ooropuloo/MFKVM/lay-board/r7f/kicad/README.txt

r7b design files, copied from out/ after the final check (board sha256 2acf1c0fcd2acbffd97f6878b55f344319c8f6496172503f295ab0cfc3b03e46).
They are the files fab_r7b/ was made from. Regenerate with gen_mini.py; do not edit these by hand.
