ooropuloo/MFKVM/lay-board/r7f/case/check_report.txt

===== NEW: mini/case/stl, must pass =====
board p4_kvm_mini.kicad_pcb sha256 bd67d82cb2569ef1, solids 508, outline 40.00 x 40.00, thru-plated 12
PASS  Gerber pad positions agree with STEP pad solids  [misses F 0 B 0, of 176 + 319]
PASS  board top is +z in the STEP
PASS  four screw holes found in the board  [[(18.0, 18.0, 2.2), (-18.0, 18.0, 2.2), (18.0, -18.0, 2.2), (-18.0, -18.0, 2.2)]]
real connector centres in the case frame: J2 (8.00, -12.86) nearest wall -y, J3 (-8.75, -14.61) nearest wall -y, J5 (-14.61, 2.50) nearest wall -x, J7 (19.01, 4.20) nearest wall +x, J4 (3.70, 14.90) nearest wall +y, J6 (-11.25, 13.30) nearest wall +y
standing outside the I/O face (-y) +x is on your right: J3 LEFT, J2 RIGHT
PASS  real J3 is left of real J2, seen from outside the I/O face
PASS  connector sides as the z windows below assume  [J3 J5 J6 top, J2 J7 J4 bottom]
PASS  tray STL and STEP are the same part  [volume differs 0.01%]
PASS  lid STL and STEP are the same part  [volume differs 0.03%]
PASS  J2 on the -y wall is the wall nearest its real position  [nearest -y]
PASS  J2 opening in -y wall clears the HDMI shell 15 x 6  [0.00 mm2 of wall in the way at u 8.00]
PASS  J2 opening centred on the connector  [offset +0.00, opening u -0.10..16.10 z 2.10..8.90]
PASS  J2 plug overmould 19.5 x 11.0 fits its pocket  [0.00 mm2 in the way]
PASS  J3 on the -y wall is the wall nearest its real position  [nearest -y]
PASS  J3 opening in -y wall clears the USB-C shell 8.94 x 3.2  [0.00 mm2 of wall in the way at u -8.75]
PASS  J3 opening centred on the connector  [offset +0.00, opening u -13.70..-3.80 z 9.25..13.35]
PASS  J3 plug overmould 12.0 x 8.0 fits its pocket  [0.00 mm2 in the way]
PASS  J5 on the -x wall is the wall nearest its real position  [nearest -x]
PASS  J5 opening in -x wall clears the USB-C shell 8.94 x 3.2  [0.00 mm2 of wall in the way at u 2.50]
PASS  J5 opening centred on the connector  [offset +0.00, opening u -2.45..7.45 z 9.25..13.35]
PASS  J5 plug overmould 12.0 x 8.0 fits its pocket  [0.00 mm2 in the way]
PASS  J7 on the +x wall is the wall nearest its real position  [nearest +x]
PASS  J7 opening in +x wall clears the card 11 wide at the shell  [0.00 mm2 of wall in the way at u 4.20]
PASS  J7 opening centred on the connector  [offset -0.10, opening u -2.20..10.40 z 6.30..8.45]
PASS  J4 on the +y wall is the wall nearest its real position  [nearest +y]
PASS  J4 opening in +y wall clears the SHR-06V plug 8 wide  [0.00 mm2 of wall in the way at u 3.70]
PASS  J4 opening centred on the connector  [offset -0.00, opening u -0.90..8.30 z 3.90..8.45]
PASS  HDMI and host USB plugs fit side by side  [1.00 mm between overmoulds]
PASS  label HDMI is cut in the -y wall beside J2  [text u 4.6..9.4 z 14.1..15.6, connector u 8.00]
PASS  label MF KVM is cut in the -y wall beside J2  [text u 1.2..12.8 z 15.9..18.3, connector u 8.00]
PASS  label HOST is cut in the -y wall beside J3  [text u -11.3..-6.1 z 16.4..18.1, connector u -8.75]
PASS  label 5V is cut in the -x wall beside J5  [text u 1.2..3.7 z 16.4..18.1, connector u 2.50]
PASS  label TF is cut in the +x wall beside J7  [text u 2.8..5.3 z 10.2..11.9, connector u 4.20]
PASS  label ATX is cut in the +y wall beside J4  [text u 1.7..5.7 z 9.7..11.4, connector u 3.70]
vents -y 0, +y 4, -x 9, +x 0
PASS  no vents on the +x (microSD) wall or the I/O wall
PASS  -x wall vent beside U7  [U7 real at (-5.50, -4.00), nearest slot 0.70 mm along the wall]
PASS  -x wall vent beside U2  [U2 real at (-14.00, 10.08), nearest slot 1.38 mm along the wall]
PASS  -x wall vent beside L1  [L1 real at (-13.60, 13.90), nearest slot 0.80 mm along the wall]
PASS  back wall vent behind the buck stage  [0.90 mm from L1 along the wall]
PASS  tray clearance bore at (18, 18) lines up  [d 2.4, offset 0.0]
PASS  tray head recess at (18, 18) takes the M2 head  [d 4.2]
PASS  tray post at (18, 18) seats the PCB at z 8.5  [10.7 of 11.4 mm2]
PASS  lid pilot at (18, 18) lines up at z 16.0  [d 1.6, wall 1.10]
PASS  lid post at (18, 18) is whole down at the PCB  [d 1.6, wall 1.10]
PASS  lid post at (18, 18) meets the PCB top  [6.9 of 6.9 mm2]
PASS  tray clearance bore at (-18, 18) lines up  [d 2.4, offset 0.0]
PASS  tray head recess at (-18, 18) takes the M2 head  [d 4.2]
PASS  tray post at (-18, 18) seats the PCB at z 8.5  [10.7 of 11.4 mm2]
PASS  lid pilot at (-18, 18) lines up at z 16.0  [d 1.6, wall 1.10]
PASS  J6 corner (-18, 18): the thread has no thin wall beside J6  [post starts above the J6 relief]
PASS  tray clearance bore at (18, -18) lines up  [d 2.4, offset 0.0]
PASS  tray head recess at (18, -18) takes the M2 head  [d 4.2]
PASS  tray post at (18, -18) seats the PCB at z 8.5  [10.7 of 11.4 mm2]
PASS  lid pilot at (18, -18) lines up at z 16.0  [d 1.6, wall 1.10]
PASS  lid post at (18, -18) is whole down at the PCB  [d 1.6, wall 1.10]
PASS  lid post at (18, -18) meets the PCB top  [6.9 of 6.9 mm2]
PASS  tray clearance bore at (-18, -18) lines up  [d 2.4, offset 0.0]
PASS  tray head recess at (-18, -18) takes the M2 head  [d 4.2]
PASS  tray post at (-18, -18) seats the PCB at z 8.5  [10.7 of 11.4 mm2]
PASS  lid pilot at (-18, -18) lines up at z 16.0  [d 1.6, wall 1.10]
PASS  lid post at (-18, -18) is whole down at the PCB  [d 1.6, wall 1.10]
PASS  lid post at (-18, -18) meets the PCB top  [6.9 of 6.9 mm2]
PASS  M2 x 16 tip stops inside the pilot  [seat z 1.8, tip z 17.8, pilot top z 18.4]
PASS  thread engagement in the J6 corner is at least 1.5 x d  [3.5 mm]
PASS  every part envelope holds its real pads after the design-to-case map  [106 parts]
PASS  no part body touches the tray or lid  [none]
PASS  real PCB solid (outline, holes, slots) against tray and lid  [tray 0.000, lid 0.000 mm3]
PASS  PCB z in the case is the stack height  [8.54..9.65]
PASS  tray against lid  [0.000 mm3]
PASS  LCD module (estimate) against lid and tray  [lid 0.000, tray 0.000 mm3]
PASS  LCD clears the tallest top-side part  [LCD bottom 15.40, tallest top 13.95]
J6 mouth faces -x, plug and wire keep-out x -19.02..-16.32 y 8.80..17.80 z 9.7..12.6
PASS  J6 plug and wires clear the lid  [0.00 mm3]
PASS  M2 shank clears the J6 envelope  [0.37 mm]
tray bbox 44.00 x 44.00 x 13.80, lid bbox 44.00 x 44.00 x 10.30
RESULT PASS: 71 passed, 0 failed, case files mini\case\stl

===== OLD mirrored case, kept to prove this check can fail =====
board p4_kvm_mini.kicad_pcb sha256 bd67d82cb2569ef1, solids 508, outline 40.00 x 40.00, thru-plated 12
PASS  Gerber pad positions agree with STEP pad solids  [misses F 0 B 0, of 176 + 319]
PASS  board top is +z in the STEP
PASS  four screw holes found in the board  [[(18.0, 18.0, 2.2), (-18.0, 18.0, 2.2), (18.0, -18.0, 2.2), (-18.0, -18.0, 2.2)]]
real connector centres in the case frame: J2 (8.00, -12.86) nearest wall -y, J3 (-8.75, -14.61) nearest wall -y, J5 (-14.61, 2.50) nearest wall -x, J7 (19.01, 4.20) nearest wall +x, J4 (3.70, 14.90) nearest wall +y, J6 (-11.25, 13.30) nearest wall +y
standing outside the I/O face (-y) +x is on your right: J3 LEFT, J2 RIGHT
PASS  real J3 is left of real J2, seen from outside the I/O face
PASS  connector sides as the z windows below assume  [J3 J5 J6 top, J2 J7 J4 bottom]
PASS  tray STL and STEP are the same part  [volume differs 0.01%]
PASS  lid STL and STEP are the same part  [volume differs 0.02%]
PASS  J2 on the -y wall is the wall nearest its real position  [nearest -y]
FAIL  J2 opening in -y wall clears the HDMI shell 15 x 6  [90.00 mm2 of wall in the way at u 8.00]
FAIL  J2 opening centred on the connector  [no opening at the connector centre]
FAIL  J2 plug overmould 19.5 x 11.0 fits its pocket  [120.50 mm2 in the way]
PASS  J3 on the -y wall is the wall nearest its real position  [nearest -y]
FAIL  J3 opening in -y wall clears the USB-C shell 8.94 x 3.2  [26.40 mm2 of wall in the way at u -8.75]
FAIL  J3 opening centred on the connector  [no opening at the connector centre]
FAIL  J3 plug overmould 12.0 x 8.0 fits its pocket  [46.80 mm2 in the way]
PASS  J5 on the -x wall is the wall nearest its real position  [nearest -x]
FAIL  J5 opening in -x wall clears the USB-C shell 8.94 x 3.2  [26.40 mm2 of wall in the way at u 2.50]
FAIL  J5 opening centred on the connector  [no opening at the connector centre]
FAIL  J5 plug overmould 12.0 x 8.0 fits its pocket  [69.60 mm2 in the way]
PASS  J7 on the +x wall is the wall nearest its real position  [nearest +x]
FAIL  J7 opening in +x wall clears the card 11 wide at the shell  [11.22 mm2 of wall in the way at u 4.20]
FAIL  J7 opening centred on the connector  [no opening at the connector centre]
PASS  J4 on the +y wall is the wall nearest its real position  [nearest +y]
FAIL  J4 opening in +y wall clears the SHR-06V plug 8 wide  [18.84 mm2 of wall in the way at u 3.70]
FAIL  J4 opening centred on the connector  [no opening at the connector centre]
PASS  HDMI and host USB plugs fit side by side  [1.00 mm between overmoulds]
FAIL  label HDMI is cut in the -y wall beside J2  [no cut there]
FAIL  label MF KVM is cut in the -y wall beside J2  [text u 6.2..11.4 z 16.4..18.1, connector u 8.00]
FAIL  label HOST is cut in the -y wall beside J3  [text u -12.8..-1.2 z 15.9..18.3, connector u -8.75]
FAIL  label 5V is cut in the -x wall beside J5  [no cut there]
FAIL  label TF is cut in the +x wall beside J7  [no cut there]
FAIL  label ATX is cut in the +y wall beside J4  [text u -5.7..-1.7 z 9.7..11.4, connector u 3.70]
vents -y 0, +y 5, -x 0, +x 6
FAIL  no vents on the +x (microSD) wall or the I/O wall
FAIL  -x wall vent beside U7  [U7 real at (-5.50, -4.00), nearest slot 99.00 mm along the wall]
FAIL  -x wall vent beside U2  [U2 real at (-14.00, 10.08), nearest slot 99.00 mm along the wall]
FAIL  -x wall vent beside L1  [L1 real at (-13.60, 13.90), nearest slot 99.00 mm along the wall]
FAIL  back wall vent behind the buck stage  [20.30 mm from L1 along the wall]
PASS  tray clearance bore at (18, 18) lines up  [d 2.4, offset 0.0]
PASS  tray head recess at (18, 18) takes the M2 head  [d 4.2]
PASS  tray post at (18, 18) seats the PCB at z 8.5  [10.7 of 11.4 mm2]
PASS  lid pilot at (18, 18) lines up at z 16.0  [d 1.6, wall 1.10]
FAIL  lid post at (18, 18) is whole down at the PCB  [d 1.6, wall 0.27]
PASS  lid post at (18, 18) meets the PCB top  [5.4 of 6.9 mm2]
PASS  tray clearance bore at (-18, 18) lines up  [d 2.4, offset 0.0]
PASS  tray head recess at (-18, 18) takes the M2 head  [d 4.2]
PASS  tray post at (-18, 18) seats the PCB at z 8.5  [10.7 of 11.4 mm2]
PASS  lid pilot at (-18, 18) lines up at z 16.0  [d 1.6, wall 1.10]
PASS  J6 corner (-18, 18): the thread has no thin wall beside J6  [post runs down beside J6]
PASS  tray clearance bore at (18, -18) lines up  [d 2.4, offset 0.0]
PASS  tray head recess at (18, -18) takes the M2 head  [d 4.2]
PASS  tray post at (18, -18) seats the PCB at z 8.5  [10.7 of 11.4 mm2]
PASS  lid pilot at (18, -18) lines up at z 16.0  [d 1.6, wall 1.10]
PASS  lid post at (18, -18) is whole down at the PCB  [d 1.6, wall 1.10]
PASS  lid post at (18, -18) meets the PCB top  [6.9 of 6.9 mm2]
PASS  tray clearance bore at (-18, -18) lines up  [d 2.4, offset 0.0]
PASS  tray head recess at (-18, -18) takes the M2 head  [d 4.2]
PASS  tray post at (-18, -18) seats the PCB at z 8.5  [10.7 of 11.4 mm2]
PASS  lid pilot at (-18, -18) lines up at z 16.0  [d 1.6, wall 1.10]
PASS  lid post at (-18, -18) is whole down at the PCB  [d 1.6, wall 1.10]
PASS  lid post at (-18, -18) meets the PCB top  [6.9 of 6.9 mm2]
PASS  M2 x 16 tip stops inside the pilot  [seat z 1.8, tip z 17.8, pilot top z 18.4]
PASS  thread engagement in the J6 corner is at least 1.5 x d  [3.5 mm]
PASS  every part envelope holds its real pads after the design-to-case map  [106 parts]
FAIL  no part body touches the tray or lid  [[('J3', 6.17, 3.04), ('J5', 6.17, 3.04), ('J6', 0.0, 2.65), ('J2', 18.0, 0.0)]]
PASS  real PCB solid (outline, holes, slots) against tray and lid  [tray 0.000, lid 0.000 mm3]
PASS  PCB z in the case is the stack height  [8.54..9.65]
PASS  tray against lid  [0.000 mm3]
PASS  LCD module (estimate) against lid and tray  [lid 0.000, tray 0.000 mm3]
PASS  LCD clears the tallest top-side part  [LCD bottom 15.40, tallest top 13.95]
J6 mouth faces -x, plug and wire keep-out x -19.02..-16.32 y 8.80..17.80 z 9.7..12.6
FAIL  J6 plug and wires clear the lid  [9.62 mm3]
PASS  M2 shank clears the J6 envelope  [0.37 mm]
tray bbox 44.00 x 44.00 x 13.80, lid bbox 44.00 x 44.00 x 10.30
RESULT FAIL: 44 passed, 27 failed, case files <temp>\case_old

===== r4 board re-check: case files unchanged (STL byte-identical when regenerated) =====
board p4_kvm_mini.kicad_pcb sha256 0134dfaaa7eec6bd, solids 508, outline 40.00 x 40.00, thru-plated 12
PASS  Gerber pad positions agree with STEP pad solids  [misses F 0 B 0, of 176 + 319]
PASS  board top is +z in the STEP
PASS  four screw holes found in the board  [[(18.0, 18.0, 2.2), (-18.0, 18.0, 2.2), (18.0, -18.0, 2.2), (-18.0, -18.0, 2.2)]]
real connector centres in the case frame: J2 (8.00, -12.86) nearest wall -y, J3 (-8.75, -14.61) nearest wall -y, J5 (-14.61, 2.50) nearest wall -x, J7 (19.01, 4.20) nearest wall +x, J4 (3.70, 14.90) nearest wall +y, J6 (-11.25, 13.30) nearest wall +y
standing outside the I/O face (-y) +x is on your right: J3 LEFT, J2 RIGHT
PASS  real J3 is left of real J2, seen from outside the I/O face
PASS  connector sides as the z windows below assume  [J3 J5 J6 top, J2 J7 J4 bottom]
PASS  tray STL and STEP are the same part  [volume differs 0.01%]
PASS  lid STL and STEP are the same part  [volume differs 0.03%]
PASS  J2 on the -y wall is the wall nearest its real position  [nearest -y]
PASS  J2 opening in -y wall clears the HDMI shell 15 x 6  [0.00 mm2 of wall in the way at u 8.00]
PASS  J2 opening centred on the connector  [offset +0.00, opening u -0.10..16.10 z 2.10..8.90]
PASS  J2 plug overmould 19.5 x 11.0 fits its pocket  [0.00 mm2 in the way]
PASS  J3 on the -y wall is the wall nearest its real position  [nearest -y]
PASS  J3 opening in -y wall clears the USB-C shell 8.94 x 3.2  [0.00 mm2 of wall in the way at u -8.75]
PASS  J3 opening centred on the connector  [offset +0.00, opening u -13.70..-3.80 z 9.25..13.35]
PASS  J3 plug overmould 12.0 x 8.0 fits its pocket  [0.00 mm2 in the way]
PASS  J5 on the -x wall is the wall nearest its real position  [nearest -x]
PASS  J5 opening in -x wall clears the USB-C shell 8.94 x 3.2  [0.00 mm2 of wall in the way at u 2.50]
PASS  J5 opening centred on the connector  [offset +0.00, opening u -2.45..7.45 z 9.25..13.35]
PASS  J5 plug overmould 12.0 x 8.0 fits its pocket  [0.00 mm2 in the way]
PASS  J7 on the +x wall is the wall nearest its real position  [nearest +x]
PASS  J7 opening in +x wall clears the card 11 wide at the shell  [0.00 mm2 of wall in the way at u 4.20]
PASS  J7 opening centred on the connector  [offset -0.10, opening u -2.20..10.40 z 6.30..8.45]
PASS  J4 on the +y wall is the wall nearest its real position  [nearest +y]
PASS  J4 opening in +y wall clears the SHR-06V plug 8 wide  [0.00 mm2 of wall in the way at u 3.70]
PASS  J4 opening centred on the connector  [offset -0.00, opening u -0.90..8.30 z 3.90..8.45]
PASS  HDMI and host USB plugs fit side by side  [1.00 mm between overmoulds]
PASS  label HDMI is cut in the -y wall beside J2  [text u 4.6..9.4 z 14.1..15.6, connector u 8.00]
PASS  label MF KVM is cut in the -y wall beside J2  [text u 1.2..12.8 z 15.9..18.3, connector u 8.00]
PASS  label HOST is cut in the -y wall beside J3  [text u -11.3..-6.1 z 16.4..18.1, connector u -8.75]
PASS  label 5V is cut in the -x wall beside J5  [text u 1.2..3.7 z 16.4..18.1, connector u 2.50]
PASS  label TF is cut in the +x wall beside J7  [text u 2.8..5.3 z 10.2..11.9, connector u 4.20]
PASS  label ATX is cut in the +y wall beside J4  [text u 1.7..5.7 z 9.7..11.4, connector u 3.70]
vents -y 0, +y 4, -x 9, +x 0
PASS  no vents on the +x (microSD) wall or the I/O wall
PASS  -x wall vent beside U7  [U7 real at (-5.50, -4.00), nearest slot 0.70 mm along the wall]
PASS  -x wall vent beside U2  [U2 real at (-14.00, 10.08), nearest slot 1.38 mm along the wall]
PASS  -x wall vent beside L1  [L1 real at (-13.60, 13.90), nearest slot 0.80 mm along the wall]
PASS  back wall vent behind the buck stage  [0.90 mm from L1 along the wall]
PASS  tray clearance bore at (18, 18) lines up  [d 2.4, offset 0.0]
PASS  tray head recess at (18, 18) takes the M2 head  [d 4.2]
PASS  tray post at (18, 18) seats the PCB at z 8.5  [10.7 of 11.4 mm2]
PASS  lid pilot at (18, 18) lines up at z 16.0  [d 1.6, wall 1.10]
PASS  lid post at (18, 18) is whole down at the PCB  [d 1.6, wall 1.10]
PASS  lid post at (18, 18) meets the PCB top  [6.9 of 6.9 mm2]
PASS  tray clearance bore at (-18, 18) lines up  [d 2.4, offset 0.0]
PASS  tray head recess at (-18, 18) takes the M2 head  [d 4.2]
PASS  tray post at (-18, 18) seats the PCB at z 8.5  [10.7 of 11.4 mm2]
PASS  lid pilot at (-18, 18) lines up at z 16.0  [d 1.6, wall 1.10]
PASS  J6 corner (-18, 18): the thread has no thin wall beside J6  [post starts above the J6 relief]
PASS  tray clearance bore at (18, -18) lines up  [d 2.4, offset 0.0]
PASS  tray head recess at (18, -18) takes the M2 head  [d 4.2]
PASS  tray post at (18, -18) seats the PCB at z 8.5  [10.7 of 11.4 mm2]
PASS  lid pilot at (18, -18) lines up at z 16.0  [d 1.6, wall 1.10]
PASS  lid post at (18, -18) is whole down at the PCB  [d 1.6, wall 1.10]
PASS  lid post at (18, -18) meets the PCB top  [6.9 of 6.9 mm2]
PASS  tray clearance bore at (-18, -18) lines up  [d 2.4, offset 0.0]
PASS  tray head recess at (-18, -18) takes the M2 head  [d 4.2]
PASS  tray post at (-18, -18) seats the PCB at z 8.5  [10.7 of 11.4 mm2]
PASS  lid pilot at (-18, -18) lines up at z 16.0  [d 1.6, wall 1.10]
PASS  lid post at (-18, -18) is whole down at the PCB  [d 1.6, wall 1.10]
PASS  lid post at (-18, -18) meets the PCB top  [6.9 of 6.9 mm2]
PASS  M2 x 16 tip stops inside the pilot  [seat z 1.8, tip z 17.8, pilot top z 18.4]
PASS  thread engagement in the J6 corner is at least 1.5 x d  [3.5 mm]
PASS  every part envelope holds its real pads after the design-to-case map  [106 parts]
PASS  no part body touches the tray or lid  [none]
PASS  real PCB solid (outline, holes, slots) against tray and lid  [tray 0.000, lid 0.000 mm3]
PASS  PCB z in the case is the stack height  [8.54..9.65]
PASS  tray against lid  [0.000 mm3]
PASS  LCD module (estimate) against lid and tray  [lid 0.000, tray 0.000 mm3]
PASS  LCD clears the tallest top-side part  [LCD bottom 15.40, tallest top 13.95]
J6 mouth faces -x, plug and wire keep-out x -19.02..-16.32 y 8.80..17.80 z 9.7..12.6
PASS  J6 plug and wires clear the lid  [0.00 mm3]
PASS  M2 shank clears the J6 envelope  [0.88 mm]
tray bbox 44.00 x 44.00 x 13.80, lid bbox 44.00 x 44.00 x 10.30
RESULT PASS: 71 passed, 0 failed, case files mini\case\stl

===== r5 board re-check: hole relief only, case files unchanged =====
board p4_kvm_mini.kicad_pcb sha256 4fcf3c612922adf4, solids 508, outline 40.00 x 40.00, thru-plated 12
PASS  Gerber pad positions agree with STEP pad solids  [misses F 0 B 0, of 176 + 319]
PASS  board top is +z in the STEP
PASS  four screw holes found in the board  [[(18.0, 18.0, 2.2), (-18.0, 18.0, 2.2), (18.0, -18.0, 2.2), (-18.0, -18.0, 2.2)]]
real connector centres in the case frame: J2 (8.00, -12.86) nearest wall -y, J3 (-8.75, -14.61) nearest wall -y, J5 (-14.61, 2.50) nearest wall -x, J7 (19.01, 4.20) nearest wall +x, J4 (3.70, 14.90) nearest wall +y, J6 (-11.25, 13.30) nearest wall +y
standing outside the I/O face (-y) +x is on your right: J3 LEFT, J2 RIGHT
PASS  real J3 is left of real J2, seen from outside the I/O face
PASS  connector sides as the z windows below assume  [J3 J5 J6 top, J2 J7 J4 bottom]
PASS  tray STL and STEP are the same part  [volume differs 0.01%]
PASS  lid STL and STEP are the same part  [volume differs 0.03%]
PASS  J2 on the -y wall is the wall nearest its real position  [nearest -y]
PASS  J2 opening in -y wall clears the HDMI shell 15 x 6  [0.00 mm2 of wall in the way at u 8.00]
PASS  J2 opening centred on the connector  [offset +0.00, opening u -0.10..16.10 z 2.10..8.90]
PASS  J2 plug overmould 19.5 x 11.0 fits its pocket  [0.00 mm2 in the way]
PASS  J3 on the -y wall is the wall nearest its real position  [nearest -y]
PASS  J3 opening in -y wall clears the USB-C shell 8.94 x 3.2  [0.00 mm2 of wall in the way at u -8.75]
PASS  J3 opening centred on the connector  [offset +0.00, opening u -13.70..-3.80 z 9.25..13.35]
PASS  J3 plug overmould 12.0 x 8.0 fits its pocket  [0.00 mm2 in the way]
PASS  J5 on the -x wall is the wall nearest its real position  [nearest -x]
PASS  J5 opening in -x wall clears the USB-C shell 8.94 x 3.2  [0.00 mm2 of wall in the way at u 2.50]
PASS  J5 opening centred on the connector  [offset +0.00, opening u -2.45..7.45 z 9.25..13.35]
PASS  J5 plug overmould 12.0 x 8.0 fits its pocket  [0.00 mm2 in the way]
PASS  J7 on the +x wall is the wall nearest its real position  [nearest +x]
PASS  J7 opening in +x wall clears the card 11 wide at the shell  [0.00 mm2 of wall in the way at u 4.20]
PASS  J7 opening centred on the connector  [offset -0.10, opening u -2.20..10.40 z 6.30..8.45]
PASS  J4 on the +y wall is the wall nearest its real position  [nearest +y]
PASS  J4 opening in +y wall clears the SHR-06V plug 8 wide  [0.00 mm2 of wall in the way at u 3.70]
PASS  J4 opening centred on the connector  [offset -0.00, opening u -0.90..8.30 z 3.90..8.45]
PASS  HDMI and host USB plugs fit side by side  [1.00 mm between overmoulds]
PASS  label HDMI is cut in the -y wall beside J2  [text u 4.6..9.4 z 14.1..15.6, connector u 8.00]
PASS  label MF KVM is cut in the -y wall beside J2  [text u 1.2..12.8 z 15.9..18.3, connector u 8.00]
PASS  label HOST is cut in the -y wall beside J3  [text u -11.3..-6.1 z 16.4..18.1, connector u -8.75]
PASS  label 5V is cut in the -x wall beside J5  [text u 1.2..3.7 z 16.4..18.1, connector u 2.50]
PASS  label TF is cut in the +x wall beside J7  [text u 2.8..5.3 z 10.2..11.9, connector u 4.20]
PASS  label ATX is cut in the +y wall beside J4  [text u 1.7..5.7 z 9.7..11.4, connector u 3.70]
vents -y 0, +y 4, -x 9, +x 0
PASS  no vents on the +x (microSD) wall or the I/O wall
PASS  -x wall vent beside U7  [U7 real at (-5.50, -4.00), nearest slot 0.70 mm along the wall]
PASS  -x wall vent beside U2  [U2 real at (-14.00, 10.08), nearest slot 1.38 mm along the wall]
PASS  -x wall vent beside L1  [L1 real at (-13.60, 13.90), nearest slot 0.80 mm along the wall]
PASS  back wall vent behind the buck stage  [0.90 mm from L1 along the wall]
PASS  tray clearance bore at (18, 18) lines up  [d 2.4, offset 0.0]
PASS  tray head recess at (18, 18) takes the M2 head  [d 4.2]
PASS  tray post at (18, 18) seats the PCB at z 8.5  [10.7 of 11.4 mm2]
PASS  lid pilot at (18, 18) lines up at z 16.0  [d 1.6, wall 1.10]
PASS  lid post at (18, 18) is whole down at the PCB  [d 1.6, wall 1.10]
PASS  lid post at (18, 18) meets the PCB top  [6.9 of 6.9 mm2]
PASS  tray clearance bore at (-18, 18) lines up  [d 2.4, offset 0.0]
PASS  tray head recess at (-18, 18) takes the M2 head  [d 4.2]
PASS  tray post at (-18, 18) seats the PCB at z 8.5  [10.7 of 11.4 mm2]
PASS  lid pilot at (-18, 18) lines up at z 16.0  [d 1.6, wall 1.10]
PASS  J6 corner (-18, 18): the thread has no thin wall beside J6  [post starts above the J6 relief]
PASS  tray clearance bore at (18, -18) lines up  [d 2.4, offset 0.0]
PASS  tray head recess at (18, -18) takes the M2 head  [d 4.2]
PASS  tray post at (18, -18) seats the PCB at z 8.5  [10.7 of 11.4 mm2]
PASS  lid pilot at (18, -18) lines up at z 16.0  [d 1.6, wall 1.10]
PASS  lid post at (18, -18) is whole down at the PCB  [d 1.6, wall 1.10]
PASS  lid post at (18, -18) meets the PCB top  [6.9 of 6.9 mm2]
PASS  tray clearance bore at (-18, -18) lines up  [d 2.4, offset 0.0]
PASS  tray head recess at (-18, -18) takes the M2 head  [d 4.2]
PASS  tray post at (-18, -18) seats the PCB at z 8.5  [10.7 of 11.4 mm2]
PASS  lid pilot at (-18, -18) lines up at z 16.0  [d 1.6, wall 1.10]
PASS  lid post at (-18, -18) is whole down at the PCB  [d 1.6, wall 1.10]
PASS  lid post at (-18, -18) meets the PCB top  [6.9 of 6.9 mm2]
PASS  M2 x 16 tip stops inside the pilot  [seat z 1.8, tip z 17.8, pilot top z 18.4]
PASS  thread engagement in the J6 corner is at least 1.5 x d  [3.5 mm]
PASS  every part envelope holds its real pads after the design-to-case map  [106 parts]
PASS  no part body touches the tray or lid  [none]
PASS  real PCB solid (outline, holes, slots) against tray and lid  [tray 0.000, lid 0.000 mm3]
PASS  PCB z in the case is the stack height  [8.54..9.65]
PASS  tray against lid  [0.000 mm3]
PASS  LCD module (estimate) against lid and tray  [lid 0.000, tray 0.000 mm3]
PASS  LCD clears the tallest top-side part  [LCD bottom 15.40, tallest top 13.95]
J6 mouth faces -x, plug and wire keep-out x -19.02..-16.32 y 8.80..17.80 z 9.7..12.6
PASS  J6 plug and wires clear the lid  [0.00 mm3]
PASS  M2 shank clears the J6 envelope  [0.88 mm]
tray bbox 44.00 x 44.00 x 13.80, lid bbox 44.00 x 44.00 x 10.30
RESULT PASS: 71 passed, 0 failed, case files mini\case\stl
