ooropuloo/MFKVM/lay-board/r7f/PROGRESS.md

# v2_r7f progress (six approved changes: eFuse, CEC ESD, SD 22 ohm, LCD 33 ohm, metal lid + spreader)

Copied from v2_r7e at 07:35 on 2026-11-09 (without .venv-case, rebuilt locally with tools/setup_case_env.sh). v2_r7e and older are not touched.
analysis_r7d copied to analysis_r7f (thermal .venv not copied; the r7d one is used read-only as the interpreter).

| Time | Phase | Status |
|---|---|---|
| 07:35 | 0. Copy and path fix | Done. check.sh, route_until_clean.sh, r6/route.sh, setup_case_env.sh point to v2_r7f. .venv-case built (cadquery 2.8.0). |
| 07:50 | 1. Parts and datasheets | TPS2595 (TI SLVSE57C) and TPD1E10B06 (SLLSEB1G) datasheets in datasheets_r7f/. eFuse: TPS259531DSGR (5.7 V output clamp, auto-retry, active-high EN), LCSC C2155674. Read-only stock search: tools/jlc_search.py. Placement study: LCD resistors do not fit in the 0.43 mm gap between U1 and J6 pads; SD resistors go on B beside the first via. |
| 08:40 | 2. eFuse, CEC, holes | U16 TPS259531DSGR on B between the J5 shell legs (C70 1 uF in, C71 100 nF dV/dt 0.42 V/ms, R71/R72 100k/47k UVLO 3.75/3.44 V, R73 1k ILIM 2.04 A typ / 1.89 A min). J5 side of the old 5V is now VBUS_IN; 5V leaves pin 5 through two 0.5 mm vias and In2 to the old 5V track and to the U6 branch. D1 TPD1E10B06 on F between the CEC via and a GND via. H1-H4 plated, GND, 3.1 mm pad (0.2 mm from the corner chamfer). |
| 09:00 | 3. Cold start | tools/coldstart.py sim_ef(): attach transient 3.6-4.5 A for ~10 us, 4.7-6.1 uC before the eFuse conducts, vs 8-13 A / 83-92 uC for the USB 2.0 10 uF + 44 ohm reference on the same port: no worse in every corner. Full load starts cleanly on bench / 3 A / 1.5 A sources (3V3 at 8.7 ms, CHIP_PU 21 ms); on 1.0 A and 0.55 A ports it does not (5V parks near 2.4 V). tools/hotplug.py: VBUS_IN ring 10.3 V worst (IN abs max 20 V), EN 3.3 V (abs max 7 V). |
| 09:50 | 4. SD resistors | No 0402 fits between a module SD pad and its first via (via 0.1 mm from the pad end; LDO_VO4 on F, J7 body on B). R74-R79 in a block on B / F next to the escape vias; Freerouting (data/r7f_route.ses) and a grid A* (tools/r7f_astar.py, data/r7f_hand.json) for what the router left open. Several placement rounds; see the report. |
| 09:50 | 5. Case | gen_case.py: Al lid from z 14.6, 0.8 mm plate at 13.8-14.6 with J6 cut-out and post holes, post shoulders clamp the plate, 12 slots (72 mm2) behind the LCD seat, gap filler P4 12x12 + C6 7x7, materials in case_spec.json. check_case.py: 17 new checks; 88/88 on the r7f board. |
| 10:20 | 6. LCD resistors | Option A (no reply to the question): R80/R81 33 ohm 0201 (C320843) in line at U1.24/25, J6 +0.65 mm, J6 plane escapes re-made (r7e _escape), C63.1 strap moved to J6.8's new via. check_case's J6 shank check was an x gap written for the old hole at y 18; now the true 2-D distance (the case mutation moves J6 toward the screw in x and y). |
| 10:40 | 7. SD routing closed | Final: R76/R77/R78 rows on B west of the D0/D1/D2 escape vias, R74 (CLK) on B east of them, R75 (CMD) at the B west edge, R79 (D3) on F in place of D3's escape vertical; R78 0.3 mm lower so a via fits for R77 pad 2. Router pass data/r7f_route.ses + A* SD_CLK_C (data/r7f_hand.json). C6.2 lost its via to R79; new via found by the r7e escape search. Full regeneration: DRC 0 errors, 0 unconnected; verify ALL PASS. |
| 10:50 | 8. SI | analysis_r7f/si: extract + model_build with SI_R7F=1 (results_r7f/), run_se_r7f.py. SD write overshoot (drive level 3, 0.5 ns, 10 mm module trace) 0.79-1.16 V before, 0.05-0.23 V after; LCD CLK at level 2 1.51 -> 0.61 V, CLK->CS 0.80 -> 0.62 V (VIL 0.99). |
| 10:55 | 9. Thermal | analysis_r7f/thermal on the r7f board and power (+U16 I^2 RON): results_r7f.json. f1 as built (gap filler only on P4/C6) is 2-3 C warmer than the report's f1 (filler over the whole shield). Top surface S load: a0 52.9/67.4, f1 as built 49.5/63.6 C at 25/40 C. |
| 11:00 | 10. Gates | New: tools/csi_via.py (non-GND vias >= 0.62 mm from CSI; one pre-existing r7d VDD_MIPI via at 0.585 mm listed as known). New mutations: r7f family (verify, csi_via, case) and hotplug/fabpack for the eFuse form. First full release run refused at fab_pack (its hot-plug line test expected the r7e text); fixed, re-running. |
| 11:10 | 11. Release | Second full run: one mutation missed ('host VBUS joined to box 5V': the check compared host VBUS only with J5's net, now VBUS_IN). Check fixed (host VBUS must touch neither VBUS_IN nor 5V). Third full run: RELEASE ALL GATES PASS, mutation 104 runs 0 bad. fab_r7f gerber sha256 4802d9ba…, board 7417758b…. SI board copy and final board have identical SD/LCD copper. |
| 11:15 | 12. Report | R7F_REPORT.md written. |
| 11:40 | 13. Team-lead conditions (received late: none of the earlier messages reached this agent while it ran) | Option A conditions applied: R80/R81 turned 90 deg, centred in the U1-J6 gap: 0.387 mm pad to pad (and mask web) to U1.24/25 and to J6, R80-R81 pads 0.16 mm. New gate tools/hand_solder_gap.py (fails < 0.2 mm; old placement 0.117 mm fails) with 2 mutations. VDD_MIPI via moved (8.18 -> 8.25, -1.686): 0.584 -> 0.654 mm from CSI_CK_P; csi_via.py allowlist removed, mutation puts the via back and is caught. CSI skew (0.091 / 0.099 mm) and refplane (0 / 9 spots, 0.0607 mm2) unchanged. DRC: R80+R81 courtyard overlap accepted (pads 0.16 mm, bodies 0.4 mm); the 4 R80/R81-vs-U1/J6 entries and the stale J5.A1B12 entry removed. Full release + SI re-extraction on the new board running. |
| 11:40 | 14. Release (with the conditions) | RELEASE ALL GATES PASS, mutation 108 runs 0 bad. hand_solder_gap: 0.387 mm pad-to-pad and mask web to U1.24/25, R80-R81 0.160 mm. csi_via: closest non-GND via 0.654 mm, no allowlist. CSI skew 0.091/0.099 mm and refplane unchanged. check_case 88/88 (shank 3.32 mm 2-D). fab_r7f regenerated: gerber sha256 d132d385…d0e0 (the earlier 4802d9ba… pack is void), board d6fa5a05…b84e, PDF build 20261109-1135. SI re-extracted from the final board (SD/LCD copper identical to out/): same numbers; SD_CMD (R 8.8 mm from pad) 0.22 V write, not worse than the others. R7F_REPORT.md updated (hand-solder caution, check_case change table, extended-part fee). |
| 12:45 | 15. Review fixes (REVIEW_r7f) | A: verify gains eFuse checks (bypass any pin order, ILM 487-5000 ohm one resistor, dVdt one cap >= 3300 pF, EN divider + UVLO 3.0-4.6 V; level networks too large to bound -> FAIL instead of crash); 8 new mutations; reviewer's own 14 injections re-run from a copy (report_r7f/review_rerun/): 12 caught, all 10 eFuse ones; the 2 not caught are out-of-scope probes (R81 toward J6, R79 toward U1.70). B: case_spec masked contact faces (post ends, shoulders, lid rim, pilot bores), bare plate, acceptance lid/plate to GND < 1 ohm; 3 check_case checks + 2 mutations. C: kicad/ gets the full mini.pretty, kicad/ ERC 0 (new gate); U16 EP paste per TI DSG0008A stencil (2 windows, 87 %), no EP vias (TI note 5 optional, would need plugging); MH copper 3.1 -> 2.9 mm, copper to chamfer 0.218 -> 0.318 mm. Release: ALL GATES PASS, mutation 118 / 0 bad, case 91/91. fab_r7f gerber sha256 042293aa…fc7a, board f7934a16…8a, PDF build 20261109-1231. Major 1 (U16 CPL at order time) and Major 4 (touch temperature) left as user items in the report. |
| 13:45 | 16. Three follow-ups (C70, fan, hand-solder gate) | C70: TI SLVSE57C asks only >= 0.01 uF CIN (11.1; 0.001-0.1 uF in 9.2.3), so 1 uF met it; the earlier "USB 1 uF minimum" was unsourced and is corrected. To keep >= 1 uF at 5 V bias anyway, C70 -> 2.2 uF 25 V X5R 0402 GRM155R61E225KE11D (C385032, extended, stock 75,844, same pad); 55 % bias retention assumed (1.21 uF). Coldstart re-run: attach 4.1-5.3 A / 6.5-7.9 uC vs reference 8-13 A / 83-92 uC, all corners OK; hotplug VBUS_IN 10.26 V, EN 3.28 V. Extended types 25 -> 29, about +12 USD per order. Fan (own USB supply, board 5V budget unchanged), S load, 25/40 C: f1 no fan top 49.5/63.6 bottom 60.9/75.3; (a) outside 1.5 m/s top 40.4/55.0 bottom 54.5/69.3 (1.0 m/s 41.5/56.1, 55.3/70.0) -> 25 C FAIL (bottom > 48), 40 C FAIL; (b) ducted 0.15 L/s top 36.2/50.9 bottom 41.5/56.5 (P4 54.5/69.3, U7 60.2/75.0, shield 44.5/59.3) -> 25 C PASS, 40 C FAIL > 1 min but PASS 10 s-1 min (metal 51 by 0.1 C, plastic 60); 0.08 L/s top 39.4/54.0 bottom 45.8/60.7 -> 25 C PASS. Assumptions: (a) laminar flat plate h 17.6-24.9 W/m2K on the lid top, half on lid walls; (b) flow 0.15 L/s as f4, 0.08 as weak case. Recommend (b). Case: new printed part case/stl/mf_kvm_fanduct.stl/.step (33 x 30 x 5 mm, VHB on the lid top over the 12 slots, 0.5 mm behind the LCD window, floor under the ~20 mm overhang, 30 mm fan seat with 4 holes on 24 mm, inlets = existing tray vents); case_spec.json fan entry. check_case +8 duct checks (99/99) and mutate +2 (duct missing, fan on board 5V). hand_solder_gap: now every top-side pad (except U1 and mounting holes) within 1 mm of any U1 pad, >= 0.2 mm and mask web >= 0.1 mm: 22 pads, worst 0.387 mm (R80/R81), then J5 0.623, C3 0.64, R79 0.89 mm; nothing moved. +2 mutations (R79 +0.75, C3 +0.5 toward U1). Release: ALL GATES PASS, mutation 122 / 0 bad, case 99/99. fab_r7f gerber sha256 02b51106...e918 (042293aa... void), board 055cc824...2dc6, PDF build 20261109-1335. R7F_REPORT sections 0b, 4, 6.1, BOM updated. |
| 16:45 | 17. DELTA_r7f gate gaps (checks only, no board change) | verify: ILIM low end (Eq. 4 at R max, -7.5 %) > full load 1.51 A x 1.1 (1k: 1.87 A); dVdt ramp tD,ON + 5 V / SR at CdVdt +10 % <= 30 ms budget (assumed: half the 60 ms coldstart window; 100 nF: 13.4 ms); U16 EP: pad without paste, exactly 2 same-side paste windows inside it, 80-95 % (87.5 %); mounting-hole ring <= 2.9 mm or copper to edge >= 0.3 mm (2.9 / 0.318). coldstart.py reads R71/R72/R73/C71/C70 from design.json by the eFuse pins (--design) and prints a cross-check with verify's 1.51 A; results unchanged (0.01 ms noise). mutate +4 (R73 2.2k -> 0.87 A, C71 2.2 uF -> 288 ms, EP paste removed -> 0 %, H1 3.1 mm -> 0.218 mm): all caught. Release ALL GATES PASS, mutation 126 / 0 bad, case 99/99; PDF build 20261109-1615. Gerber zip now 5edbd116...99f7, board 9233a26a...6c97: the release regenerates the board (random uuid4 in gen_mini uid(), KiCad save order follows) and every gerber has a CreationDate, so the sha changes on every release with no design change. Geometric diff vs the 02b51106 gerbers (REVIEW_r7f/work2/gb): board structure 0 differences; Cu/Mask/Paste 10 layers symmetric difference 0.000000 mm2 and all pad flashes matched; silk, edge, drill, gbrjob identical (dates ignored); self-test catches a 0.05 mm pad shift. Team lead checked all 15 layers independently and accepted 5edbd116 / 9233a26a (02b51106 file void; making the export reproducible deferred). Report: sections 0c (DELTA gates, known sha property) and 0d (rated ambient 25 C: TS1 passes with the duct (b), 40 C informational, passive fails the rating, fan model to be chosen with a published P-Q curve >= 50 Pa). |
