ooropuloo/MFKVM/lay-board/r7f/pdf/r7f_CPL極性與第1腳_閘門輸出.pdf

# CPL rotation and pin 1 of polarized parts (tools/cpl_pin1.py)

來源：v2_r7f/fab_r7f/CPL_polarity_pin1_r7f.md（原文英文）

CPL rotation and pin 1 of every polarized part (r7e, REVIEW_r7d M1).

For each polarized part on the CPL (ICs, connectors, the crystal oscillator, polarized capacitors; plain R/C/L/FB/TP are not polarized):

pin 1 (A1 for the BGA, A1B12 for USB-C) from design.json, as an offset from the part centre in the JLC top preview (x right, y down, = KiCad screen) and in the JLC bottom preview (x mirrored);
pin 1 in the footprint's own frame (rotation and bottom mirror undone; the convention is checked: every part of one footprint gives the same vector whatever its angle and side);
the JLC angle offset (CPL = KiCad + offset) from data/jlc_offsets.json. Only parts a person verified in JLC's preview have one; for every other part the offset is UNKNOWN (not 0) and the row says CHECK IN PREVIEW. FAIL when: a verified part's CPL angle is not KiCad + offset; its pin 1 (footprint frame) is not where it was when verified (footprint changed); a polarized part is missing from the CPL; a polarized capacitor has pin 1 on GND or pin 2 off GND, or its + pin does not reach a positive supply through at most one resistor (C69: + on 5V_DAMP, R68 to 5V, REVIEW_r7d M1).
R ef | LCS C | Land | Sid e | KiC ad deg | CP L de g | JLC offse t | Pi n 1 | Net | Pin 1 in JLC top view (mm) | Pin 1 in JLC bottom view | Status
C 69 | C34 755 2 | CP_7343 | Bot to m | 0 | 0 | UNK NO WN | 1 | 5V_DA MP | right (+3.10, +0.00) | left (-3.10, +0.00) | CHECK IN PREVIEW: JLC offset not verified, pin 1 must appear where the two view columns say
D 1 | C48 260 | X1SON-2_0.6x1 | Top | 0 | 0 | UNK NO WN | 1 | HDMI_ CEC | left (-0.35, +0.00) | - CHECK IN PREVIEW: JLC offset | not verified, pin 1 must appear where the two view columns say
J2 | C72 061 6 | HDMI-001S | Bot to m | 180 | 180 | UNK NO WN | 1 | D2_P | down-right (+4.50, +3.36) | down-left (-4.50, +3.36) | CHECK IN PREVIEW: JLC offset not verified, pin 1 must appear where the two view columns say
J3 | C41 427 493 | USB-C_HX_16P | Top | 180 | 180 | UNK NO WN | A1 B1 2 | GND | down-right (+3.20, +2.55) | - CHECK IN PREVIEW: JLC offset | not verified, pin 1 must appear where the two view columns say
J4 | C16 040 5 | JST_SM06B | Bot to m | 0 | 0 | UNK NO WN | 1 | PWR_C | up-right (+2.50, -2.00) | up-left (-2.50, -2.00) | CHECK IN PREVIEW: JLC offset not verified, pin 1 must appear where the two view columns say
J5 | C41 427 493 | USB-C_HX_16P | Top | 90 | 90 | UNK NO WN | A1 B1 2 | GND | down-left (-2.55, +3.20) | - CHECK IN PREVIEW: JLC offset | not verified, pin 1 must appear where the two view columns say
J6 | C16 040 7 | JST_SM08B | Top | 90 | 90 | UNK NO WN | 1 | 3V3 | down-left (-2.00, +3.50) | - CHECK IN PREVIEW: JLC offset | not verified, pin 1 must appear where the two view columns say
J7 | C58 535 0 | microSD_ Molex_104 031-0811 | Bot to m | 270 | 90 | 180 | 1 | SD_D2_ C | up-left (-5.45, -3.10) | up-right (+5.45, -3.10) | OK (offset verified in JLC preview 2026-11-07)

MF KVM v2 r7f · Gerber 5edbd116 · 第 1 / 3 頁

R ef | LCS C | Land | Sid e | KiC ad deg | CP L de g | JLC offse t | Pi n 1 | Net | Pin 1 in JLC top view (mm) | Pin 1 in JLC bottom view | Status
J8 | C88 373 | U.FL-R-SMT-1 | Bot to m | 0 | 0 | UNK NO WN | 1 | LNA_O UT | down (+0.00, +1.52) | down (-0.00, +1.52) | CHECK IN PREVIEW: JLC offset not verified, pin 1 must appear where the two view columns say
Q 1 | C15 127 | SOT-23 | Bot to m | 0 | 270 | 270 | 1 | SD_PW R_N | down-right (+0.95, +0.94) | down-left (-0.95, +0.94) | OK (offset verified in JLC preview 2026-11-07)
U 10 | C92 243 | SSOP-4_1.27 | Bot to m | 0 | 270 | 270 | 1 | PWR_L ED | up-right (+3.17, -0.63) | up-left (-3.17, -0.63) | OK (offset verified in JLC preview 2026-11-07)
U 11 | C92 243 | SSOP-4_1.27 | Bot to m | 0 | 270 | 270 | 1 | RST_LE D | up-right (+3.17, -0.63) | up-left (-3.17, -0.63) | OK (offset verified in JLC preview 2026-11-07)
U 12 | C92 243 | SSOP-4_1.27 | Bot to m | 0 | 270 | 270 | 1 | LED_IN | up-right (+3.18, -0.64) | up-left (-3.18, -0.64) | OK (offset verified in JLC preview 2026-11-07)
U 14 | C13 871 4 | USON-10 | Top | 0 | 0 | UNK NO WN | 1 | USB2_ DP | down-left (-1.00, +0.41) | - CHECK IN PREVIEW: JLC offset | not verified, pin 1 must appear where the two view columns say
U 15 | C78 988 | SOT-23-5 | Top | 90 | 0 | UNK NO WN | 1 | 3V3 | down-right (+1.14, +0.95) | - CHECK IN PREVIEW: JLC offset | not verified, pin 1 must appear where the two view columns say
U 16 | C21 556 74 | WSON-8_2x2_EP | Bot to m | 90 | 90 | UNK NO WN | 1 | EF_DVD T | down-right (+0.75, +0.95) | down-left (-0.75, +0.95) | CHECK IN PREVIEW: JLC offset not verified, pin 1 must appear where the two view columns say
U 2 | C78 988 | SOT-23-5 | Bot to m | 0 | 270 | 270 | 1 | 5V | down-right (+0.95, +1.14) | down-left (-0.95, +1.14) | OK (offset verified in JLC preview 2026-11-07)
U 3 | C13 871 4 | USON-10 | Bot to m | 90 | 90 | UNK NO WN | 1 | USB_D N | down-left (-0.41, +1.00) | down-right (+0.41, +1.00) | CHECK IN PREVIEW: JLC offset not verified, pin 1 must appear where the two view columns say
U 4 | C88 282 5 | SOT-23-5 | Bot to m | 0 | 270 | 270 | 1 | 3V3 | down-right (+0.95, +1.14) | down-left (-0.95, +1.14) | OK (offset verified in JLC preview 2026-11-07)
U 6 | C20 169 8 | MSOP-8 | Bot to m | 90 | 90 | UNK NO WN | 1 | 3V3 | down-left (-2.11, +0.98) | down-right (+2.11, +0.98) | CHECK IN PREVIEW: JLC offset not verified, pin 1 must appear where the two view columns say
U 7 | C30 086 06 | BGA-64_6x6 | Bot to m | 180 | 180 | UNK NO WN | A1 | TC_REX T | down-left (-2.27, +2.27) | down-right (+2.27, +2.27) | CHECK IN PREVIEW: JLC offset not verified, pin 1 must appear where the two view columns say

MF KVM v2 r7f · Gerber 5edbd116 · 第 2 / 3 頁

R ef | LCS C | Land | Sid e | KiC ad deg | CP L de g | JLC offse t | Pi n 1 | Net | Pin 1 in JLC top view (mm) | Pin 1 in JLC bottom view | Status
U 8 | C13 871 4 | USON-10 | Bot to m | 180 | 180 | UNK NO WN | 1 | D1_N | up-left (-1.00, -0.41) | up-right (+1.00, -0.41) | CHECK IN PREVIEW: JLC offset not verified, pin 1 must appear where the two view columns say
U 9 | C13 871 4 | USON-10 | Bot to m | 180 | 180 | UNK NO WN | 1 | CK_N | up-left (-1.00, -0.41) | up-right (+1.00, -0.41) | CHECK IN PREVIEW: JLC offset not verified, pin 1 must appear where the two view columns say
Y1 | C72 599 5 | OSC3225 | Bot to m | 0 | 0 | UNK NO WN | 1 | OSC_V DD | down-right (+1.05, +0.83) | down-left (-1.05, +0.83) | CHECK IN PREVIEW: JLC offset not verified, pin 1 must appear where the two view columns say
C 69 | C34 755 2 | CP_7343 | | | | | +/ - | + 5V_DA MP, -GND | | | polarity OK

RESULT PASS: 24 polarized parts, 7 with a verified JLC offset, 17 UNKNOWN (check in JLC preview)

MF KVM v2 r7f · Gerber 5edbd116 · 第 3 / 3 頁
