ooropuloo/MFKVM/lay-board/r7f/pdf/r7f_CPL第1腳檢查表.pdf

# CPL rotation and pin-1 check table (r7d)

來源：v2_r7f/fab_r7f/CPL_pin1_check.md（原文英文）

r7b M2: one row per placed part: CPL angle, KiCad angle, and where pin 1 must appear in JLC's placement preview.

Pin 1 is read from the saved board (pad "1", or A1 for the BGA, or the first pad of the connectors), as an offset from the part centre in board coordinates seen from the top (x right, y toward the back wall = down in KiCad and in JLC's top preview). For bottom-side parts the same offset is also given as seen in JLC's bottom preview, which shows the board flipped about the vertical axis (x mirrored). The JLC angle convention is per LCSC part (r6/r7 history: C2871228 at 0 and C78988 at 270 on the same SOT-23-5 land), so nothing here predicts JLC's angle; the table only says what the preview must show. "verified" means checked by a person in JLC's preview (2026-11-07).

Re f | LCSC | Land | Sid e | KiCa d deg | CPL deg | CPL-KiCa d | Pin | Pin 1 from centre, top view (mm) | Same pin in JLC bottom view | Status
C 69 | C347 552 | CP_7343 | Bot to m | 0 | 0.0 | 0.0 | 1 | right (+3.10, +0.00) | left (-3.10, +0.00) | CHECK in preview; new in r7c: polarized (pin 1 = +, silk + beside it)
D 1 | C482 60 | X1SON-2_0.6x1 | Top | 0 | 0.0 | 0.0 | 1 | left (-0.35, +0.00) | | CHECK in preview
J2 | C720 616 | HDMI-001S | Bot to m | 180 | 180 .0 | 0.0 | 1 | down-right (+4.50, +3.36) | down-left (-4.50, +3.36) | CHECK in preview
J3 | C414 2749 3 | USB-C_HX_16P | Top | 180 | 180 .0 | 0.0 | A1 B1 2 | down-right (+3.20, +2.55) | | CHECK in preview
J4 | C160 405 | JST_SM06B | Bot to m | 0 | 0.0 | 0.0 | 1 | up-right (+2.50, -2.00) | up-left (-2.50, -2.00) | CHECK in preview
J5 | C414 2749 3 | USB-C_HX_16P | Top | 90 | 90. 0 | 0.0 | A1 B1 2 | down-left (-2.55, +3.20) | | CHECK in preview
J6 | C160 407 | JST_SM08B | Top | 90 | 90. 0 | 0.0 | 1 | down-left (-2.00, +3.50) | | CHECK in preview
J7 | C585 350 | microSD_M olex_104031 -0811 | Bot to m | 270 | 90. 0 | 180. 0 | 1 | up-left (-5.45, -3.10) | up-right (+5.45, -3.10) | CHECK in preview (seen right on 2026-11-07; re-check, review M2)
J8 | C883 73 | U.FL-R-SMT-1 | Bot to m | 0 | 0.0 | 0.0 | 1 | down (+0.00, +1.52) | down (-0.00, +1.52) | CHECK in preview
Q 1 | C151 27 | SOT-23 | Bot to m | 0 | 270 .0 | 270. 0 | 1 | down-right (+0.95, +0.94) | down-left (-0.95, +0.94) | CHECK in preview (seen right on 2026-11-07; re-check, review M2)
U 10 | C922 43 | SSOP-4_1.27 | Bot to m | 0 | 270 .0 | 270. 0 | 1 | up-right (+3.17, -0.63) | up-left (-3.17, -0.63) | CHECK in preview (seen right on 2026-11-07; re-check, review M2)

MF KVM v2 r7f · Gerber 5edbd116 · 第 1 / 8 頁

Re f | LCSC | Land | Sid e | KiCa d deg | CPL deg | CPL-d | Pin | Pin 1 from centre, top view (mm) | Same pin in JLC bottom view | Status
U 11 | C922 43 | SSOP-4_1.27 | Bot to m | 0 | 270 .0 | 270. 0 | 1 | up-right (+3.17, -0.63) | up-left (-3.17, -0.63) | CHECK in preview (seen right on 2026-11-07; re-check, review M2)
U 12 | C922 43 | SSOP-4_1.27 | Bot to m | 0 | 270 .0 | 270. 0 | 1 | up-right (+3.18, -0.64) | up-left (-3.18, -0.64) | CHECK in preview (seen right on 2026-11-07; re-check, review M2); moved 0.08 mm in r7c
U 14 | C138 714 | USON-10 | Top | 0 | 0.0 | 0.0 | 1 | down-left (-1.00, +0.41) | | CHECK in preview
U 15 | C789 88 | SOT-23-5 | Top | 90 | 0.0 | 270. 0 | 1 | down-right (+1.14, +0.95) | | CHECK in preview
U 16 | C215 5674 | WSON-8_2x2_EP | Bot to m | 90 | 90. 0 | 0.0 | 1 | down-right (+0.75, +0.95) | down-left (-0.75, +0.95) | CHECK in preview
U 2 | C789 88 | SOT-23-5 | Bot to m | 0 | 270 .0 | 270. 0 | 1 | down-right (+0.95, +1.14) | down-left (-0.95, +1.14) | CHECK in preview (seen right on 2026-11-07; re-check, review M2)
U 3 | C138 714 | USON-10 | Bot to m | 90 | 90. 0 | 0.0 | 1 | down-left (-0.41, +1.00) | down-right (+0.41, +1.00) | CHECK in preview
U 4 | C882 825 | SOT-23-5 | Bot to m | 0 | 270 .0 | 270. 0 | 1 | down-right (+0.95, +1.14) | down-left (-0.95, +1.14) | CHECK in preview (seen right on 2026-11-07; re-check, review M2)
U 6 | C201 698 | MSOP-8 | Bot to m | 90 | 90. 0 | 0.0 | 1 | down-left (-2.11, +0.98) | down-right (+2.11, +0.98) | CHECK in preview
U 7 | C300 8606 | BGA-64_6x6 | Bot to m | 180 | 180 .0 | 0.0 | A1 | down-left (-2.27, +2.27) | down-right (+2.27, +2.27) | CHECK in preview; moved -2.5 mm in x in r7d
U 8 | C138 714 | USON-10 | Bot to m | 180 | 180 .0 | 0.0 | 1 | up-left (-1.00, -0.41) | up-right (+1.00, -0.41) | CHECK in preview
U 9 | C138 714 | USON-10 | Bot to m | 180 | 180 .0 | 0.0 | 1 | up-left (-1.00, -0.41) | up-right (+1.00, -0.41) | CHECK in preview
Y1 | C725 995 | OSC3225 | Bot to m | 0 | 0.0 | 0.0 | 1 | down-right (+1.05, +0.83) | down-left (-1.05, +0.83) | CHECK in preview
C 1 | C197 02 | C0603 | Top | 90 | 90. 0 | 0.0 | 1 | down (+0.00, +0.78) | | non-polar, either way works
C 10 | C197 02 | C0603 | Bot to m | 0 | 0.0 | 0.0 | 1 | right (+0.78, +0.00) | left (-0.78, +0.00) | non-polar, either way works
C 11 | C197 02 | C0603 | Bot to m | 0 | 0.0 | 0.0 | 1 | right (+0.78, +0.00) | left (-0.78, +0.00) | non-polar, either way works
C 12 | C197 02 | C0603 | Bot to m | 0 | 0.0 | 0.0 | 1 | right (+0.78, +0.00) | left (-0.78, +0.00) | non-polar, either way works

MF KVM v2 r7f · Gerber 5edbd116 · 第 2 / 8 頁

| | | | deg | | d | | view (mm) | view
C 13 | C153 7 | R0402 | Bot to m | 0 | 0.0 | 0.0 | 1 | right (+0.48, +0.00) | left (-0.48, +0.00) | non-polar, either way works; new place and rotation in r7d
C 14 | C196 66 | C0603 | Bot to m | 90 | 90. 0 | 0.0 | 1 | down (+0.00, +0.78) | down (-0.00, +0.78) | non-polar, either way works
C 15 | C153 7 | R0402 | Bot to m | 0 | 0.0 | 0.0 | 1 | right (+0.48, +0.00) | left (-0.48, +0.00) | non-polar, either way works; new place and rotation in r7d
C 16 | C196 66 | C0603 | Bot to m | 90 | 90. 0 | 0.0 | 1 | down (+0.00, +0.78) | down (-0.00, +0.78) | non-polar, either way works; new place and rotation in r7d
C 17 | C153 7 | R0402 | Bot to m | 180 | 180 .0 | 0.0 | 1 | left (-0.48, +0.00) | right (+0.48, +0.00) | non-polar, either way works; new place and rotation in r7d
C 18 | C196 66 | C0603 | Bot to m | 0 | 0.0 | 0.0 | 1 | right (+0.78, +0.00) | left (-0.78, +0.00) | non-polar, either way works; moved -2.5 mm in x in r7d
C 19 | C153 7 | R0402 | Bot to m | 0 | 0.0 | 0.0 | 1 | right (+0.48, +0.00) | left (-0.48, +0.00) | non-polar, either way works
C 2 | C197 02 | C0603 | Top | 90 | 90. 0 | 0.0 | 1 | down (+0.00, +0.78) | | non-polar, either way works
C 20 | C196 66 | C0603 | Bot to m | 0 | 0.0 | 0.0 | 1 | right (+0.78, +0.00) | left (-0.78, +0.00) | non-polar, either way works; moved 0.05 mm in r7c
C 21 | C152 5 | R0402 | Bot to m | 90 | 90. 0 | 0.0 | 1 | down (+0.00, +0.48) | down (-0.00, +0.48) | non-polar, either way works; new place and rotation in r7d
C 22 | C152 5 | R0402 | Bot to m | 0 | 0.0 | 0.0 | 1 | right (+0.48, +0.00) | left (-0.48, +0.00) | non-polar, either way works; moved -2.5 mm in x in r7d
C 23 | C152 5 | R0402 | Bot to m | 0 | 0.0 | 0.0 | 1 | right (+0.48, +0.00) | left (-0.48, +0.00) | non-polar, either way works; moved -2.5 mm in x in r7d
C 24 | C152 5 | R0402 | Bot to m | 0 | 0.0 | 0.0 | 1 | right (+0.48, +0.00) | left (-0.48, +0.00) | non-polar, either way works; moved 0.05 mm in r7c; moved -2.5 mm in x in r7d
C 25 | C152 5 | R0402 | Bot to m | 0 | 0.0 | 0.0 | 1 | right (+0.48, +0.00) | left (-0.48, +0.00) | non-polar, either way works; moved -2.5 mm in x in r7d
C 26 | C152 5 | R0402 | Bot to m | 0 | 0.0 | 0.0 | 1 | right (+0.48, +0.00) | left (-0.48, +0.00) | non-polar, either way works; moved -2.5 mm in x in r7d
C 27 | C152 5 | R0402 | Bot to m | 0 | 0.0 | 0.0 | 1 | right (+0.48, +0.00) | left (-0.48, +0.00) | non-polar, either way works; moved -2.5 mm in x in r7d

MF KVM v2 r7f · Gerber 5edbd116 · 第 3 / 8 頁

| | | | deg | | d | | view (mm) | view
C 29 | C152 5 | R0402 | Bot to m | 90 | 90. 0 | 0.0 | 1 | down (+0.00, +0.48) | down (-0.00, +0.48) | non-polar, either way works
C 3 | C152 5 | R0402 | Top | 90 | 90. 0 | 0.0 | 1 | down (+0.00, +0.48) | | non-polar, either way works
C 32 | C152 5 | R0402 | Bot to m | 0 | 0.0 | 0.0 | 1 | right (+0.48, +0.00) | left (-0.48, +0.00) | non-polar, either way works
C 33 | C152 5 | R0402 | Bot to m | 0 | 0.0 | 0.0 | 1 | right (+0.48, +0.00) | left (-0.48, +0.00) | non-polar, either way works
C 4 | C152 5 | R0402 | Top | 90 | 90. 0 | 0.0 | 1 | down (+0.00, +0.48) | | non-polar, either way works
C 40 | C197 02 | C0603 | Bot to m | 0 | 0.0 | 0.0 | 1 | right (+0.78, +0.00) | left (-0.78, +0.00) | non-polar, either way works
C 41 | C152 5 | R0402 | Bot to m | 0 | 0.0 | 0.0 | 1 | right (+0.48, +0.00) | left (-0.48, +0.00) | non-polar, either way works
C 5 | C529 23 | R0402 | Top | 90 | 90. 0 | 0.0 | 1 | down (+0.00, +0.48) | | non-polar, either way works
C 50 | C152 5 | R0402 | Top | 0 | 0.0 | 0.0 | 1 | left (-0.48, +0.00) | | non-polar, either way works
C 6 | C152 5 | R0402 | Top | 90 | 90. 0 | 0.0 | 1 | down (+0.00, +0.48) | | non-polar, either way works
C 60 | C457 83 | C0805 | Bot to m | 90 | 90. 0 | 0.0 | 1 | down (+0.00, +0.95) | down (-0.00, +0.95) | non-polar, either way works
C 61 | C457 83 | C0805 | Bot to m | 90 | 90. 0 | 0.0 | 1 | down (+0.00, +0.95) | down (-0.00, +0.95) | non-polar, either way works
C 62 | C457 83 | C0805 | Bot to m | 90 | 90. 0 | 0.0 | 1 | down (+0.00, +0.95) | down (-0.00, +0.95) | non-polar, either way works
C 63 | C155 5 | R0402 | Bot to m | 0 | 0.0 | 0.0 | 1 | right (+0.48, +0.00) | left (-0.48, +0.00) | non-polar, either way works
C 64 | C529 23 | R0402 | Bot to m | 90 | 90. 0 | 0.0 | 1 | down (+0.00, +0.48) | down (-0.00, +0.48) | non-polar, either way works
C 65 | C457 83 | C0805 | Top | 0 | 0.0 | 0.0 | 1 | left (-0.95, +0.00) | | non-polar, either way works
C 66 | C457 83 | C0805 | Top | 90 | 90. 0 | 0.0 | 1 | down (+0.00, +0.95) | | non-polar, either way works
C 67 | C457 83 | C0805 | Top | 90 | 90. 0 | 0.0 | 1 | down (+0.00, +0.95) | | non-polar, either way works
C 68 | C155 5 | R0402 | Top | 0 | 0.0 | 0.0 | 1 | left (-0.48, +0.00) | | non-polar, either way works

MF KVM v2 r7f · Gerber 5edbd116 · 第 4 / 8 頁

| | | | deg | | d | | view (mm) | view
C 70 | C385 032 | R0402 | Bot to m | 90 | 90. 0 | 0.0 | 1 | down (+0.00, +0.48) | down (-0.00, +0.48) | non-polar, either way works
C 71 | C152 5 | R0402 | Bot to m | 0 | 0.0 | 0.0 | 1 | right (+0.48, +0.00) | left (-0.48, +0.00) | non-polar, either way works
FB 2 | C984 85 | C0805 | Bot to m | 0 | 0.0 | 0.0 | 1 | right (+0.95, +0.00) | left (-0.95, +0.00) | non-polar, either way works
FB 3 | C858 40 | C0805 | Bot to m | 0 | 0.0 | 0.0 | 1 | right (+0.95, +0.00) | left (-0.95, +0.00) | non-polar, either way works
FB 4 | C984 85 | C0805 | Bot to m | 0 | 0.0 | 0.0 | 1 | right (+0.95, +0.00) | left (-0.95, +0.00) | non-polar, either way works
FB 5 | C858 40 | C0805 | Bot to m | 0 | 0.0 | 0.0 | 1 | right (+0.95, +0.00) | left (-0.95, +0.00) | non-polar, either way works
FB 6 | C193 30 | C0603 | Bot to m | 90 | 90. 0 | 0.0 | 1 | down (+0.00, +0.78) | down (-0.00, +0.78) | non-polar, either way works
L1 | C834 23 | IND4020 | Bot to m | 0 | 0.0 | 0.0 | 1 | right (+1.50, +0.00) | left (-1.50, +0.00) | non-polar, either way works
L2 | C834 23 | IND4020 | Top | 0 | 0.0 | 0.0 | 1 | left (-1.50, +0.00) | | non-polar, either way works
R1 | C259 05 | R0402 | Top | 0 | 0.0 | 0.0 | 1 | left (-0.48, +0.00) | | non-polar, either way works
R1 0 | C257 55 | R0402 | Top | 0 | 0.0 | 0.0 | 1 | left (-0.48, +0.00) | | non-polar, either way works
R1 1 | C257 44 | R0402 | Top | 90 | 90. 0 | 0.0 | 1 | down (+0.00, +0.48) | | non-polar, either way works
R1 2 | C257 44 | R0402 | Top | 90 | 90. 0 | 0.0 | 1 | down (+0.00, +0.48) | | non-polar, either way works
R1 3 | C257 44 | R0402 | Top | 90 | 90. 0 | 0.0 | 1 | down (+0.00, +0.48) | | non-polar, either way works
R2 | C259 05 | R0402 | Top | 0 | 0.0 | 0.0 | 1 | left (-0.48, +0.00) | | non-polar, either way works
R2 0 | C410 9 | R0402 | Bot to m | 0 | 0.0 | 0.0 | 1 | right (+0.48, +0.00) | left (-0.48, +0.00) | non-polar, either way works; moved -2.5 mm in x in r7d
R2 1 | C257 44 | R0402 | Bot to m | 90 | 90. 0 | 0.0 | 1 | down (+0.00, +0.48) | down (-0.00, +0.48) | non-polar, either way works
R2 2 | C258 79 | R0402 | Bot to m | 0 | 0.0 | 0.0 | 1 | right (+0.48, +0.00) | left (-0.48, +0.00) | non-polar, either way works

MF KVM v2 r7f · Gerber 5edbd116 · 第 5 / 8 頁

| | | | deg | | d | | view (mm) | view
R2 3 | C258 79 | R0402 | Bot to m | 0 | 0.0 | 0.0 | 1 | right (+0.48, +0.00) | left (-0.48, +0.00) | non-polar, either way works
R2 4 | C250 92 | R0402 | Bot to m | 0 | 0.0 | 0.0 | 1 | right (+0.48, +0.00) | left (-0.48, +0.00) | non-polar, either way works
R2 5 | C257 44 | R0402 | Bot to m | 0 | 0.0 | 0.0 | 1 | right (+0.48, +0.00) | left (-0.48, +0.00) | non-polar, either way works
R2 6 | C257 44 | R0402 | Bot to m | 0 | 0.0 | 0.0 | 1 | right (+0.48, +0.00) | left (-0.48, +0.00) | non-polar, either way works
R2 7 | C257 44 | R0402 | Bot to m | 0 | 0.0 | 0.0 | 1 | right (+0.48, +0.00) | left (-0.48, +0.00) | non-polar, either way works
R2 8 | C257 44 | R0402 | Bot to m | 0 | 0.0 | 0.0 | 1 | right (+0.48, +0.00) | left (-0.48, +0.00) | non-polar, either way works; moved 0.08 mm in r7c
R3 | C259 05 | R0402 | Top | 0 | 0.0 | 0.0 | 1 | left (-0.48, +0.00) | | non-polar, either way works
R3 0 | C117 02 | R0402 | Bot to m | 90 | 90. 0 | 0.0 | 1 | down (+0.00, +0.48) | down (-0.00, +0.48) | non-polar, either way works
R3 2 | C257 41 | R0402 | Bot to m | 90 | 90. 0 | 0.0 | 1 | down (+0.00, +0.48) | down (-0.00, +0.48) | non-polar, either way works
R4 | C259 05 | R0402 | Top | 0 | 0.0 | 0.0 | 1 | left (-0.48, +0.00) | | non-polar, either way works
R4 0 | C257 44 | R0402 | Bot to m | 0 | 0.0 | 0.0 | 1 | right (+0.48, +0.00) | left (-0.48, +0.00) | non-polar, either way works
R4 2 | C171 68 | R0402 | Bot to m | 0 | 0.0 | 0.0 | 1 | right (+0.48, +0.00) | left (-0.48, +0.00) | non-polar, either way works
R4 3 | C257 94 | R0402 | Bot to m | 0 | 0.0 | 0.0 | 1 | right (+0.48, +0.00) | left (-0.48, +0.00) | non-polar, either way works
R4 4 | C257 94 | R0402 | Bot to m | 0 | 0.0 | 0.0 | 1 | right (+0.48, +0.00) | left (-0.48, +0.00) | non-polar, either way works
R4 5 | C257 94 | R0402 | Bot to m | 0 | 0.0 | 0.0 | 1 | right (+0.48, +0.00) | left (-0.48, +0.00) | non-polar, either way works
R4 6 | C257 94 | R0402 | Bot to m | 0 | 0.0 | 0.0 | 1 | right (+0.48, +0.00) | left (-0.48, +0.00) | non-polar, either way works
R4 7 | C257 94 | R0402 | Bot to m | 0 | 0.0 | 0.0 | 1 | right (+0.48, +0.00) | left (-0.48, +0.00) | non-polar, either way works

MF KVM v2 r7f · Gerber 5edbd116 · 第 6 / 8 頁

| | | | deg | | d | | view (mm) | view
R5 0 | C257 55 | R0402 | Bot to m | 90 | 90. 0 | 0.0 | 1 | down (+0.00, +0.48) | down (-0.00, +0.48) | non-polar, either way works
R5 1 | C122 548 | R0402 | Bot to m | 90 | 90. 0 | 0.0 | 1 | down (+0.00, +0.48) | down (-0.00, +0.48) | non-polar, either way works
R5 2 | C251 17 | R0402 | Bot to m | 0 | 0.0 | 0.0 | 1 | right (+0.48, +0.00) | left (-0.48, +0.00) | non-polar, either way works
R5 3 | C251 17 | R0402 | Bot to m | 0 | 0.0 | 0.0 | 1 | right (+0.48, +0.00) | left (-0.48, +0.00) | non-polar, either way works
R5 4 | C250 99 | R0402 | Bot to m | 0 | 0.0 | 0.0 | 1 | right (+0.48, +0.00) | left (-0.48, +0.00) | non-polar, either way works
R5 5 | C257 44 | R0402 | Bot to m | 0 | 0.0 | 0.0 | 1 | right (+0.48, +0.00) | left (-0.48, +0.00) | non-polar, either way works
R6 0 | C260 83 | R0402 | Bot to m | 0 | 0.0 | 0.0 | 1 | right (+0.48, +0.00) | left (-0.48, +0.00) | non-polar, either way works
R6 1 | C728 559 | R0402 | Top | 0 | 0.0 | 0.0 | 1 | left (-0.48, +0.00) | | non-polar, either way works
R6 2 | C319 512 | R0402 | Top | 0 | 0.0 | 0.0 | 1 | left (-0.48, +0.00) | | non-polar, either way works
R6 3 | C728 559 | R0402 | Top | 0 | 0.0 | 0.0 | 1 | left (-0.48, +0.00) | | non-polar, either way works
R6 5 | C171 68 | R0402 | Bot to m | 90 | 90. 0 | 0.0 | 1 | down (+0.00, +0.48) | down (-0.00, +0.48) | non-polar, either way works
R6 6 | C250 76 | R0402 | Top | 0 | 0.0 | 0.0 | 1 | left (-0.48, +0.00) | | non-polar, either way works
R6 7 | C257 94 | R0402 | Top | 0 | 0.0 | 0.0 | 1 | left (-0.48, +0.00) | | non-polar, either way works
R6 8 | C247 444 | C0805 | Bot to m | 0 | 0.0 | 0.0 | 1 | right (+0.95, +0.00) | left (-0.95, +0.00) | non-polar, either way works; new in r7c
R7 1 | C257 41 | R0402 | Bot to m | 90 | 90. 0 | 0.0 | 1 | down (+0.00, +0.48) | down (-0.00, +0.48) | non-polar, either way works
R7 2 | C257 92 | R0402 | Bot to m | 90 | 90. 0 | 0.0 | 1 | down (+0.00, +0.48) | down (-0.00, +0.48) | non-polar, either way works
R7 3 | C117 02 | R0402 | Bot to m | 90 | 90. 0 | 0.0 | 1 | down (+0.00, +0.48) | down (-0.00, +0.48) | non-polar, either way works

MF KVM v2 r7f · Gerber 5edbd116 · 第 7 / 8 頁

| | | | deg | | d | | view (mm) | view
R7 4 | C250 92 | R0402 | Bot to m | 90 | 90. 0 | 0.0 | 1 | down (+0.00, +0.48) | down (-0.00, +0.48) | non-polar, either way works
R7 5 | C250 92 | R0402 | Bot to m | 90 | 90. 0 | 0.0 | 1 | down (+0.00, +0.48) | down (-0.00, +0.48) | non-polar, either way works
R7 6 | C250 92 | R0402 | Bot to m | 0 | 0.0 | 0.0 | 1 | right (+0.48, +0.00) | left (-0.48, +0.00) | non-polar, either way works
R7 7 | C250 92 | R0402 | Bot to m | 0 | 0.0 | 0.0 | 1 | right (+0.48, +0.00) | left (-0.48, +0.00) | non-polar, either way works
R7 8 | C250 92 | R0402 | Bot to m | 0 | 0.0 | 0.0 | 1 | right (+0.48, +0.00) | left (-0.48, +0.00) | non-polar, either way works
R7 9 | C250 92 | R0402 | Top | 270 | 270 .0 | 0.0 | 1 | up (+0.00, -0.48) | | non-polar, either way works
R8 0 | C320 843 | R0201 | Top | 270 | 270 .0 | 0.0 | 1 | up (+0.00, -0.27) | | non-polar, either way works
R8 1 | C320 843 | R0201 | Top | 270 | 270 .0 | 0.0 | 1 | up (+0.00, -0.27) | | non-polar, either way works
R9 | C257 41 | R0402 | Top | 0 | 0.0 | 0.0 | 1 | left (-0.48, +0.00) | | non-polar, either way works

MF KVM v2 r7f · Gerber 5edbd116 · 第 8 / 8 頁
