ooropuloo/MFKVM/off-the-shelf/fab_atx_b/hole_report.txt

0 under limit; VIA outer min 0.3015 (limit 0.2), VIA inner min none near (limit 0.2), NPTH outer min none near (limit 0.2), NPTH inner min none near (limit 0.2), PTH outer min 0.4444 (limit 0.28), PTH inner min none near (limit 0.3); holes {'VIA': 12, 'PTH': 5, 'NPTH': 0} on 2 copper layers
limits: JLCPCB capabilities page, 2026-11-06. Same-net copper on plated holes is exempt, NPTH has no exemption.
same-net objects exempted, by hole type and object: {('PTH', 'ComponentPad'): 10, ('PTH', 'Conductor'): 6, ('VIA', 'Conductor'): 36, ('VIA', 'SMDPad'): 6, ('VIA', 'ViaPad'): 24}
zone regions whose parsed area was checked against the outline: 0
PTH holes, closest other-net copper within 0.45 mm of the hole edge: 5 objects (0 under the 0.35 JLC recommends)
  0.4444 limit 0.28 H1.1 [3V3] L1 to track(4.18,8.52) [ATX_RST]
  0.4444 limit 0.28 H2.1 [GND] L2 to track(4.18,8.52) [ATX_RST]
  0.4444 limit 0.28 H3.1 [ATX_PWR] L2 to track(4.18,8.52) [ATX_RST]
  0.4479 limit 0.28 H1.1 [3V3] L1 to track(4.18,6.49) [ATX_RST]
  0.4492 limit 0.28 H1.1 [3V3] L1 to track(4.50,6.16) [ATX_RST]
NPTH hole wall to any copper, reported margin above the 0.2 limit. 0 holes:
  no copper within 0.45 mm
under limit: 0
RESULT PASS
