ooropuloo/MFKVM/off-the-shelf/fab_atx_b/mask_report.txt

mask bridge minimum None mm, 0 under 0.1, 0 under 0.13 (black/white only); opening to other-net conductor minimum 0.1517 mm, 0 under 0.09; 0 openings merged across nets; openings {'F': {'openings': 33, 'copper': 108, 'not_on_a_pad': 0}, 'B': {'openings': 5, 'copper': 43, 'not_on_a_pad': 0}}
bridges under 0.10: 0
bridges 0.10 to 0.13: 0
openings merged across nets: 0
opening to conductor under 0.09: 0
RESULT PASS
