ooropuloo/MFKVM/lay-board/courtyard_review/img/extra_A_U10_U11.png

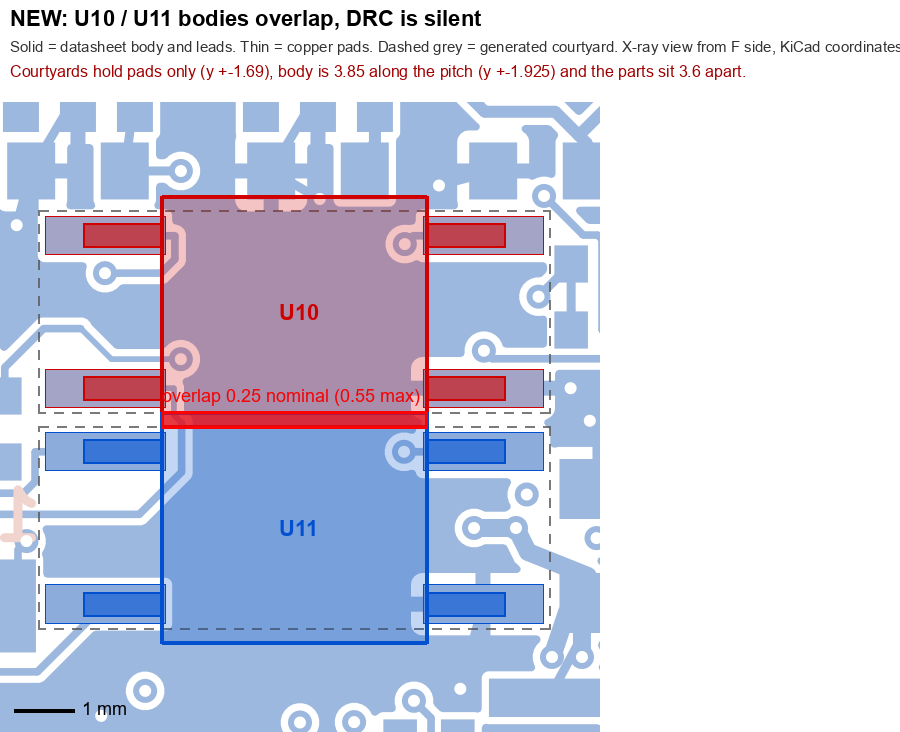
lay-board/courtyard_review/img/extra_A_U10_U11.png
