ooropuloo/MFKVM/lay-board/courtyard_review/img/extra_B_U12_L1.png

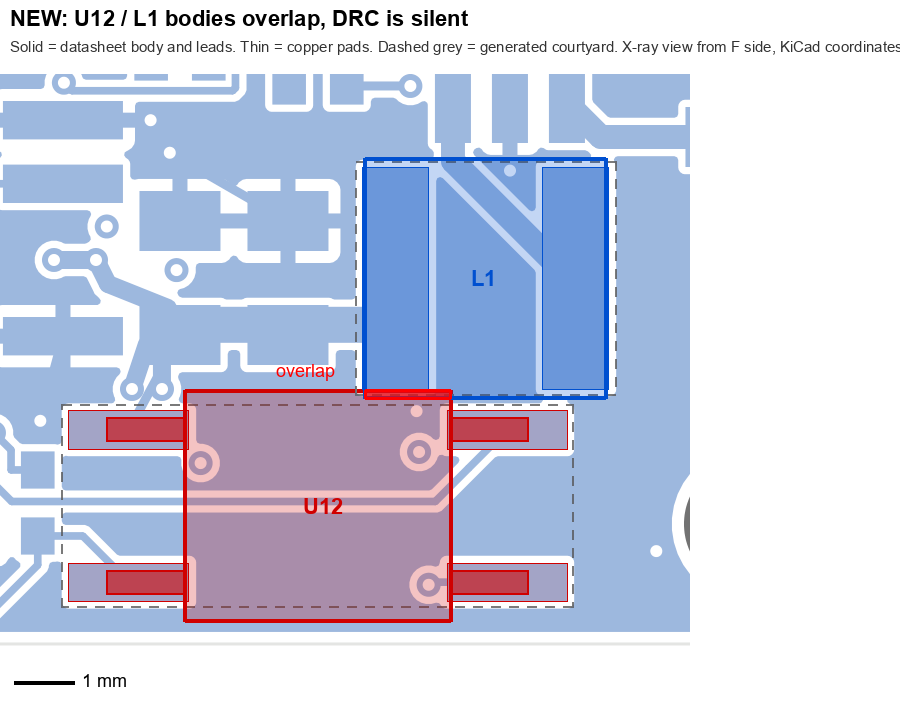
lay-board/courtyard_review/img/extra_B_U12_L1.png
