ooropuloo/MFKVM/lay-board/courtyard_review/img/extra_C_U4_Q1.png

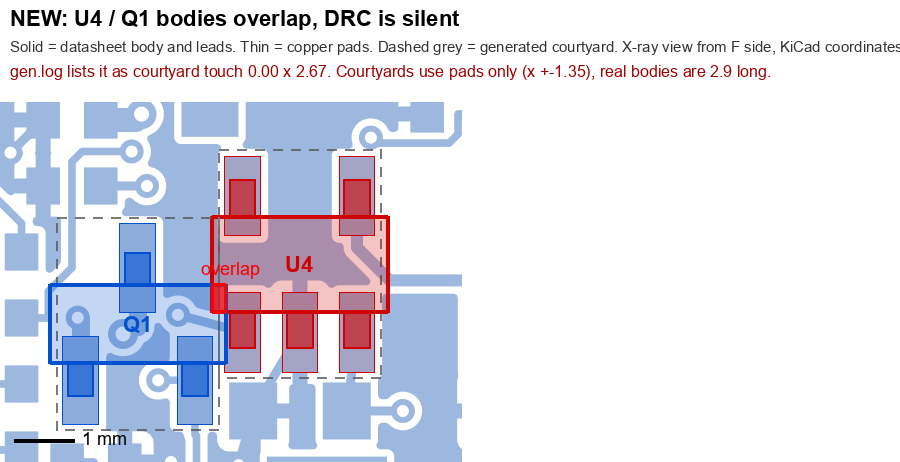
lay-board/courtyard_review/img/extra_C_U4_Q1.png
