ooropuloo/MFKVM/lay-board/courtyard_review/img/extra_D_C11_U10.png

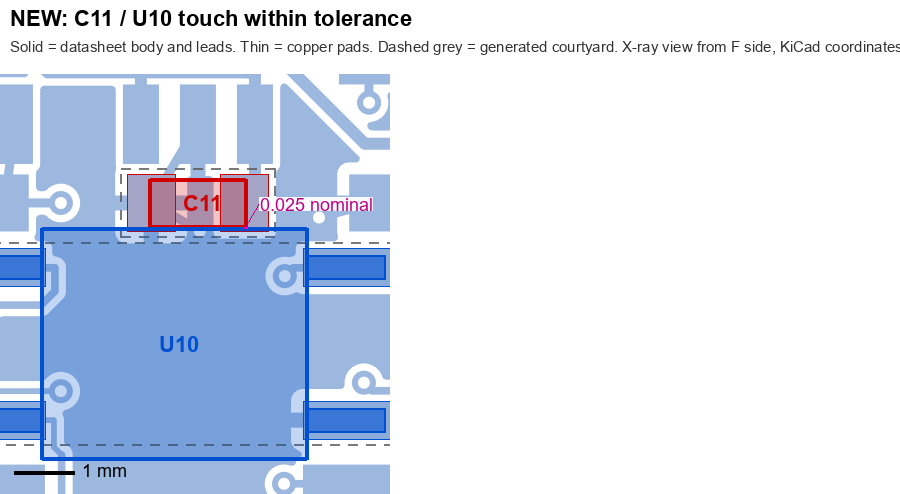
lay-board/courtyard_review/img/extra_D_C11_U10.png
