ooropuloo/MFKVM/lay-board/courtyard_review/img/overview_J4_opto_area.png

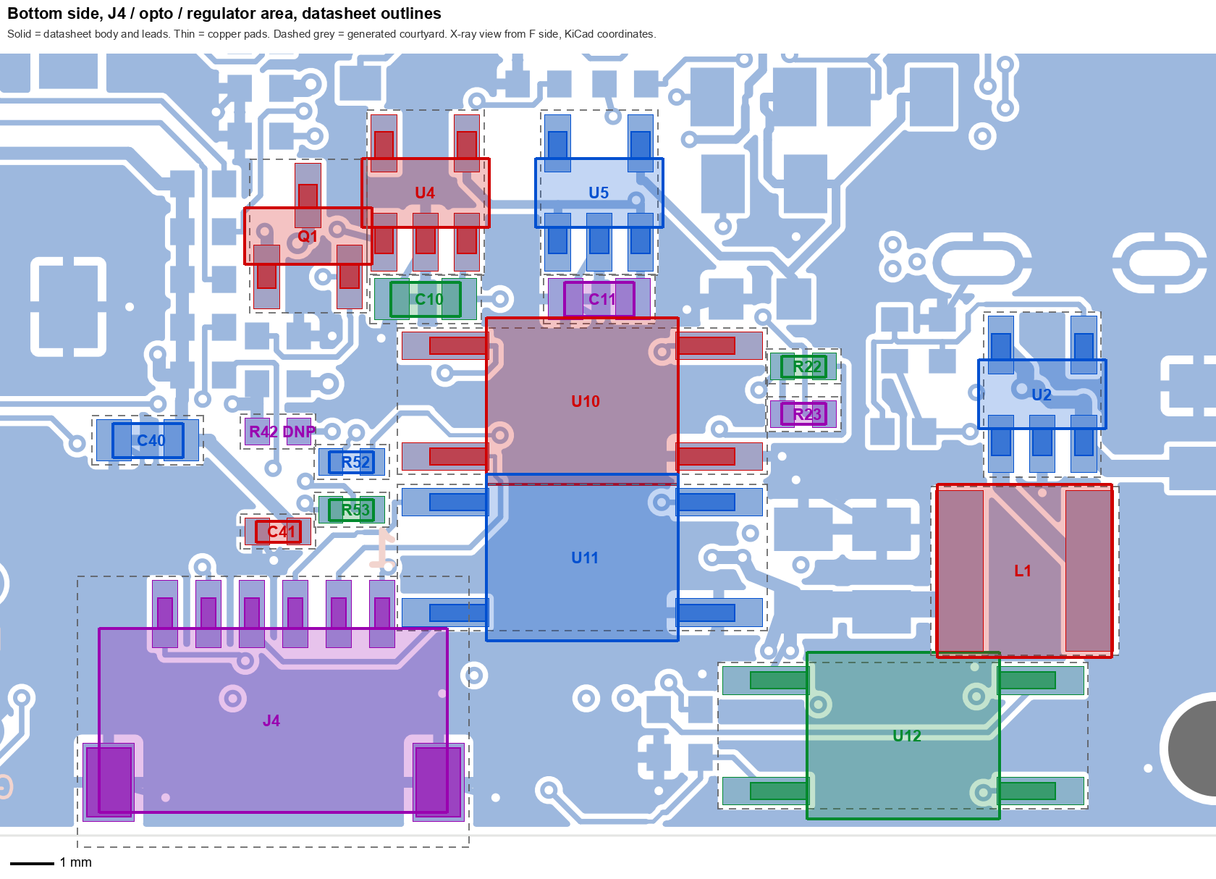
lay-board/courtyard_review/img/overview_J4_opto_area.png
