ooropuloo/MFKVM/lay-board/courtyard_review/img/pair_01_U11_J4.png

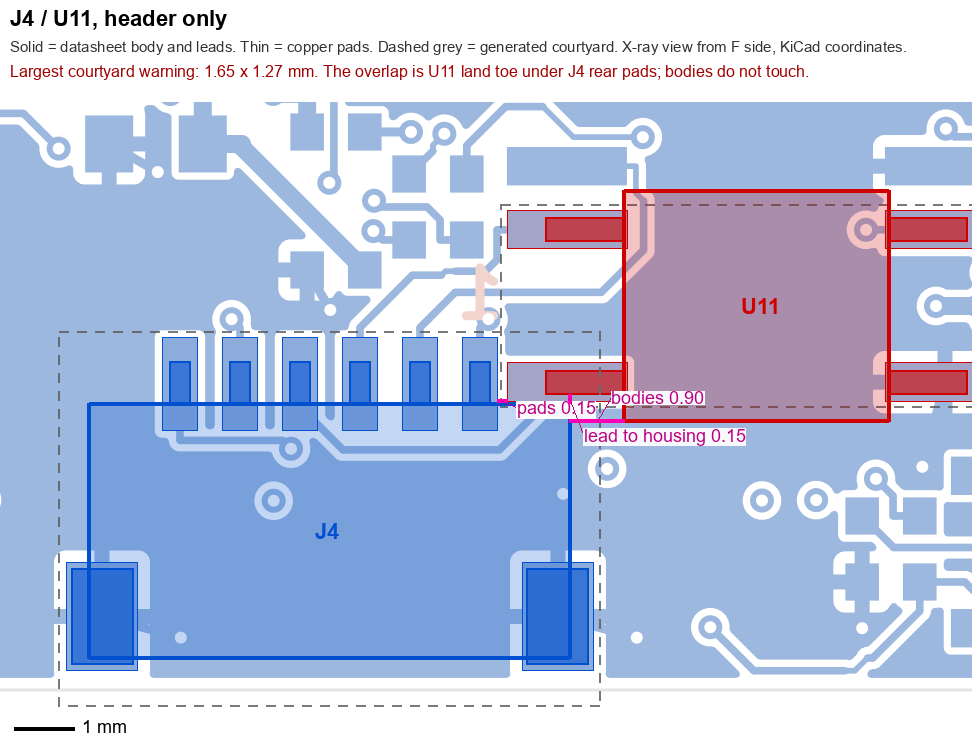
lay-board/courtyard_review/img/pair_01_U11_J4.png
