ooropuloo/MFKVM/lay-board/courtyard_review/img/pair_01b_J4_plug.png

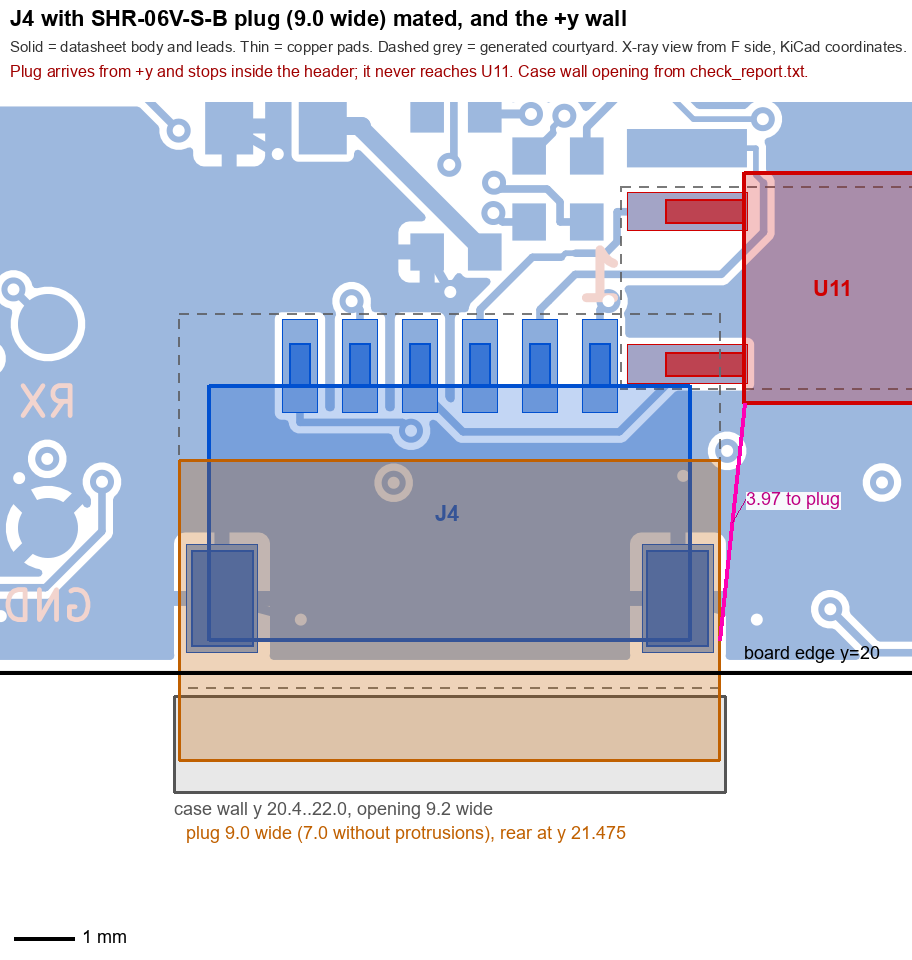
lay-board/courtyard_review/img/pair_01b_J4_plug.png
