ooropuloo/MFKVM/lay-board/courtyard_review/img/pair_02_C11_U5.png

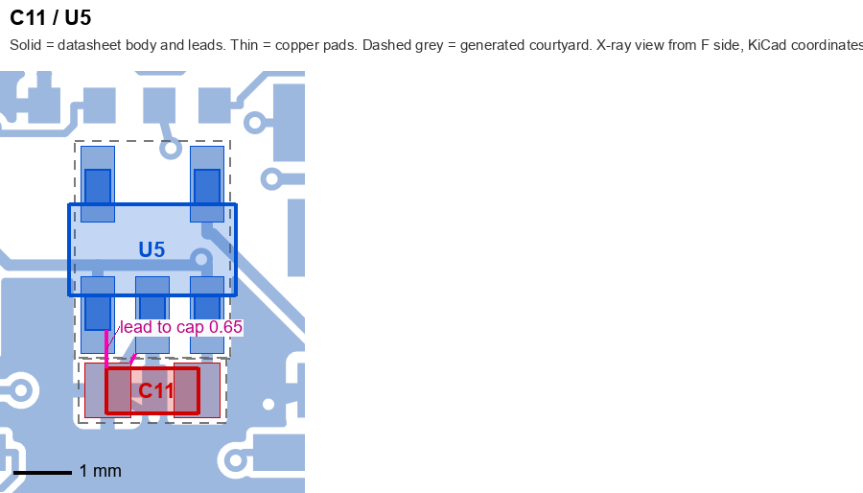
lay-board/courtyard_review/img/pair_02_C11_U5.png
