ooropuloo/MFKVM/lay-board/courtyard_review/img/pair_03_C19_Y1.png

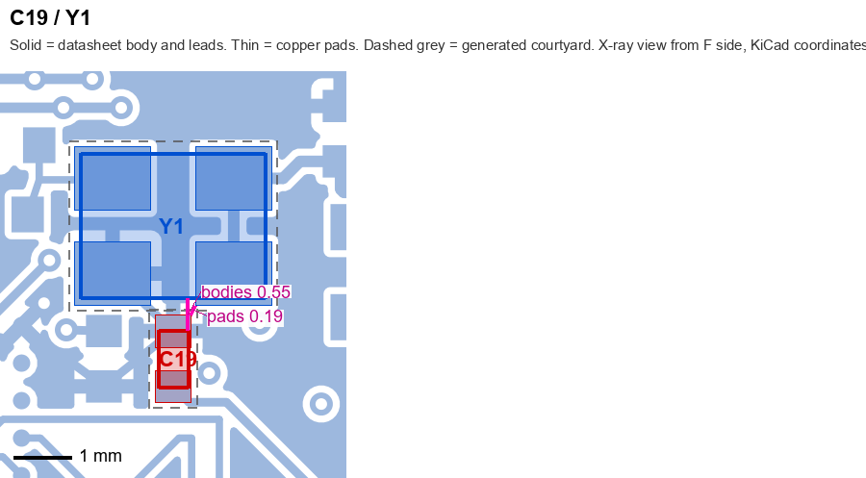
lay-board/courtyard_review/img/pair_03_C19_Y1.png
