ooropuloo/MFKVM/lay-board/courtyard_review/img/pair_04_C40_J7.png

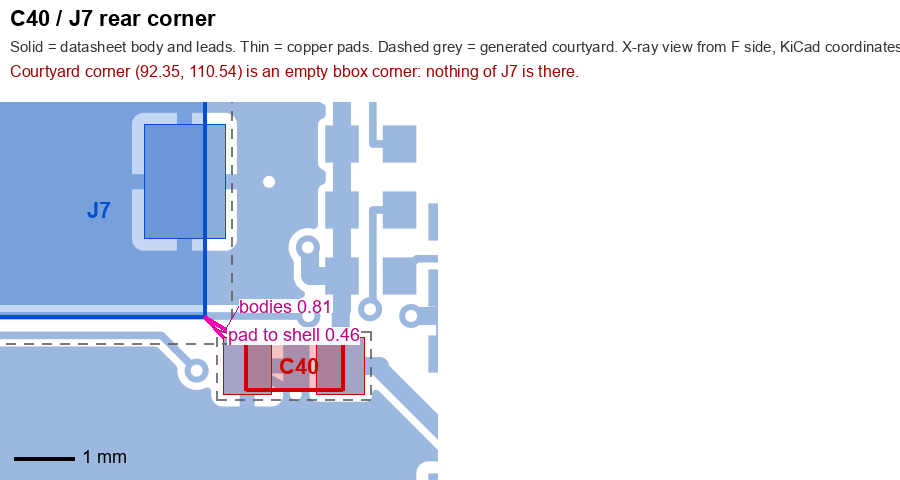
lay-board/courtyard_review/img/pair_04_C40_J7.png
