ooropuloo/MFKVM/lay-board/courtyard_review/img/pair_04b_J7_card.png

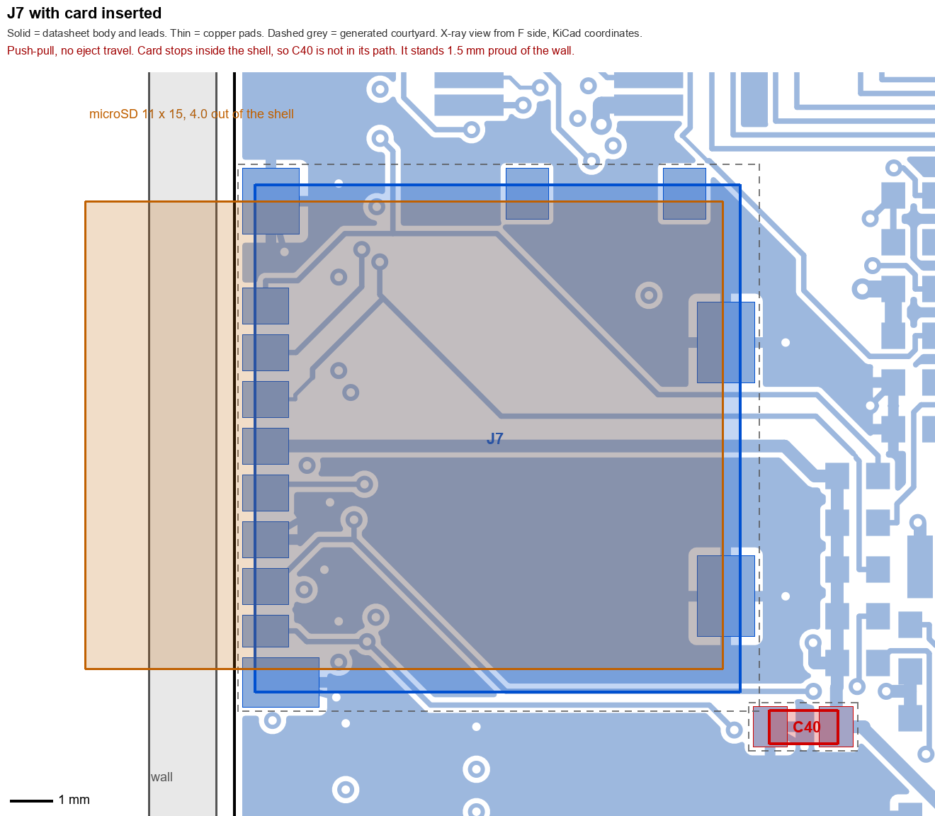
lay-board/courtyard_review/img/pair_04b_J7_card.png
