ooropuloo/MFKVM/lay-board/courtyard_review/img/pair_05_R52_R42.png

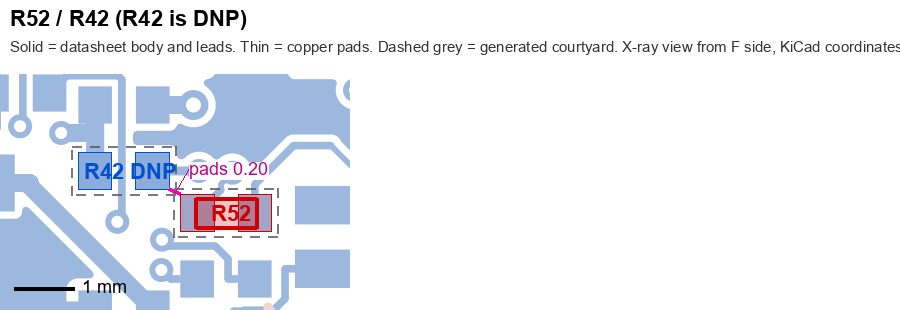
lay-board/courtyard_review/img/pair_05_R52_R42.png
