ooropuloo/MFKVM/lay-board/courtyard_review/img/pair_06_R53_C41.png

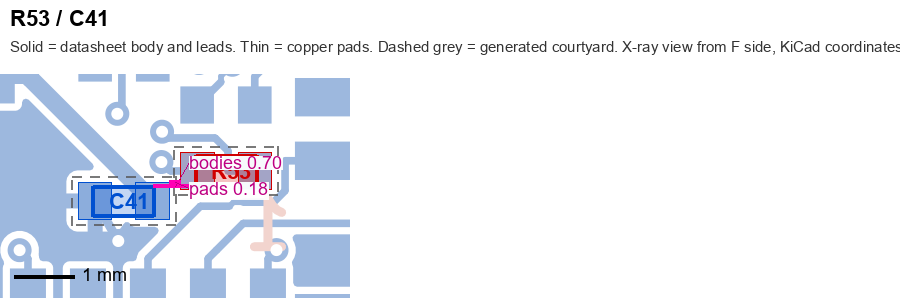
lay-board/courtyard_review/img/pair_06_R53_C41.png
