ooropuloo/MFKVM/lay-board/courtyard_review/img/pair_08_U10_R22.png

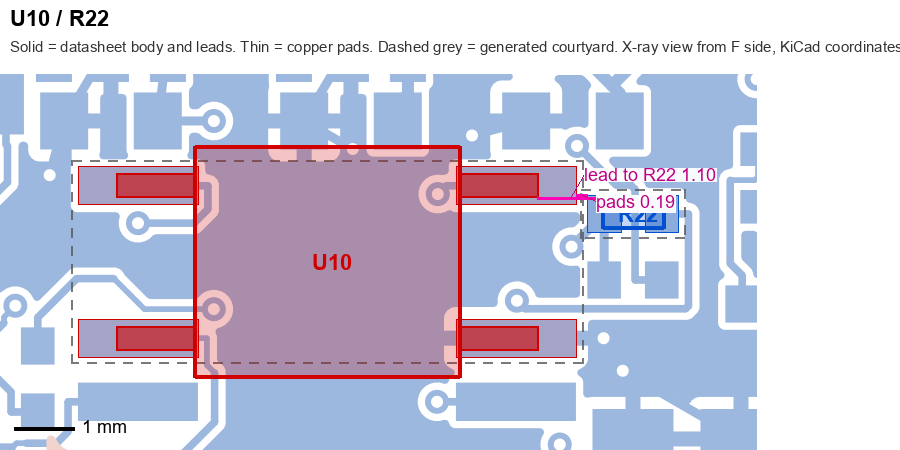
lay-board/courtyard_review/img/pair_08_U10_R22.png
