ooropuloo/MFKVM/lay-board/courtyard_review/img/pair_10_U4_C10.png

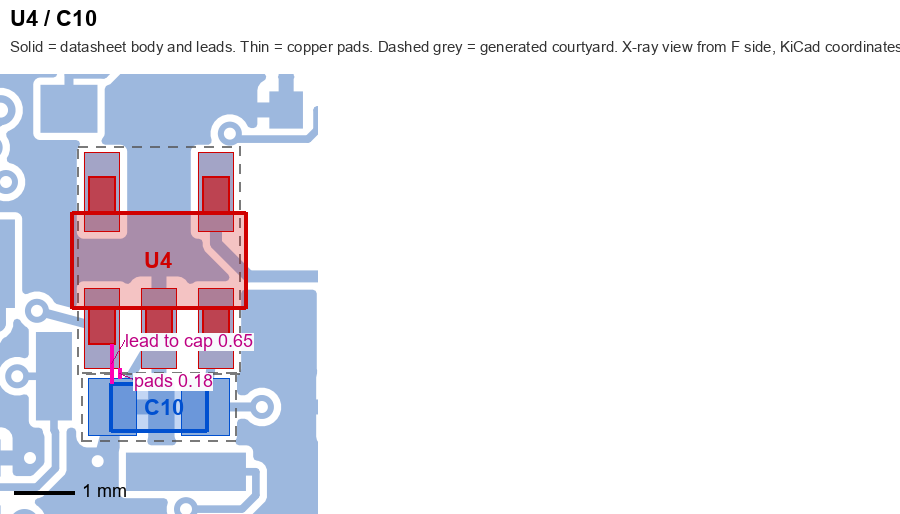
lay-board/courtyard_review/img/pair_10_U4_C10.png
