ooropuloo/MFKVM/lay-board/fab_r5/opto_pin1_check.png

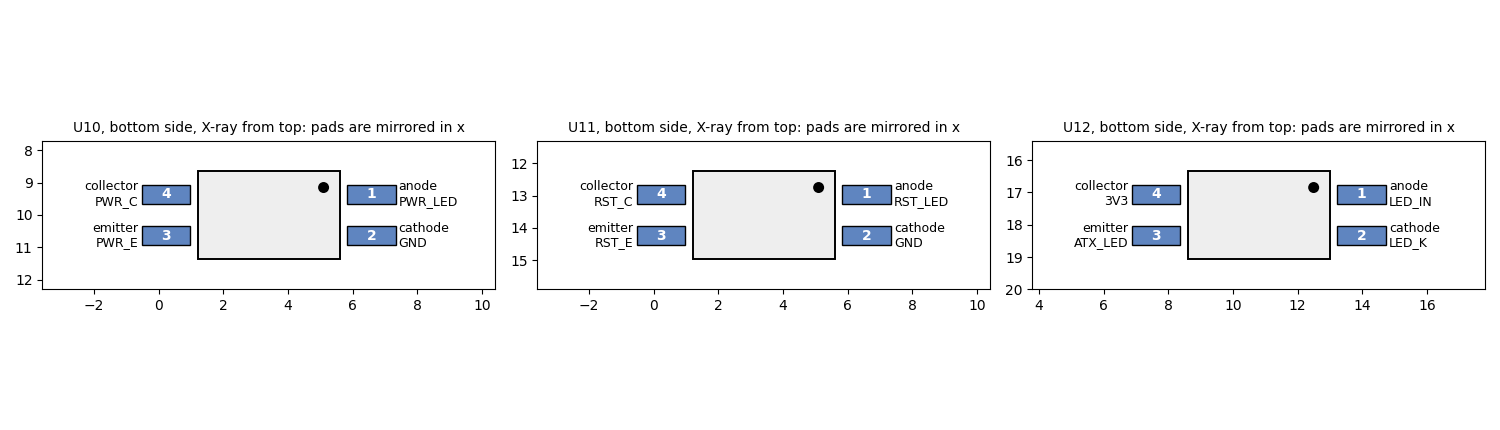
lay-board/fab_r5/opto_pin1_check.png
