ooropuloo/MFKVM/lay-board/fab_r5/r4_opto_area.png

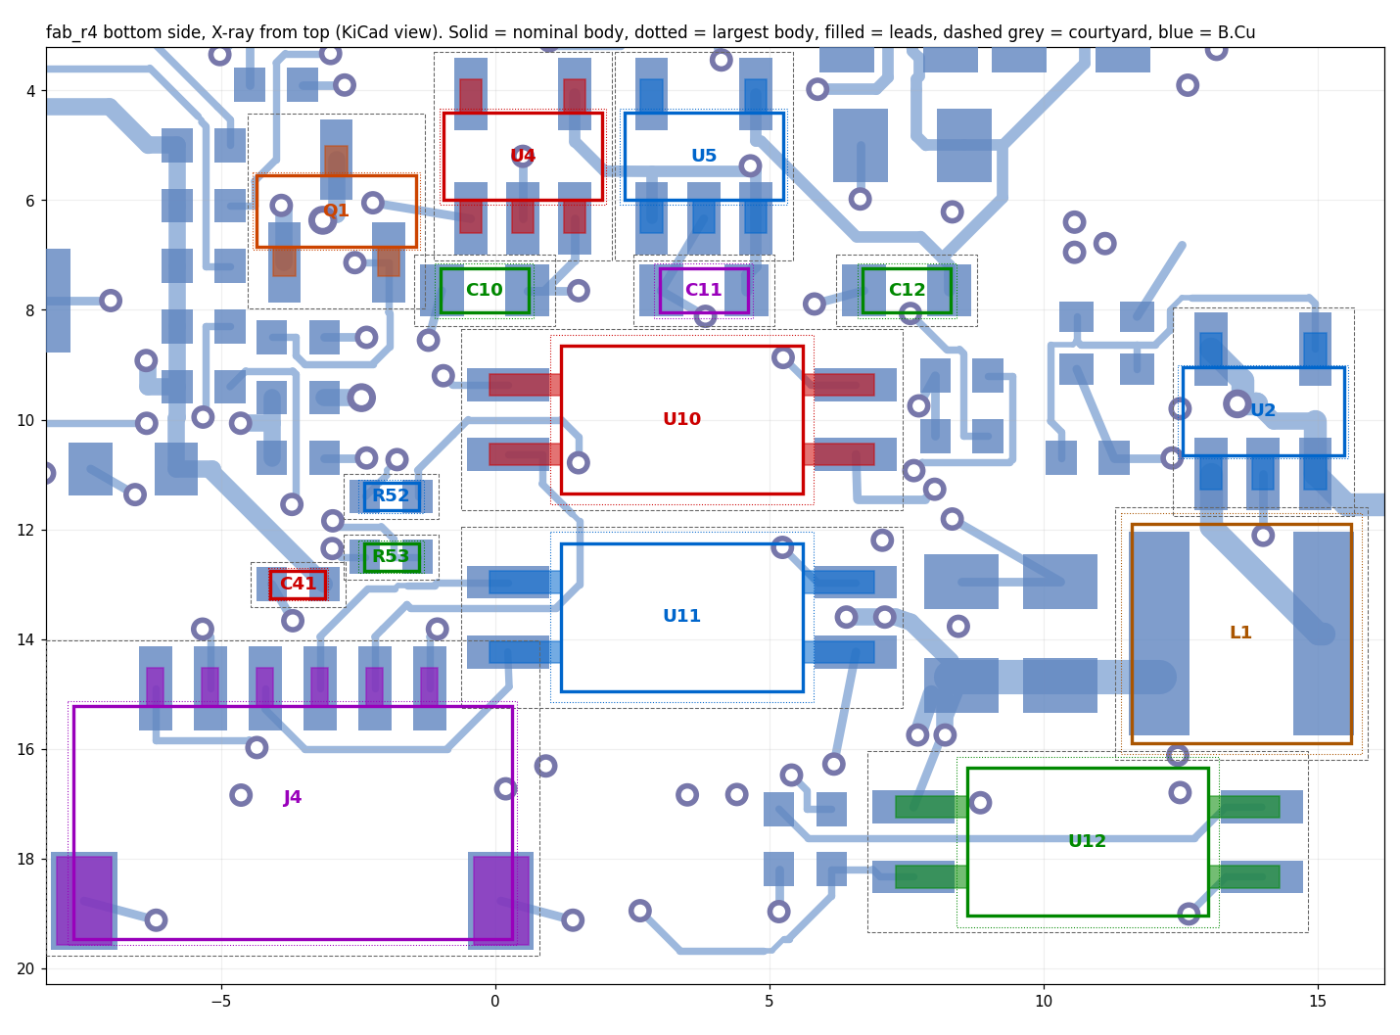
lay-board/fab_r5/r4_opto_area.png
