ooropuloo/MFKVM/lay-board/r7f/fab_r7f/board_bottom.png

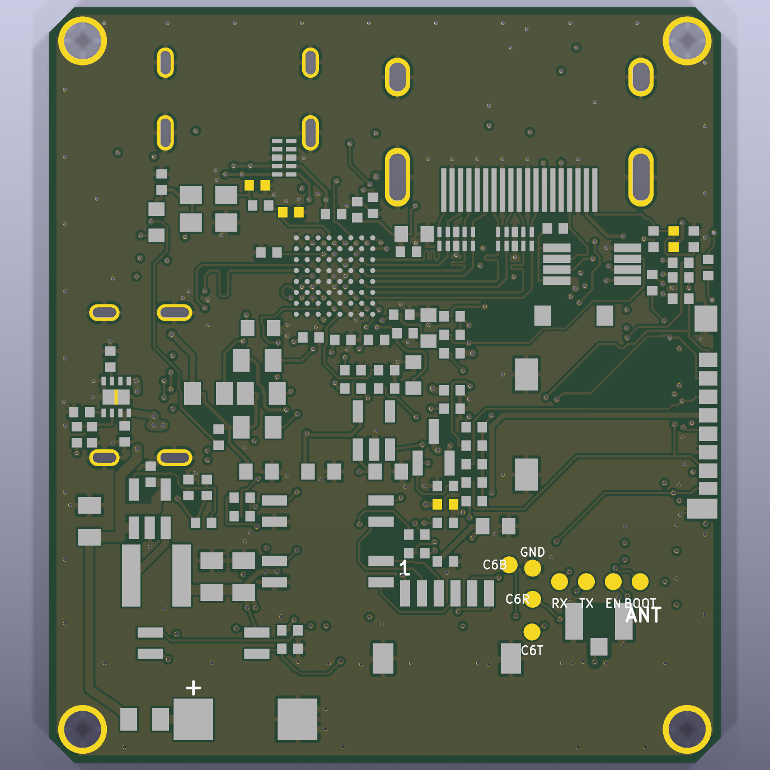
lay-board/r7f/fab_r7f/board_bottom.png
