ooropuloo/MFKVM/lay-board/r7f/fab_r7f/board_top.png

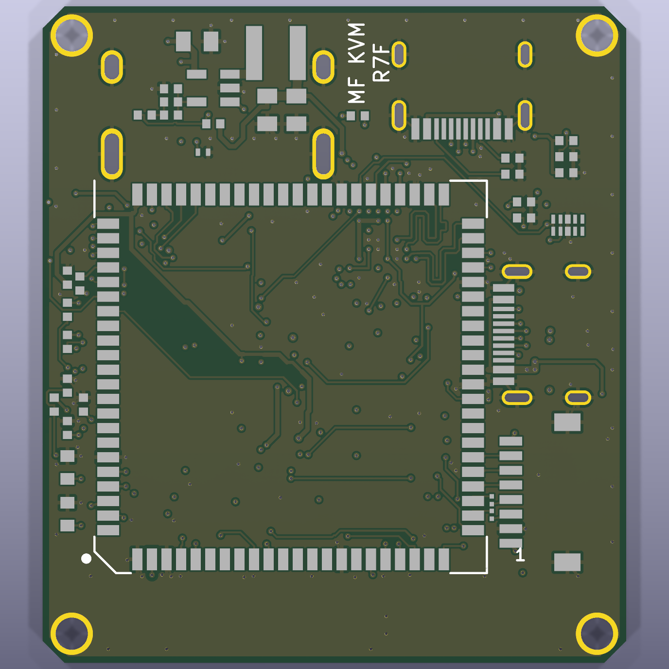
lay-board/r7f/fab_r7f/board_top.png
