ooropuloo/MFKVM/off-the-shelf/case/handedness/page_top.png

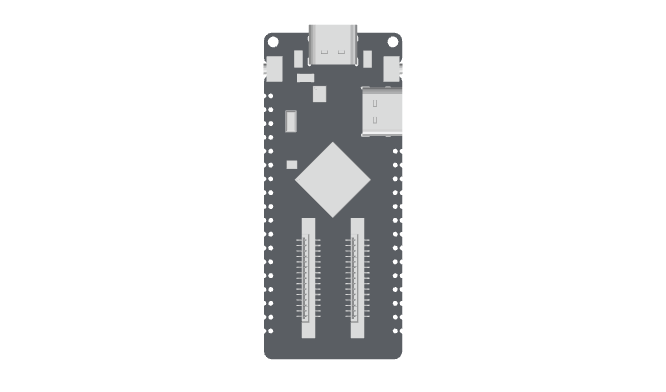
off-the-shelf/case/handedness/page_top.png
