ooropuloo/MFKVM/off-the-shelf/firmware/render/contact_sheet.png

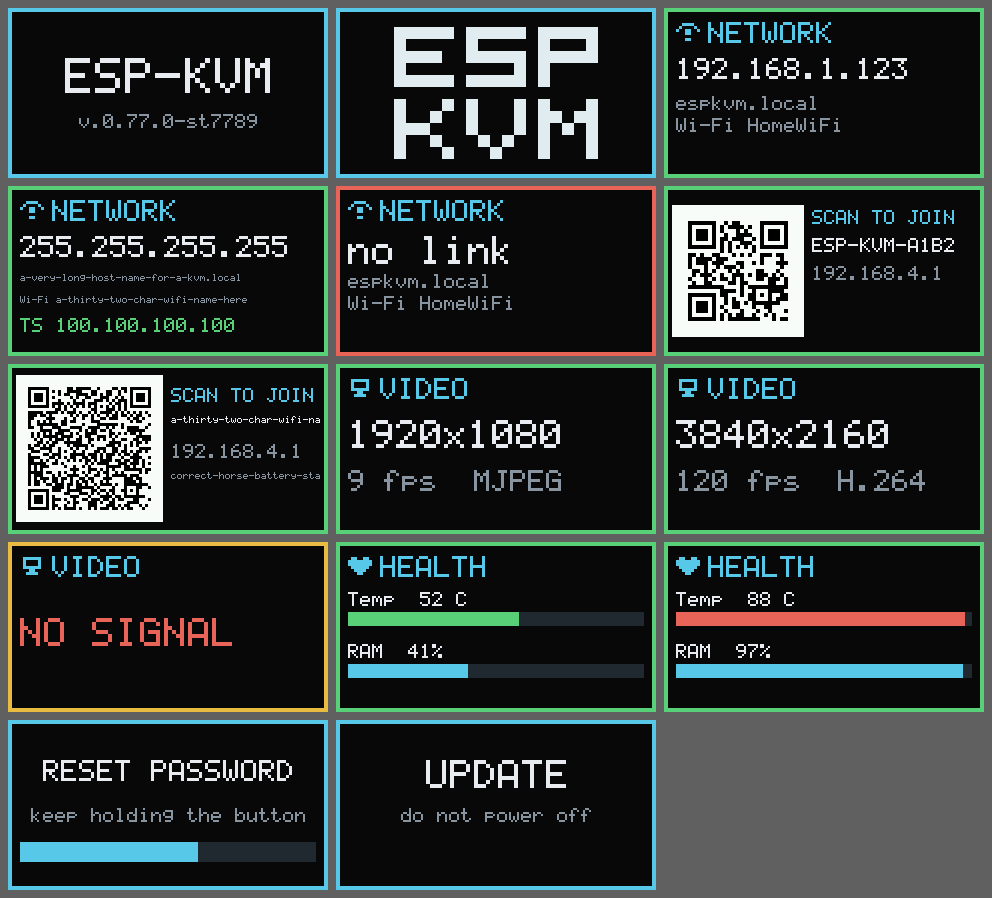
off-the-shelf/firmware/render/contact_sheet.png
