ooropuloo/MFKVM/lay-board/parts_img/SOURCES.md

# 料件圖來源（2026-11-06 取得）

全部是自繪示意或由本 repo 的檔案算繪；廠商照片不放進 repo，只留商品頁連結。由 `off-the-shelf/parts_img/make_parts_img.py` 產生。

| 檔案（src/） | 類型 | 來源 |
|---|---|---|
| p4.svg | 自繪示意 | 實物照片見經銷商商品頁：https://openelab.io/products/waveshare-esp32-p4-module-core-board-wifi-bluetooth |
| ant.svg | 自繪示意 | 通用料，沒有指定產品 |
| lcd128.svg | 自繪示意 | 實物照片見經銷商商品頁：https://pishop.ca/product/240x240-general-1-28inch-round-lcd-display-module-65k-rgb |
| jst8.svg | 自繪示意 | DigiKey 回 403、Future Electronics 連線被重設，改畫示意 |
| jst6.svg | 自繪示意 | DigiKey 回 403、Future Electronics 連線被重設，改畫示意 |
| m2.svg | 自繪示意 | 通用料；長度和直徑依規格等比例，頭型是示意 |
| power3.svg | 自繪示意 | 通用料，沒有指定產品 |
| tray.png | 自行渲染 | lay-board/case/stl/mf_kvm_tray.stl，等角視角，由實際網格算出 |
| lid.png | 自行渲染 | lay-board/case/stl/mf_kvm_lid.stl，等角視角，由實際網格算出 |
| main.png | 自行渲染 | lay-board/fab_r5/board_top.png，裁到板子範圍 |
