ooropuloo/MFKVM/off-the-shelf/parts_img/SOURCES.md

# 料件圖來源（2026-11-06 取得）

全部是自繪示意或由本 repo 的檔案算繪；廠商照片不放進 repo，只留商品頁連結。由 `off-the-shelf/parts_img/make_parts_img.py` 產生。

| 檔案（src/） | 類型 | 來源 |
|---|---|---|
| fb.svg | 自繪示意 | 實物照片見原廠商品頁：https://www.dfrobot.com/product-2915.html |
| c790.svg | 自繪示意 | 實物照片見原廠商品頁：https://geekworm.com/products/c790 |
| ffc_opp.svg | 自繪示意 | DigiKey、Würth、RS 都回 403，改畫示意。接點面依 DigiKey 列表「Top on One Side, Bottom on Other」 |
| ffc_same.svg | 自繪示意 | DigiKey、Würth、RS 都回 403，改畫示意。接點面依 DigiKey 列表「Top on Both Sides」 |
| power.svg | 自繪示意 | 通用料，沒有指定產品 |
| usb_a.svg | 自繪示意 | 腳位：accesscomms.com.au/usb-pinouts-wiring（看接點時 plug 由左到右 1-2-3-4）與 KiCad USB_A_PCB_traces_small 足印，兩者一致 |
| lcd19.svg | 自繪示意 | 實物照片見經銷商商品頁：https://www.pishop.us/product/1-9inch-lcd-display-module-170-320-resolution-spi-interface-ips-262k-colors/ |
| wire.svg | 自繪示意 | 通用料，沒有指定產品 |
| jst6.svg | 自繪示意 | DigiKey 回 403、Future Electronics 連線被重設，改畫示意 |
| screws.svg | 自繪示意 | 通用料；長度和直徑依表內規格等比例，頭型是示意 |
| tray.png | 自行渲染 | off-the-shelf/case/stl/mf_kvm_tray.stl，等角視角，由實際網格算出 |
| lid.png | 自行渲染 | off-the-shelf/case/stl/mf_kvm_lid.stl，等角視角，由實際網格算出 |
| bridge.png | 自行渲染 | off-the-shelf/case/stl/mf_kvm_bridge.stl，等角視角，由實際網格算出 |
| former.png | 自行渲染 | off-the-shelf/case/stl/mf_kvm_former.stl，等角視角，由實際網格算出 |
| atx_shim.png | 自行渲染 | off-the-shelf/case/stl/mf_kvm_atx_shim.stl，等角視角，由實際網格算出 |
| atx.png | 自行渲染 | off-the-shelf/fab_atx_b/board_top.png，裁到板子範圍 |
