ooropuloo/MFKVM/lay-board/r7f/fab_r7f/BOM_JLC.csv

Comment | Designator | Footprint | LCSC Part #
1k 0402 | R30,R73 | R0402 | C11702
33.2k 0402 | R51 | R0402 | C122548
TPD4E05U06DQAR USB ESD | U3 | USON-10 | C138714
TPD4E05U06DQAR USB2 ESD | U14 | USON-10 | C138714
TPD4E05U06DQAR TMDS ESD | U8,U9 | USON-10 | C138714
AO3401A | Q1 | SOT-23 | C15127
100nF 0402 | C21,C22,C23,C24,C25,C26,C27,C29,C3,C32,C33,C4,C41,C50,C6,C71 | R0402 | C1525
470pF 0402 | C13,C15,C17,C19 | R0402 | C1537
22pF 0402 | C63,C68 | R0402 | C1555
SM06B-SRSS-TB ATX | J4 | JST_SM06B | C160405
SM08B-SRSS-TB round LCD | J6 | JST_SM08B | C160407
0R 0402 | R42,R65 | R0402 | C17168
600R@100MHz | FB6 | C0603 | C19330
4.7uF 0603 | C14,C16,C18,C20 | C0603 | C19666
10uF 0603 | C1,C10,C11,C12,C2,C40 | C0603 | C19702
TCA9517ADGKR DDC level shift | U6 | MSOP-8 | C201698
TPS259531DSGR eFuse 5.7V clamp | U16 | WSON-8_2x2_EP | C2155674
0.15 0805 | R68 | C0805 | C247444
100 0402 | R66 | R0402 | C25076
22 0402 | R24,R74,R75,R76,R77,R78,R79 | R0402 | C25092
270 0402 | R54 | R0402 | C25099
470 0402 | R52,R53 | R0402 | C25117
100k 0402 | R32,R71,R9 | R0402 | C25741
10k 0402 | R11,R12,R13,R21,R25,R26,R27,R28,R40,R55 | R0402 | C25744
150k 0402 | R10,R50 | R0402 | C25755
47k 0402 | R72 | R0402 | C25792
51k 0402 | R43,R44,R45,R46,R47,R67 | R0402 | C25794
2.2k 0402 | R22,R23 | R0402 | C25879
5.1k 0402 | R1,R2,R3,R4 | R0402 | C25905
1M 0402 | R60 | R0402 | C26083
TC358743XBG(EL,NOK | U7 | BGA-64_6x6 | C3008606
560 0.1% 0402 | R62 | R0402 | C319512
33 0201 | R80,R81 | R0201 | C320843
POSCAP 10TPE330M 330uF 10V polymer | C69 | CP_7343 | C347552
2.2uF 0402 | C70 | R0402 | C385032
2k 0402 | R20 | R0402 | C4109
USB-C to host | J3 | USB-C_HX_16P | C41427493
USB-C 5V, flash and console | J5 | USB-C_HX_16P | C41427493
22uF 0805 | C60,C61,C62,C65,C66,C67 | C0805 | C45783
TPD1E10B06DPYR CEC ESD | D1 | X1SON-2_0.6x1 | C48260
1uF 0402 | C5,C64 | R0402 | C52923
Molex 104031-0811 microSD | J7 | microSD_Molex_104031-0811 | C585350
HDMI-001S | J2 | HDMI-001S | C720616
OT322527MJBA4SL 27MHz | Y1 | OSC3225 | C725995
33k 0.1% 0402 | R61,R63 | R0402 | C728559
SY8089AAAC 3.3V 2A | U2 | SOT-23-5 | C78988
SY8089AAAC 1.2V buck | U15 | SOT-23-5 | C78988
SWPA4020S2R2MT 2.2uH | L1,L2 | IND4020 | C83423
220R@100MHz 2A BLM21PG221SN1D | FB3,FB5 | C0805 | C85840
TLV73325PDBVR 2.5V | U4 | SOT-23-5 | C882825
U.FL-R-SMT-1(10) antenna | J8 | U.FL-R-SMT-1 | C88373
EL3H7(C)(TA)-G | U10,U11,U12 | SSOP-4_1.27 | C92243
1k@100MHz 500mA | FB2,FB4 | C0805 | C98485
