ooropuloo/MFKVM/lay-board/parts_img/src/lid.png

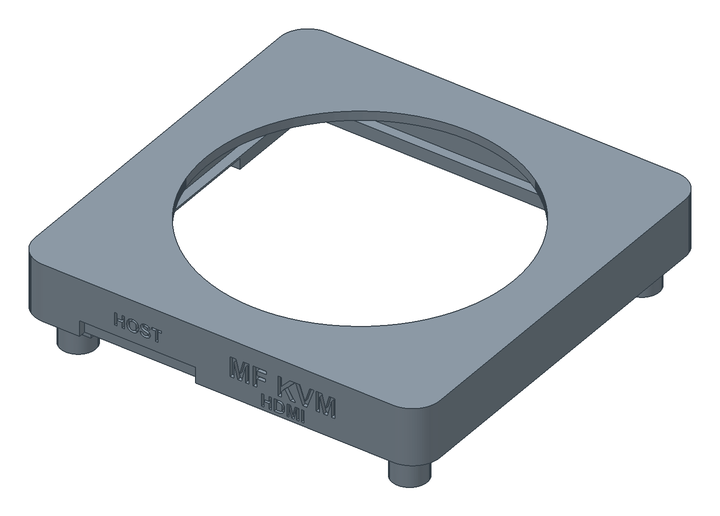
lay-board/parts_img/src/lid.png
