ooropuloo/MFKVM/lay-board/parts_img/src/main.png

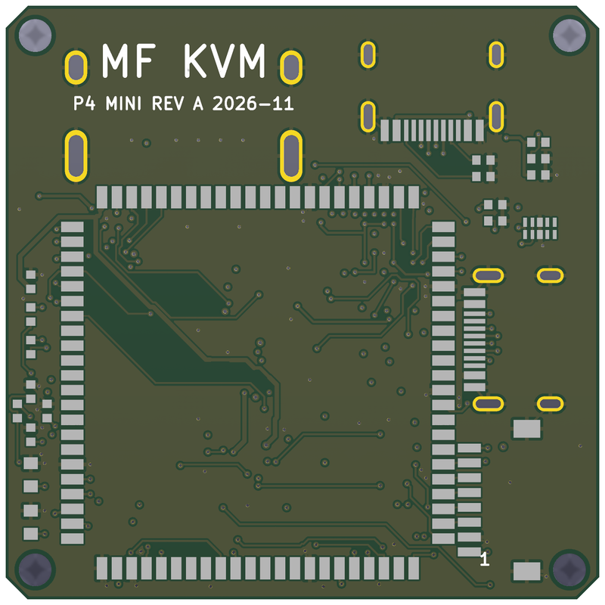
lay-board/parts_img/src/main.png
