ooropuloo/MFKVM/lay-board/parts_img/src/tray.png

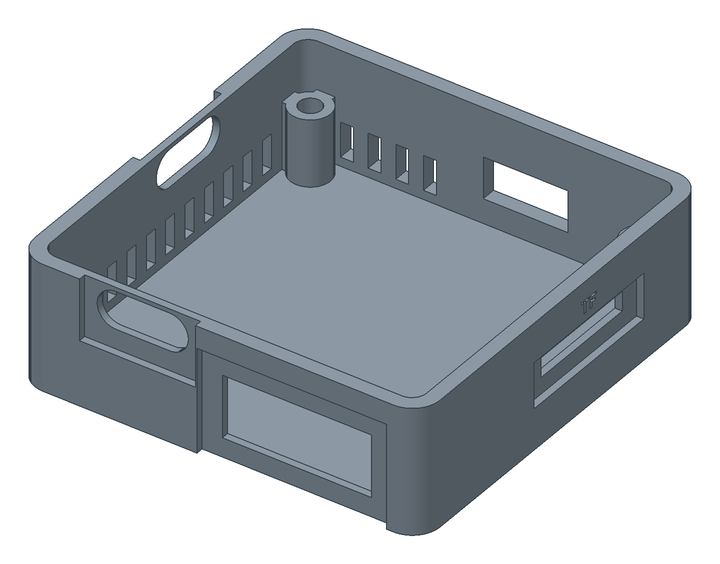
lay-board/parts_img/src/tray.png
