ooropuloo/MFKVM/off-the-shelf/parts_img/src/atx.png

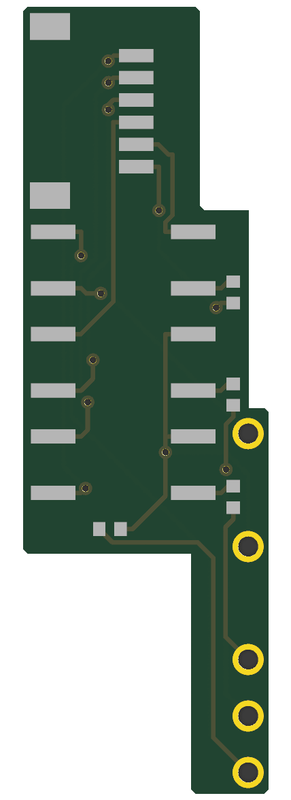
off-the-shelf/parts_img/src/atx.png
