ooropuloo/MFKVM/off-the-shelf/parts_img/src/atx_shim.png

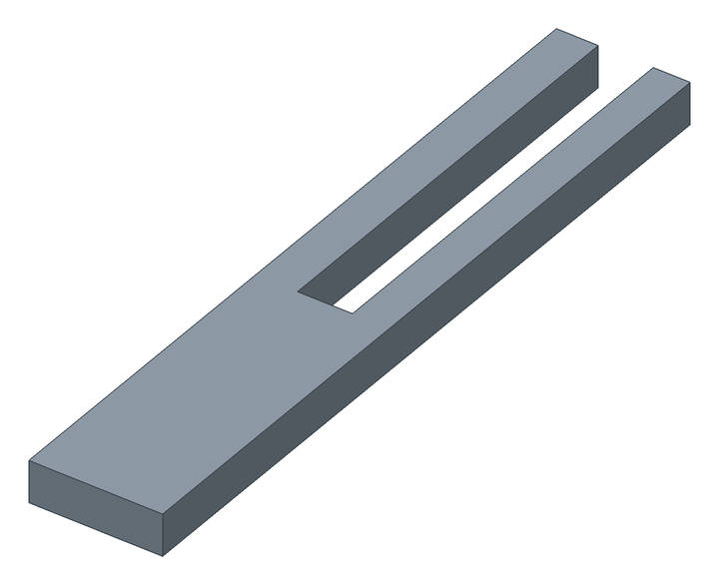
off-the-shelf/parts_img/src/atx_shim.png
