ooropuloo/MFKVM/off-the-shelf/parts_img/src/bridge.png

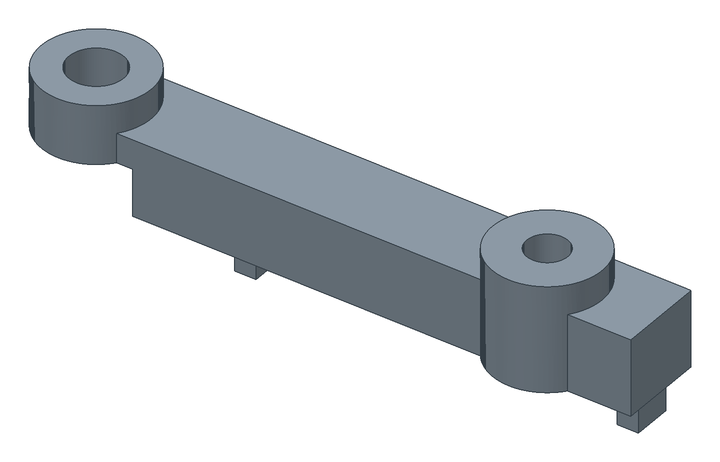
off-the-shelf/parts_img/src/bridge.png
