ooropuloo/MFKVM/off-the-shelf/parts_img/src/former.png

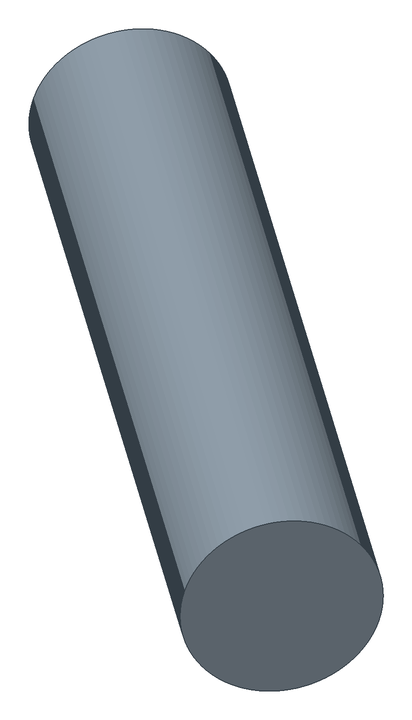
off-the-shelf/parts_img/src/former.png
