ooropuloo/MFKVM/off-the-shelf/parts_img/src/lid.png

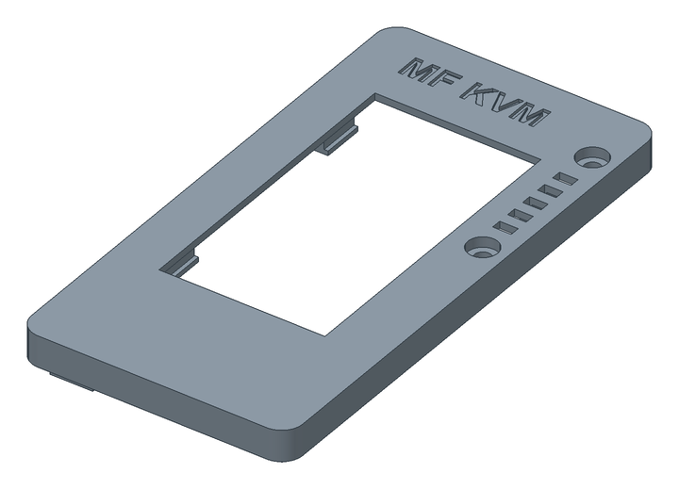
off-the-shelf/parts_img/src/lid.png
