ooropuloo/MFKVM/off-the-shelf/parts_img/src/tray.png

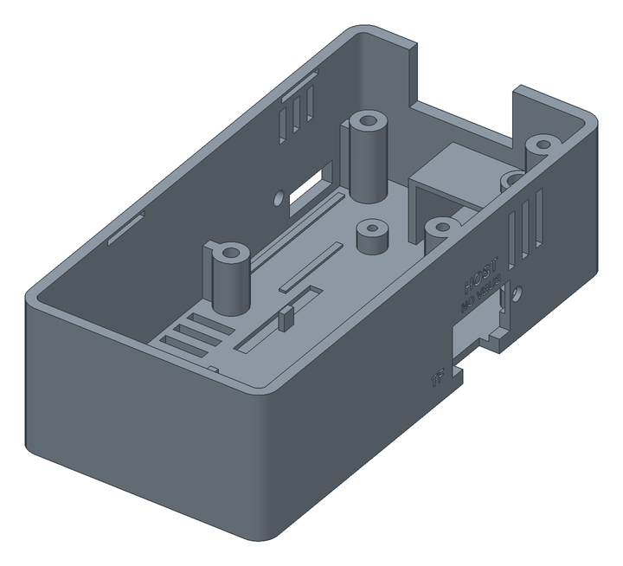
off-the-shelf/parts_img/src/tray.png
