ooropuloo/MFKVM/lay-board/r7f/case/stl/mf_kvm_gapfill.step

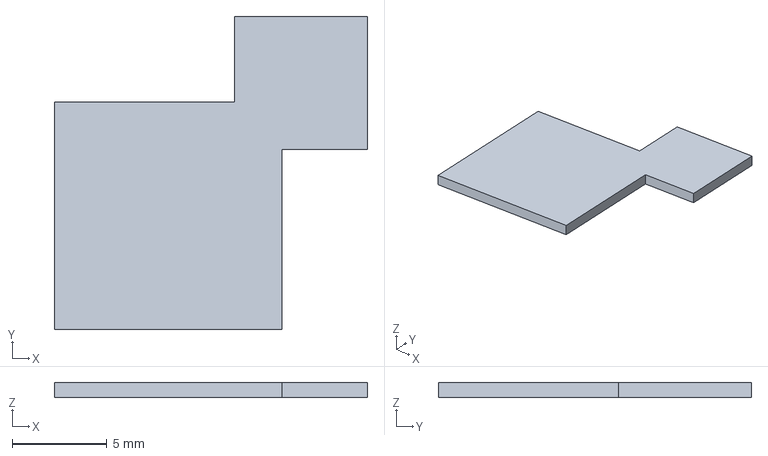
[picture p47: CAD file, 2026-11-09]
lay-board/r7f/case/stl/mf_kvm_gapfill.step
16.5 x 16.5 x 0.79 mm
