ooropuloo/MFKVM/lay-board/r7f/case/stl/mf_kvm_tray.step

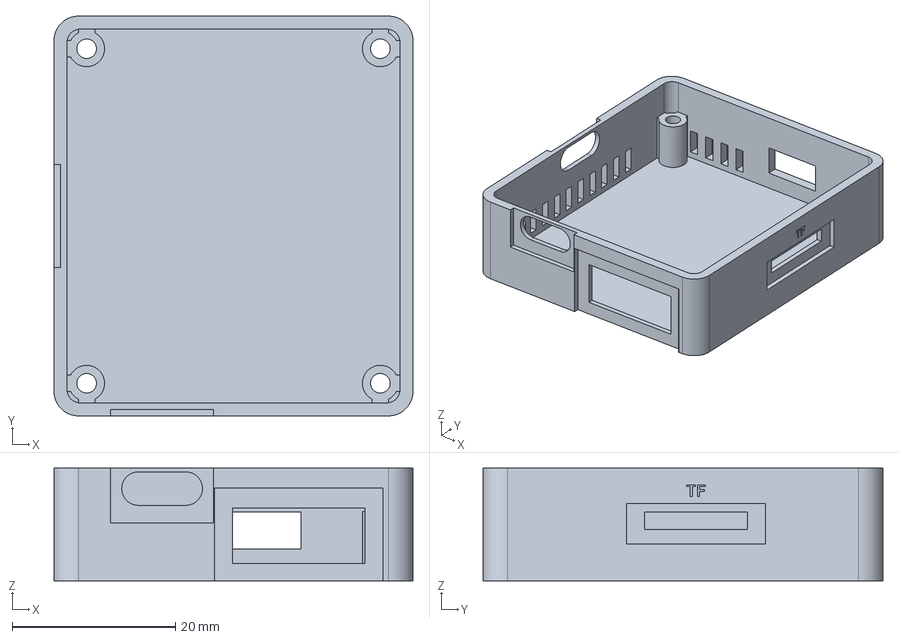
[picture p48: CAD file, 2026-11-09]
lay-board/r7f/case/stl/mf_kvm_tray.step
44.0 x 49.0 x 13.8 mm
