ooropuloo/MFKVM/lay-board/r7f/case/stl/mf_kvm_plate.step

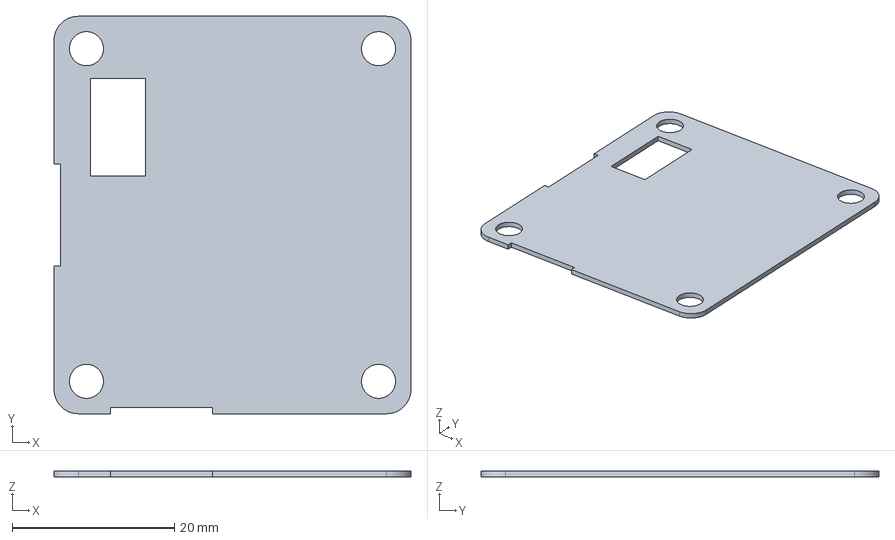
[picture p49: CAD file, 2026-11-09]
lay-board/r7f/case/stl/mf_kvm_plate.step
44.0 x 49.0 x 0.8 mm
