ooropuloo/MFKVM/lay-board/r7f/case/stl/mf_kvm_lid.step

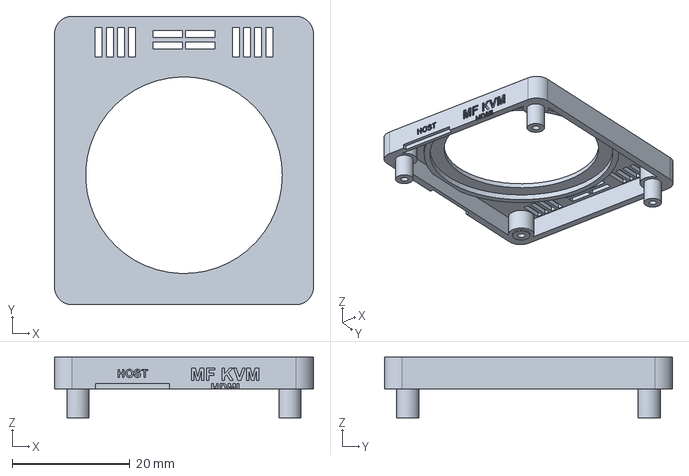
[picture p50: CAD file, 2026-11-09]
lay-board/r7f/case/stl/mf_kvm_lid.step
44.0 x 49.0 x 10.3 mm
