ooropuloo/MFKVM/lay-board/r7f/case/stl/mf_kvm_fanduct.step

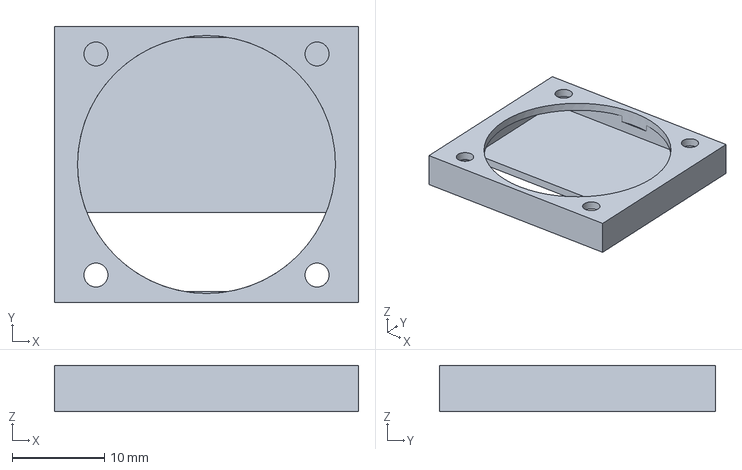
[picture p51: CAD file, 2026-11-09]
lay-board/r7f/case/stl/mf_kvm_fanduct.step
33.0 x 30.0 x 5.00 mm
