ooropuloo/MFKVM/off-the-shelf/case/asm/core_board.stl

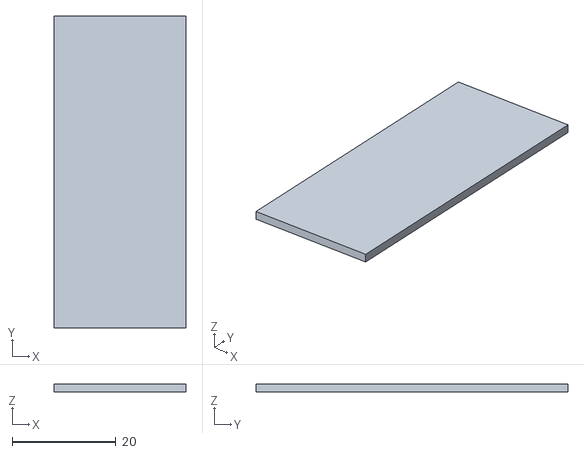
[picture p52: CAD file, 2026-11-11]
off-the-shelf/case/asm/core_board.stl
25.4 x 60.0 x 1.62
