ooropuloo/MFKVM/off-the-shelf/case/step/mf_kvm_tray.step

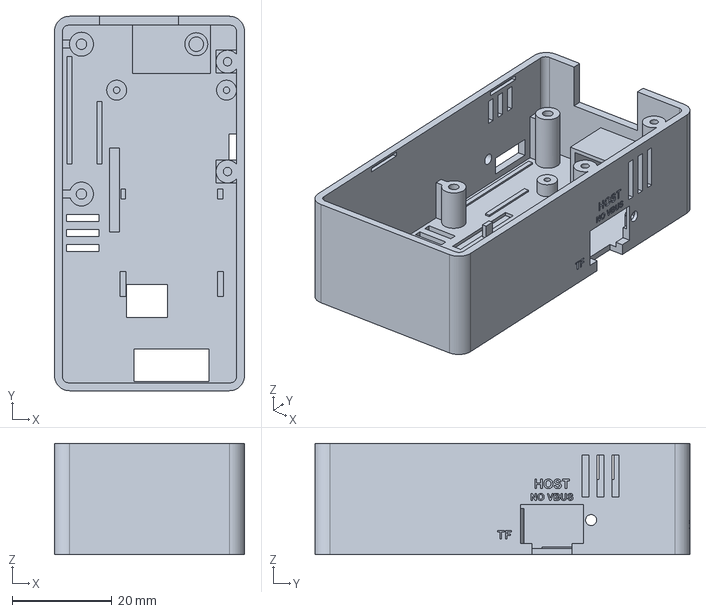
[picture p53: CAD file, 2026-11-06]
off-the-shelf/case/step/mf_kvm_tray.step
38.0 x 75.0 x 22.3 mm
