ooropuloo/MFKVM/off-the-shelf/case/asm/core_parts.stl

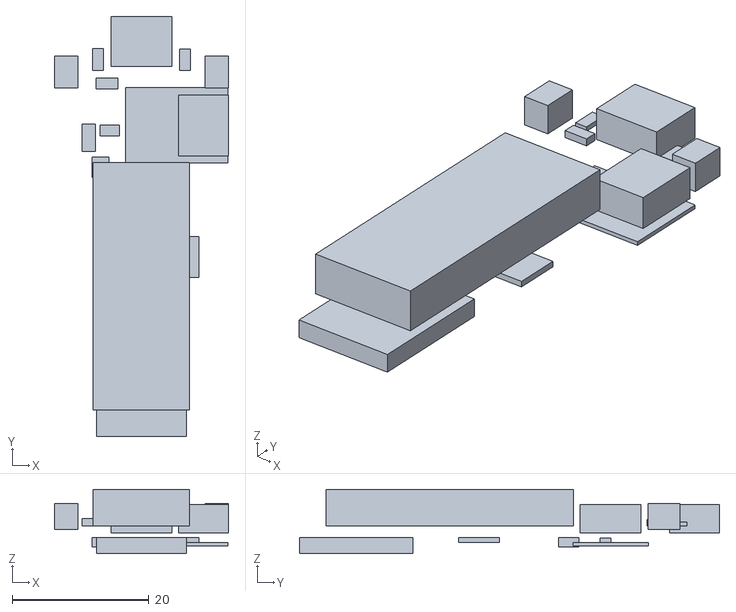
[picture p54: CAD file, 2026-11-11]
off-the-shelf/case/asm/core_parts.stl
25.5 x 61.5 x 9.42
