ooropuloo/MFKVM/off-the-shelf/case/step/mf_kvm_former.step

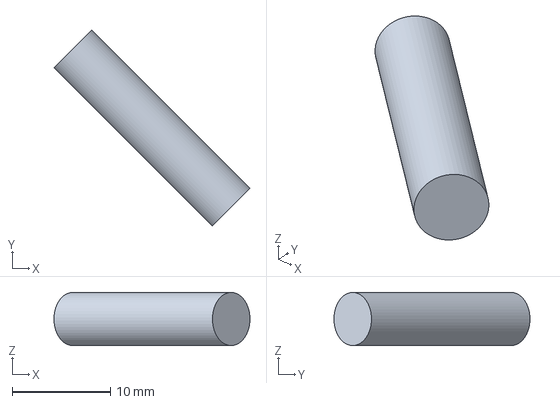
[picture p55: CAD file, 2026-11-06]
off-the-shelf/case/step/mf_kvm_former.step
19.9 x 19.9 x 5.40 mm
