ooropuloo/MFKVM/off-the-shelf/case/asm/fpc.stl

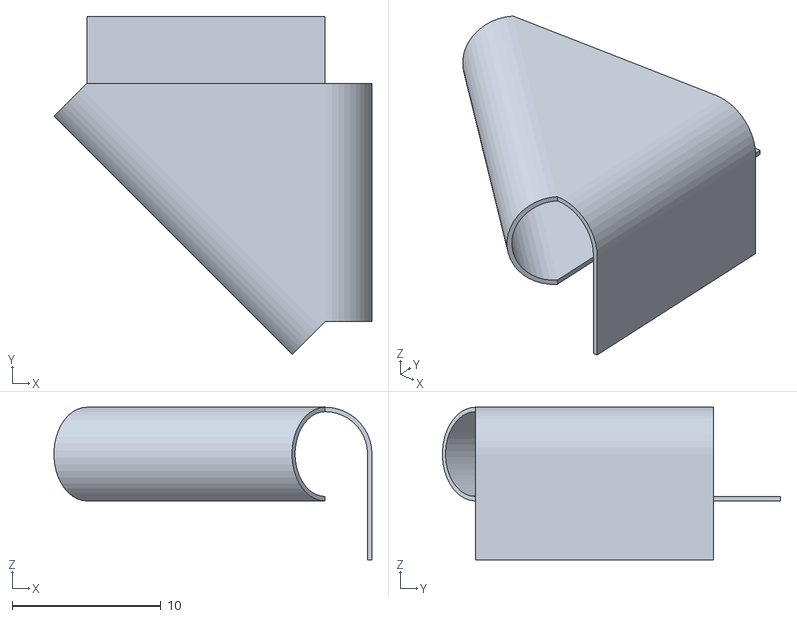
[picture p56: CAD file, 2026-11-06]
off-the-shelf/case/asm/fpc.stl
21.4 x 22.7 x 10.3
