ooropuloo/MFKVM/off-the-shelf/case/step/mf_kvm_bridge.step

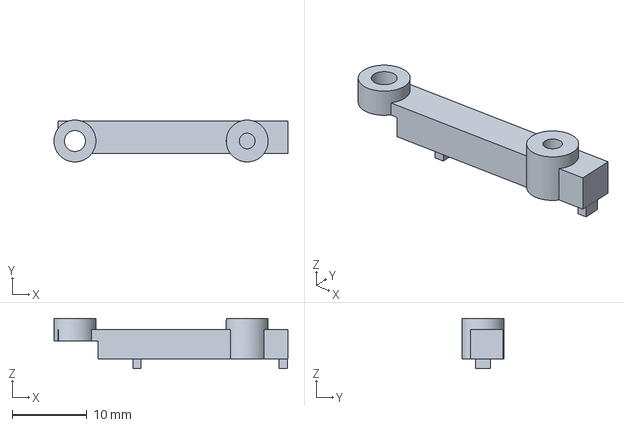
[picture p57: CAD file, 2026-11-06]
off-the-shelf/case/step/mf_kvm_bridge.step
31.2 x 5.60 x 6.71 mm
