ooropuloo/MFKVM/off-the-shelf/case/asm/lcd.stl

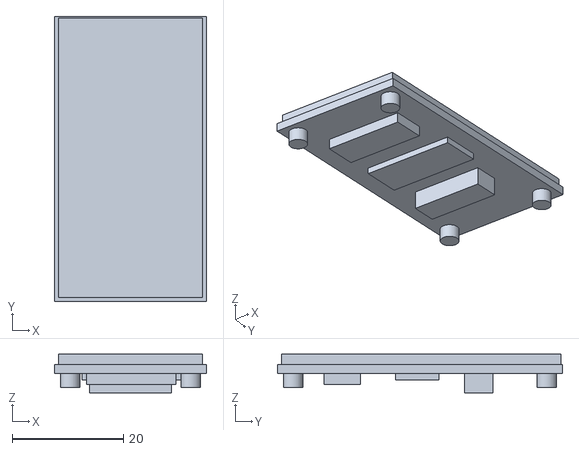
[picture p58: CAD file, 2026-11-06]
off-the-shelf/case/asm/lcd.stl
27.3 x 51.2 x 7.00
