ooropuloo/MFKVM/off-the-shelf/case/step/mf_kvm_lid.step

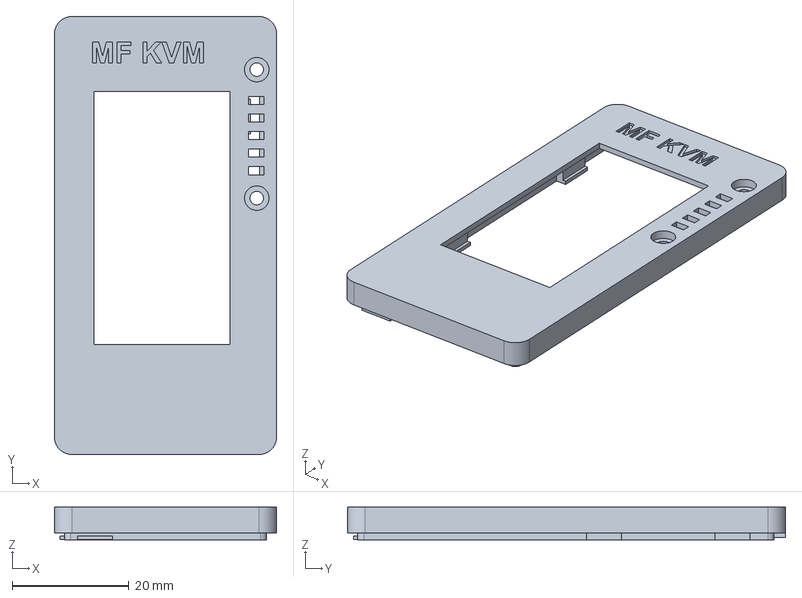
[picture p59: CAD file, 2026-11-06]
off-the-shelf/case/step/mf_kvm_lid.step
38.0 x 75.0 x 5.61 mm
