ooropuloo/MFKVM/off-the-shelf/case/asm/c790.stl

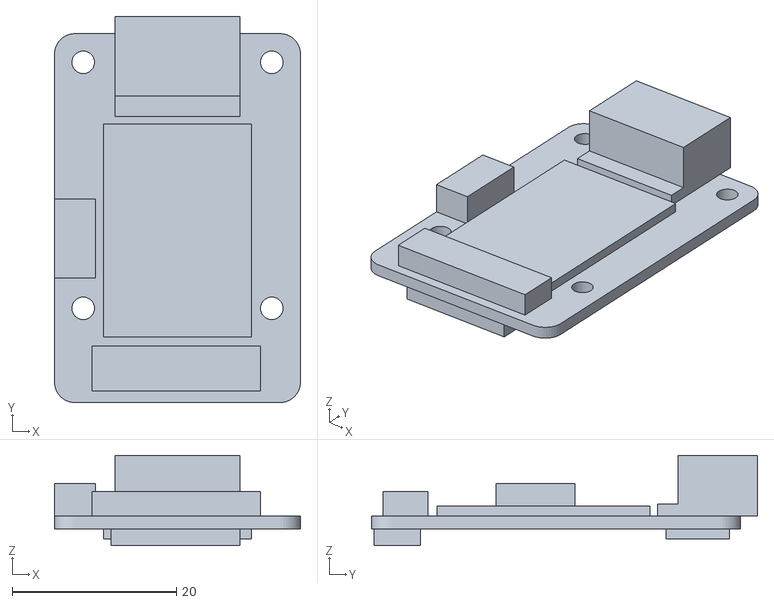
[picture p60: CAD file, 2026-11-06]
off-the-shelf/case/asm/c790.stl
30.0 x 47.1 x 11.0
