ooropuloo/MFKVM/off-the-shelf/case/step/mf_kvm_atx_shim.step

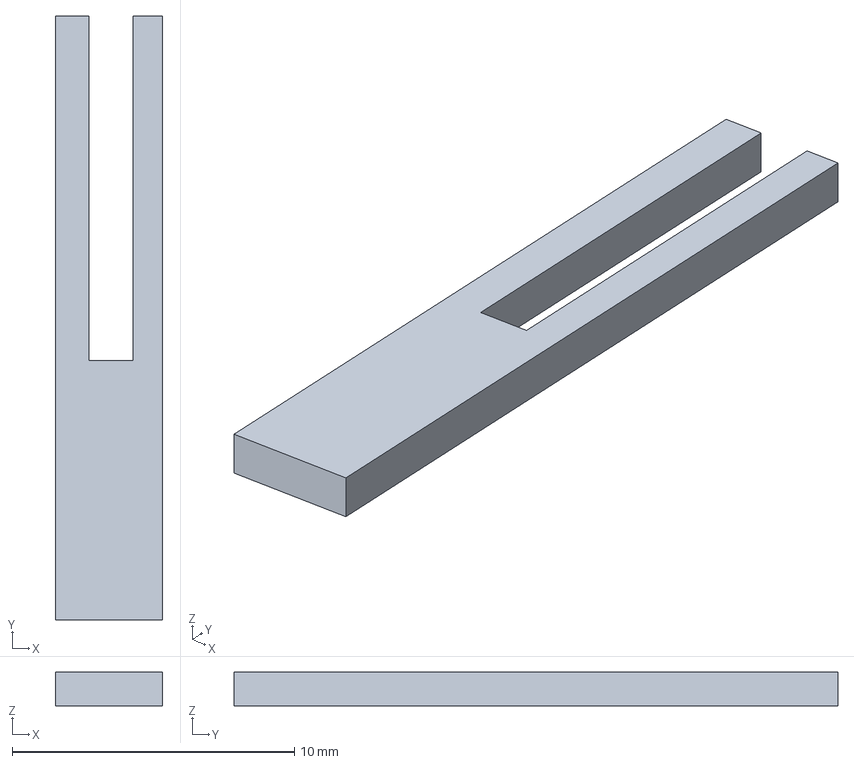
[picture p61: CAD file, 2026-11-06]
off-the-shelf/case/step/mf_kvm_atx_shim.step
3.80 x 21.4 x 1.20 mm
