ooropuloo/MFKVM/off-the-shelf/case/asm/atx.stl

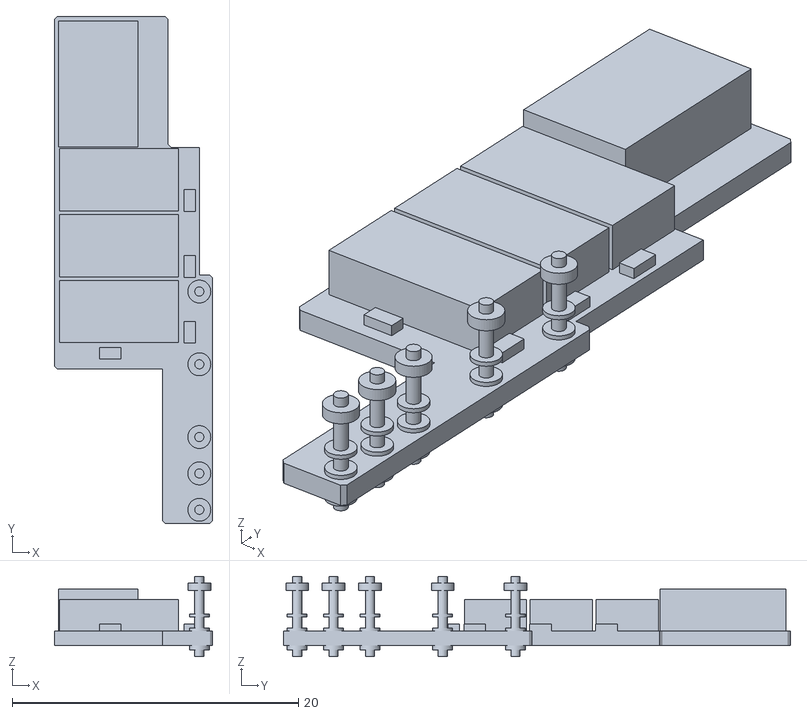
[picture p62: CAD file, 2026-11-06]
off-the-shelf/case/asm/atx.stl
11.0 x 35.4 x 5.60
