ooropuloo/MFKVM/lay-board/case/stl/mf_kvm_tray.step

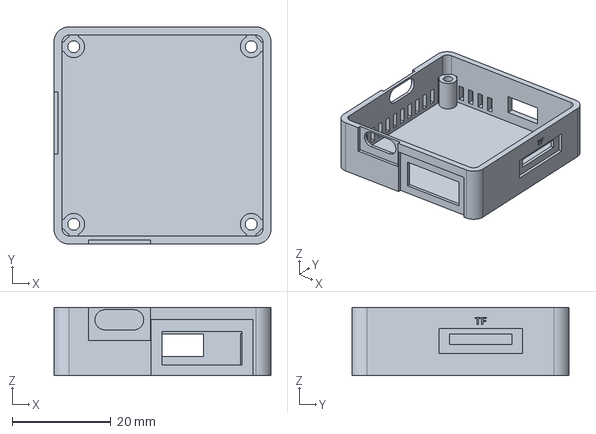
[picture p63: CAD file, 2026-11-06, an earlier design]
lay-board/case/stl/mf_kvm_tray.step
44.0 x 44.0 x 13.8 mm
