ooropuloo/MFKVM/lay-board/case/stl/mf_kvm_lid.step

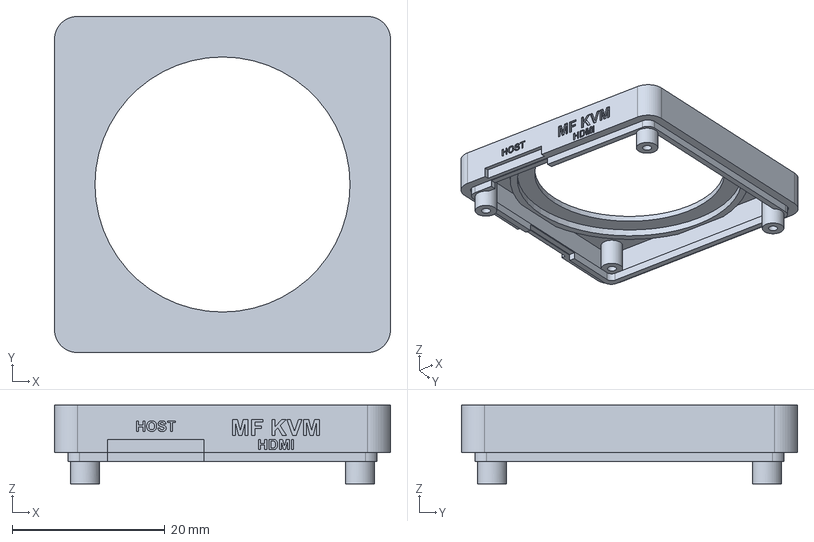
[picture p64: CAD file, 2026-11-06, an earlier design]
lay-board/case/stl/mf_kvm_lid.step
44.0 x 44.0 x 10.3 mm
