ooropuloo/MFKVM/(list of files, cad)

Other CAD files:
lay-board/case/stl/mf_kvm_lid.stl
lay-board/case/stl/mf_kvm_tray.stl
lay-board/r7f/case/stl/mf_kvm_fanduct.stl
lay-board/r7f/case/stl/mf_kvm_lid.stl
lay-board/r7f/case/stl/mf_kvm_plate.stl
lay-board/r7f/case/stl/mf_kvm_tray.stl
off-the-shelf/case/stl/mf_kvm_atx_shim.stl
off-the-shelf/case/stl/mf_kvm_bridge.stl
off-the-shelf/case/stl/mf_kvm_former.stl
off-the-shelf/case/stl/mf_kvm_lid.stl
off-the-shelf/case/stl/mf_kvm_tray.stl
