ooropuloo/MFKVM/lay-board/courtyard_review/img/fix_A_ssop_preview.png

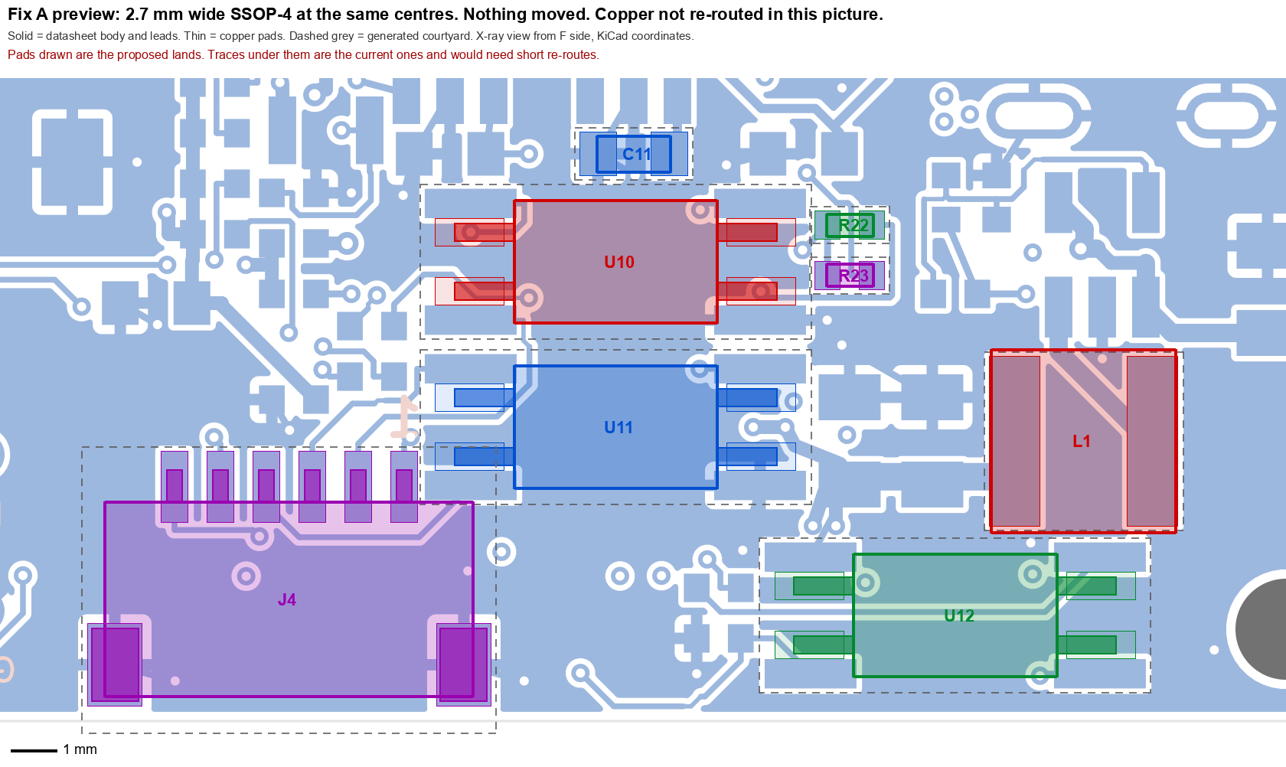
lay-board/courtyard_review/img/fix_A_ssop_preview.png
