ooropuloo/MFKVM/off-the-shelf/fab_atx_b/mf_kvm_atx_schematic.pdf

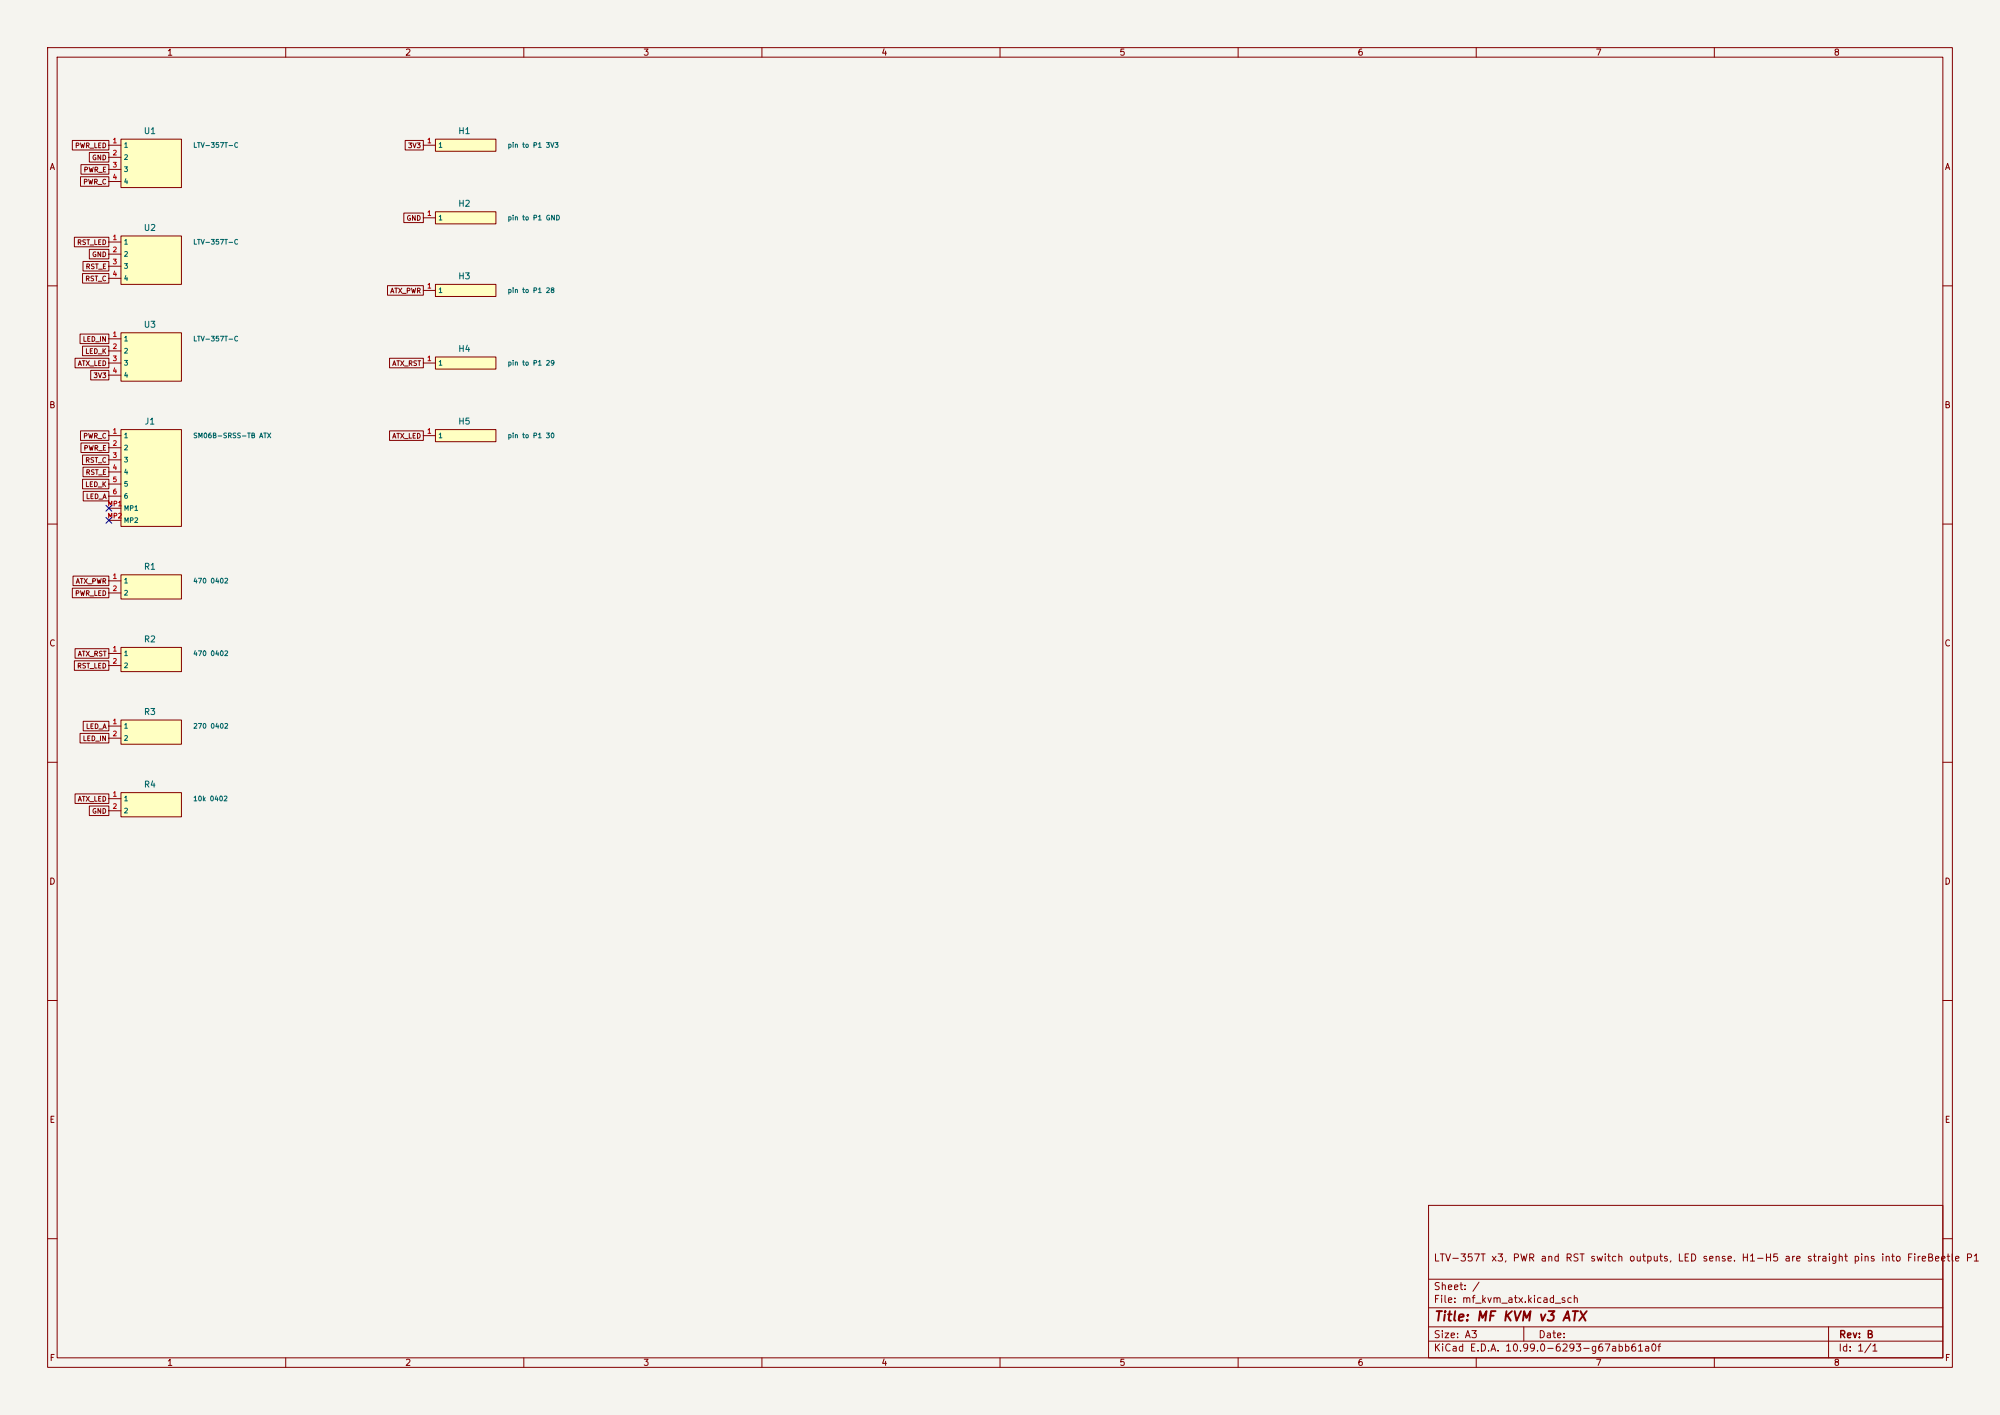
[picture p66: page 1]

LTV-357T x3, PWR and RST switch outputs, LED sense. H1-H5 are straight pins into FireBeetle P1

Sheet: /
File: mf_kvm_atx.kicad_sch
Title: MF KVM v3 ATX

Size: A3 | Rev: B | F Date:
KiCad E.D.A. 10.99.0-6293-g67abb61a0f | Id: 1/1
