ooropuloo/MFKVM/lay-board/r7f/fab_r7f/p4_kvm_mini_schematic.pdf

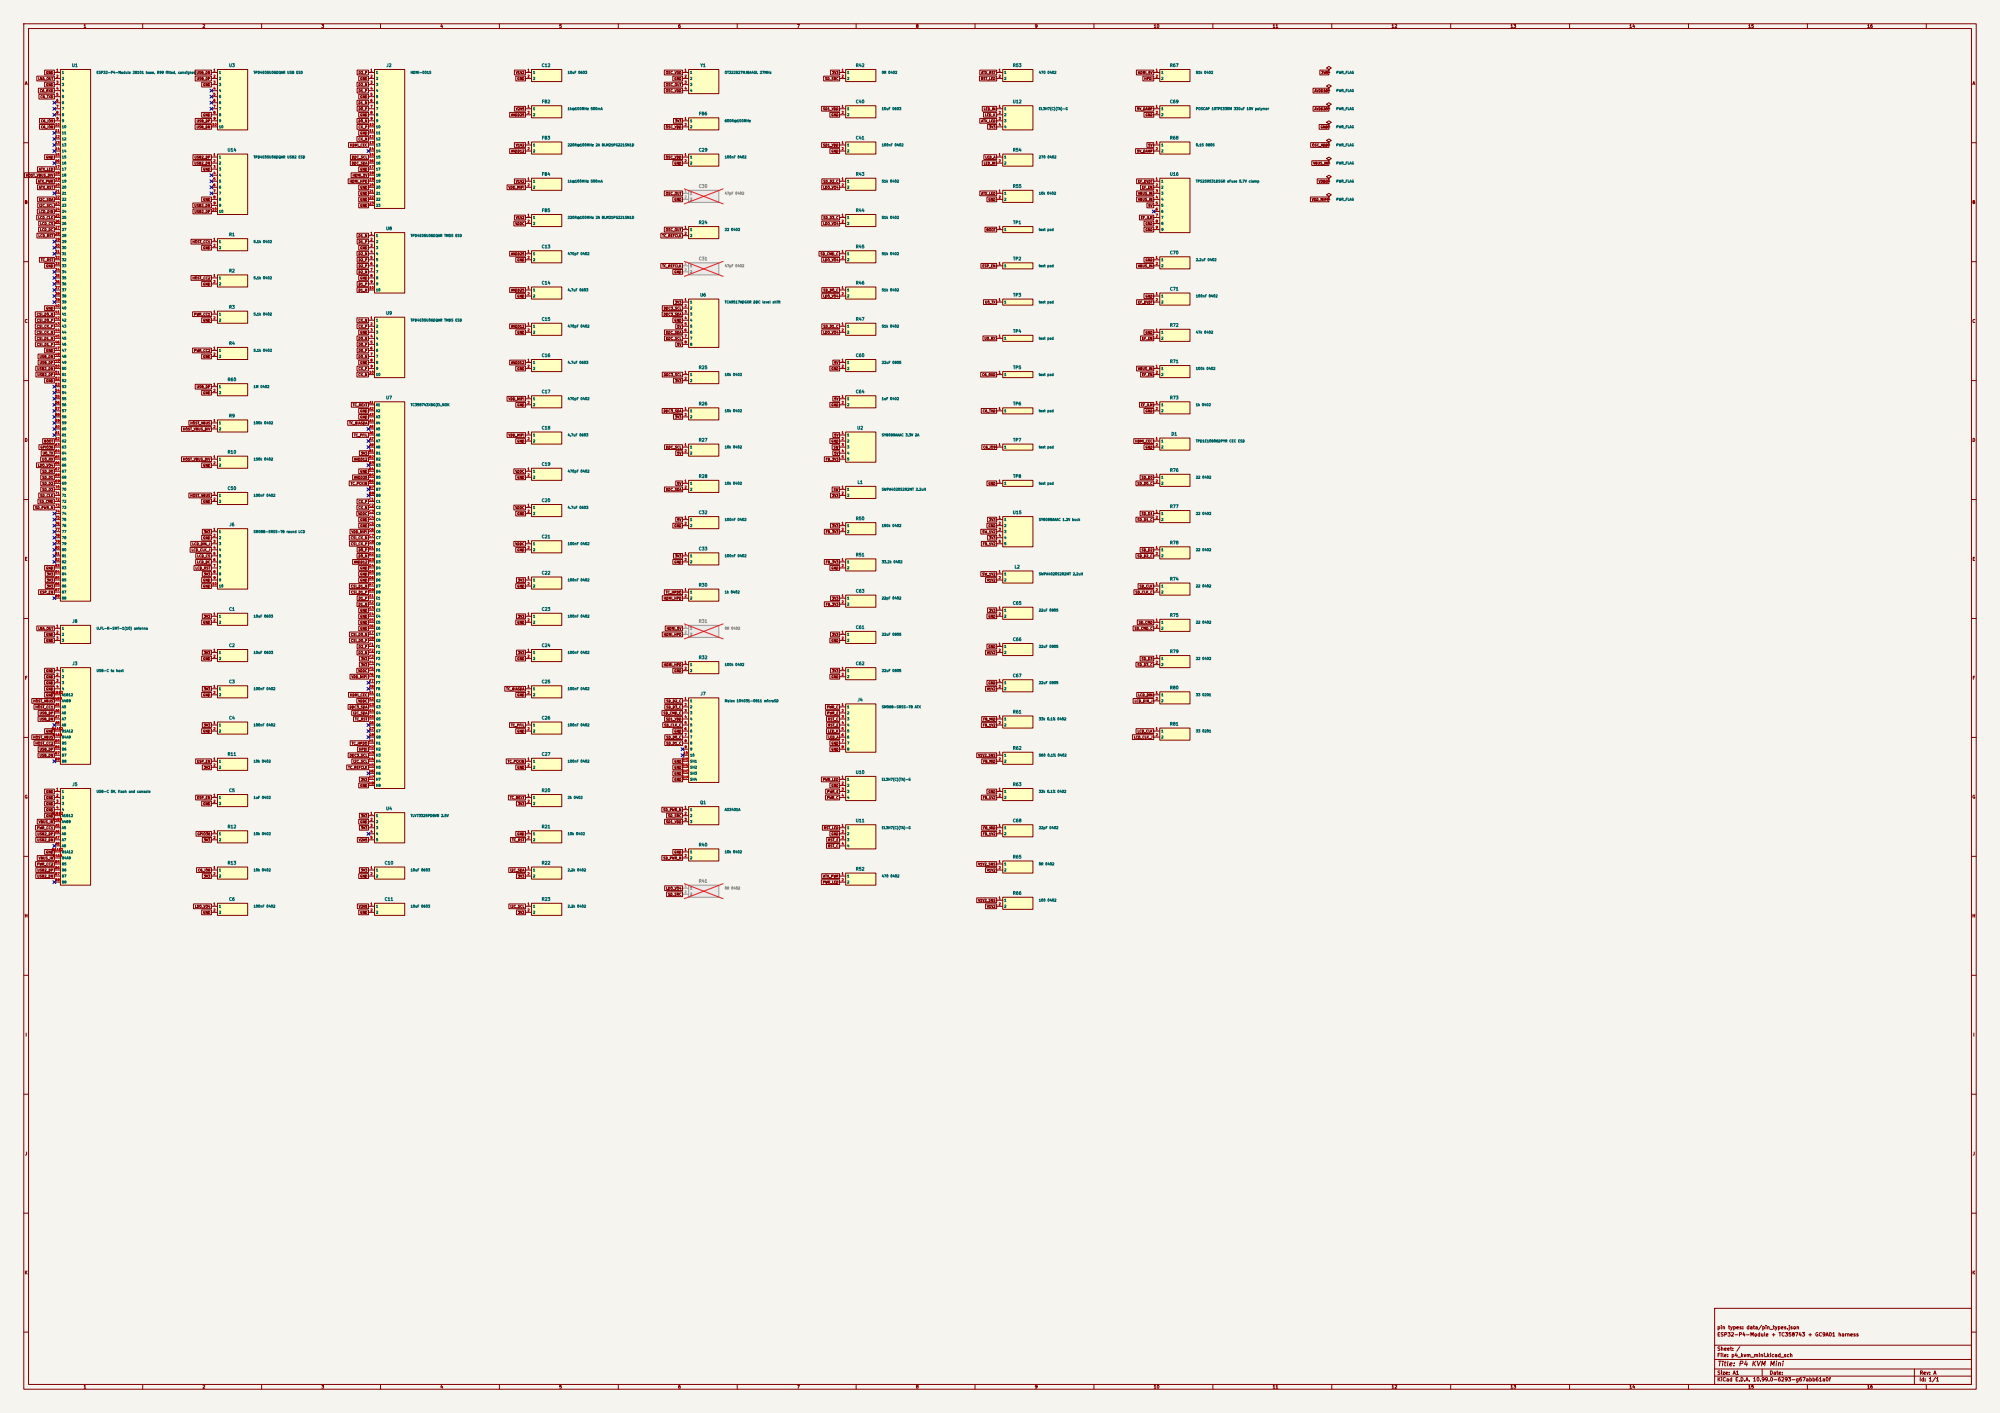
[picture p67: page 1]

Size: A1 | Rev: A
KiCad E.D.A. 10.99.0-6293-g67abb61a0f | Id: 1/1
