ooropuloo/MFKVM/lay-board/r7f/pdf/r7f_KiCad原始電路圖.pdf

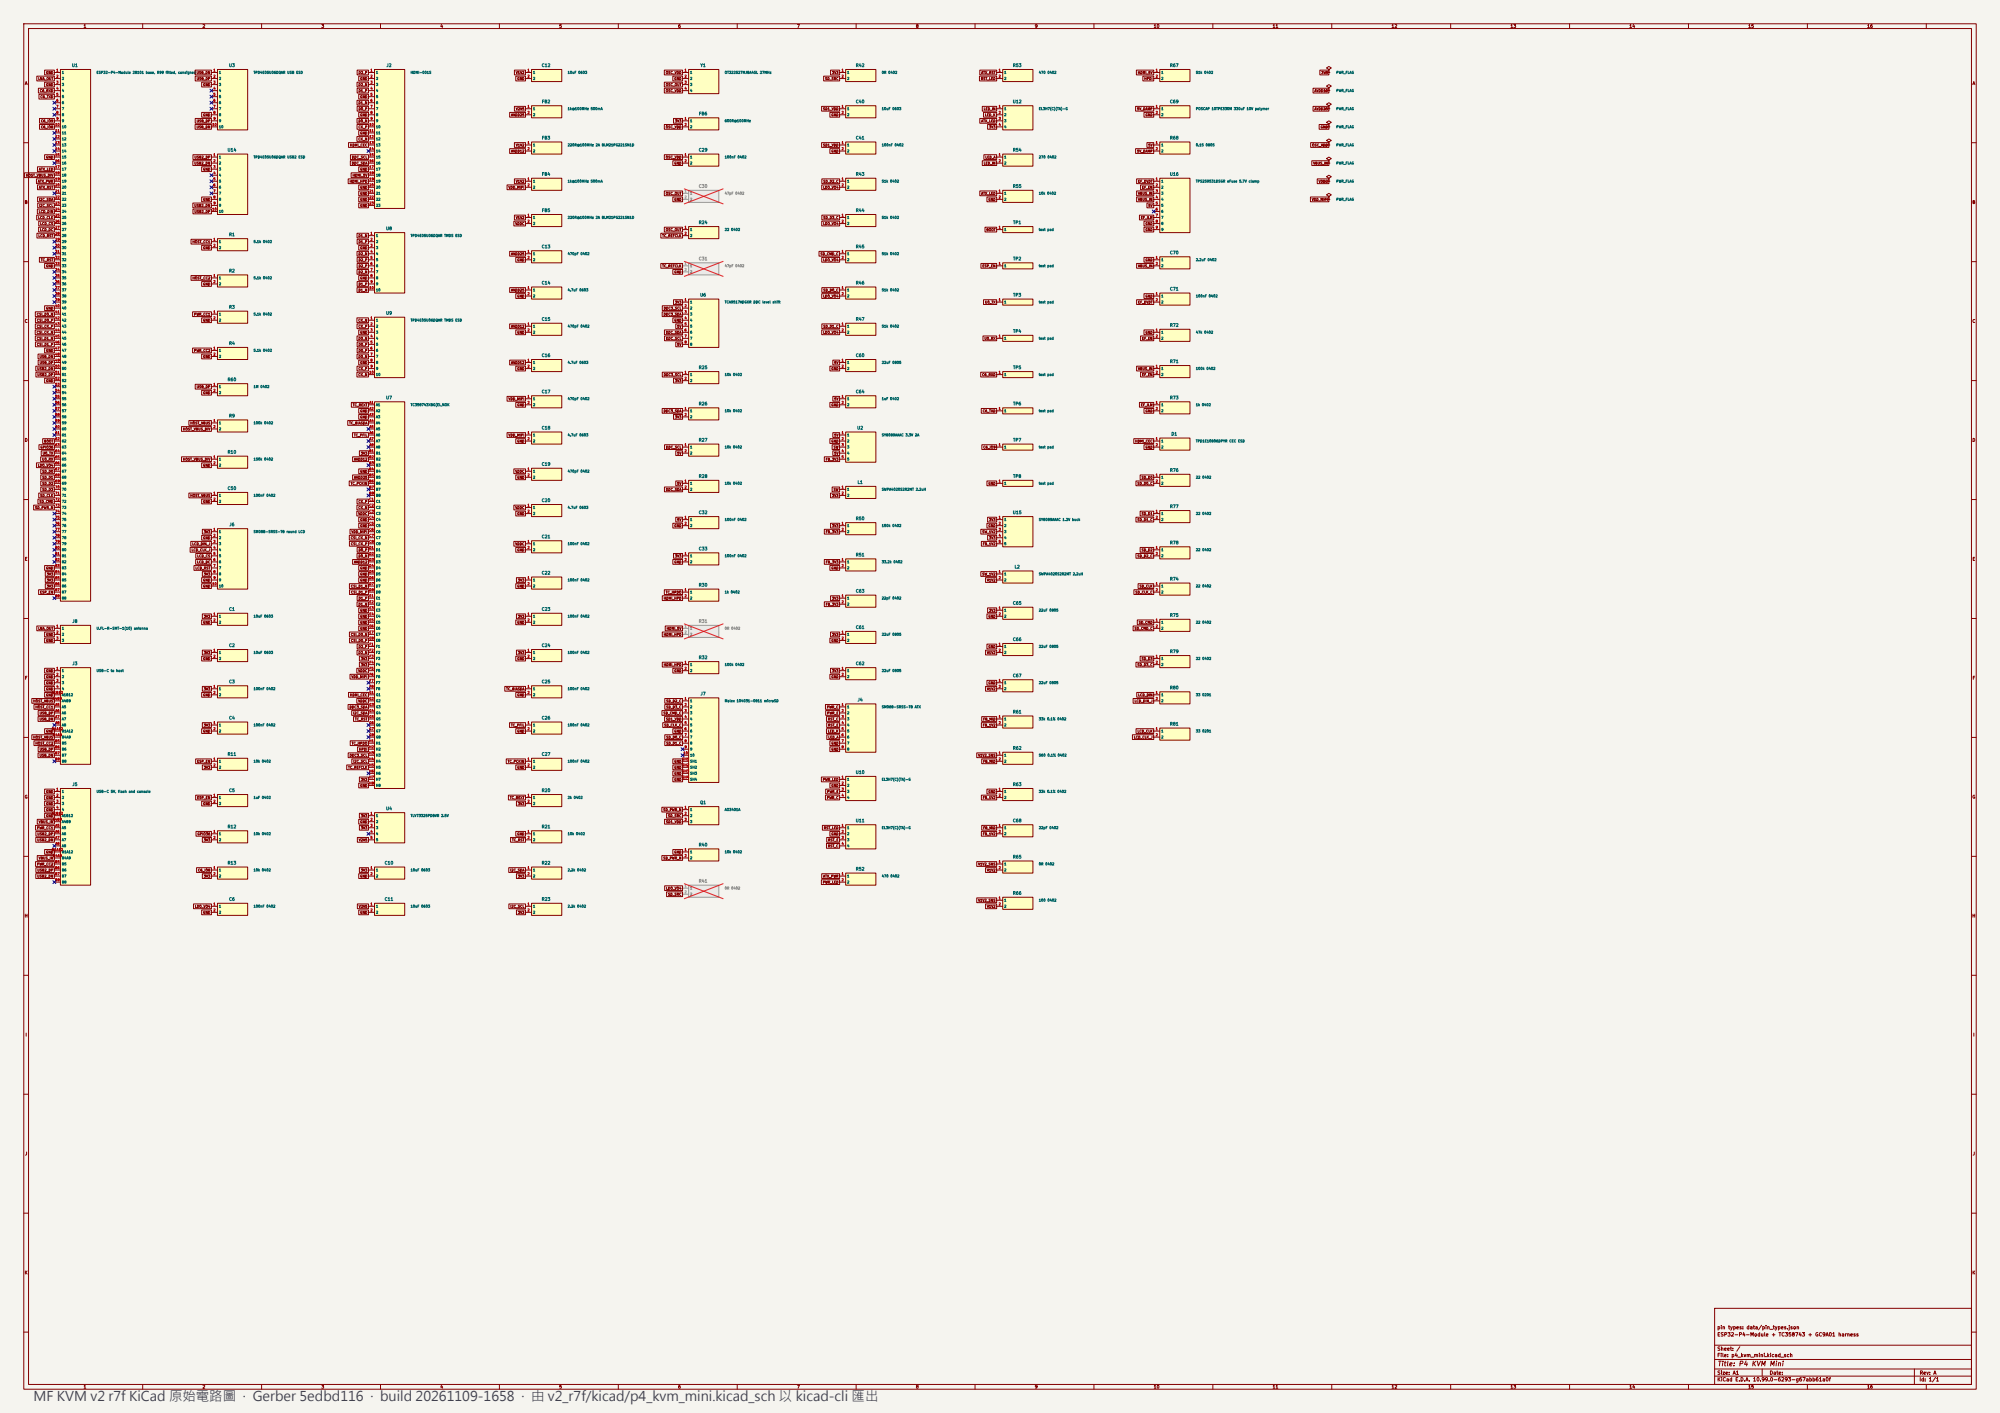
[picture p81: page 1]

ESP32-P4-Module 28101 base, R99 fitted, consigned

SM08B-SRSS-TB round LCD

pin types: data/pin_types.json
ESP32-P4-Module + TC358743 + GC9A01 harness

Size: A1 | Rev: A
KiCad E.D.A. 10.99.0-6293-g67abb61a0f | Id: 1/1

MF KVM v2 r7f KiCad 原始電路圖 · Gerber 5edbd116 · build 20261109-1658 · 由 v2_r7f/kicad/p4_kvm_mini.kicad_sch 以 kicad-cli 匯出
