ooropuloo/MFKVM/lay-board/r7f/pdf/r7f_PCB佈局圖.pdf

# 正面（Top）元件與走線，從正面看

L2

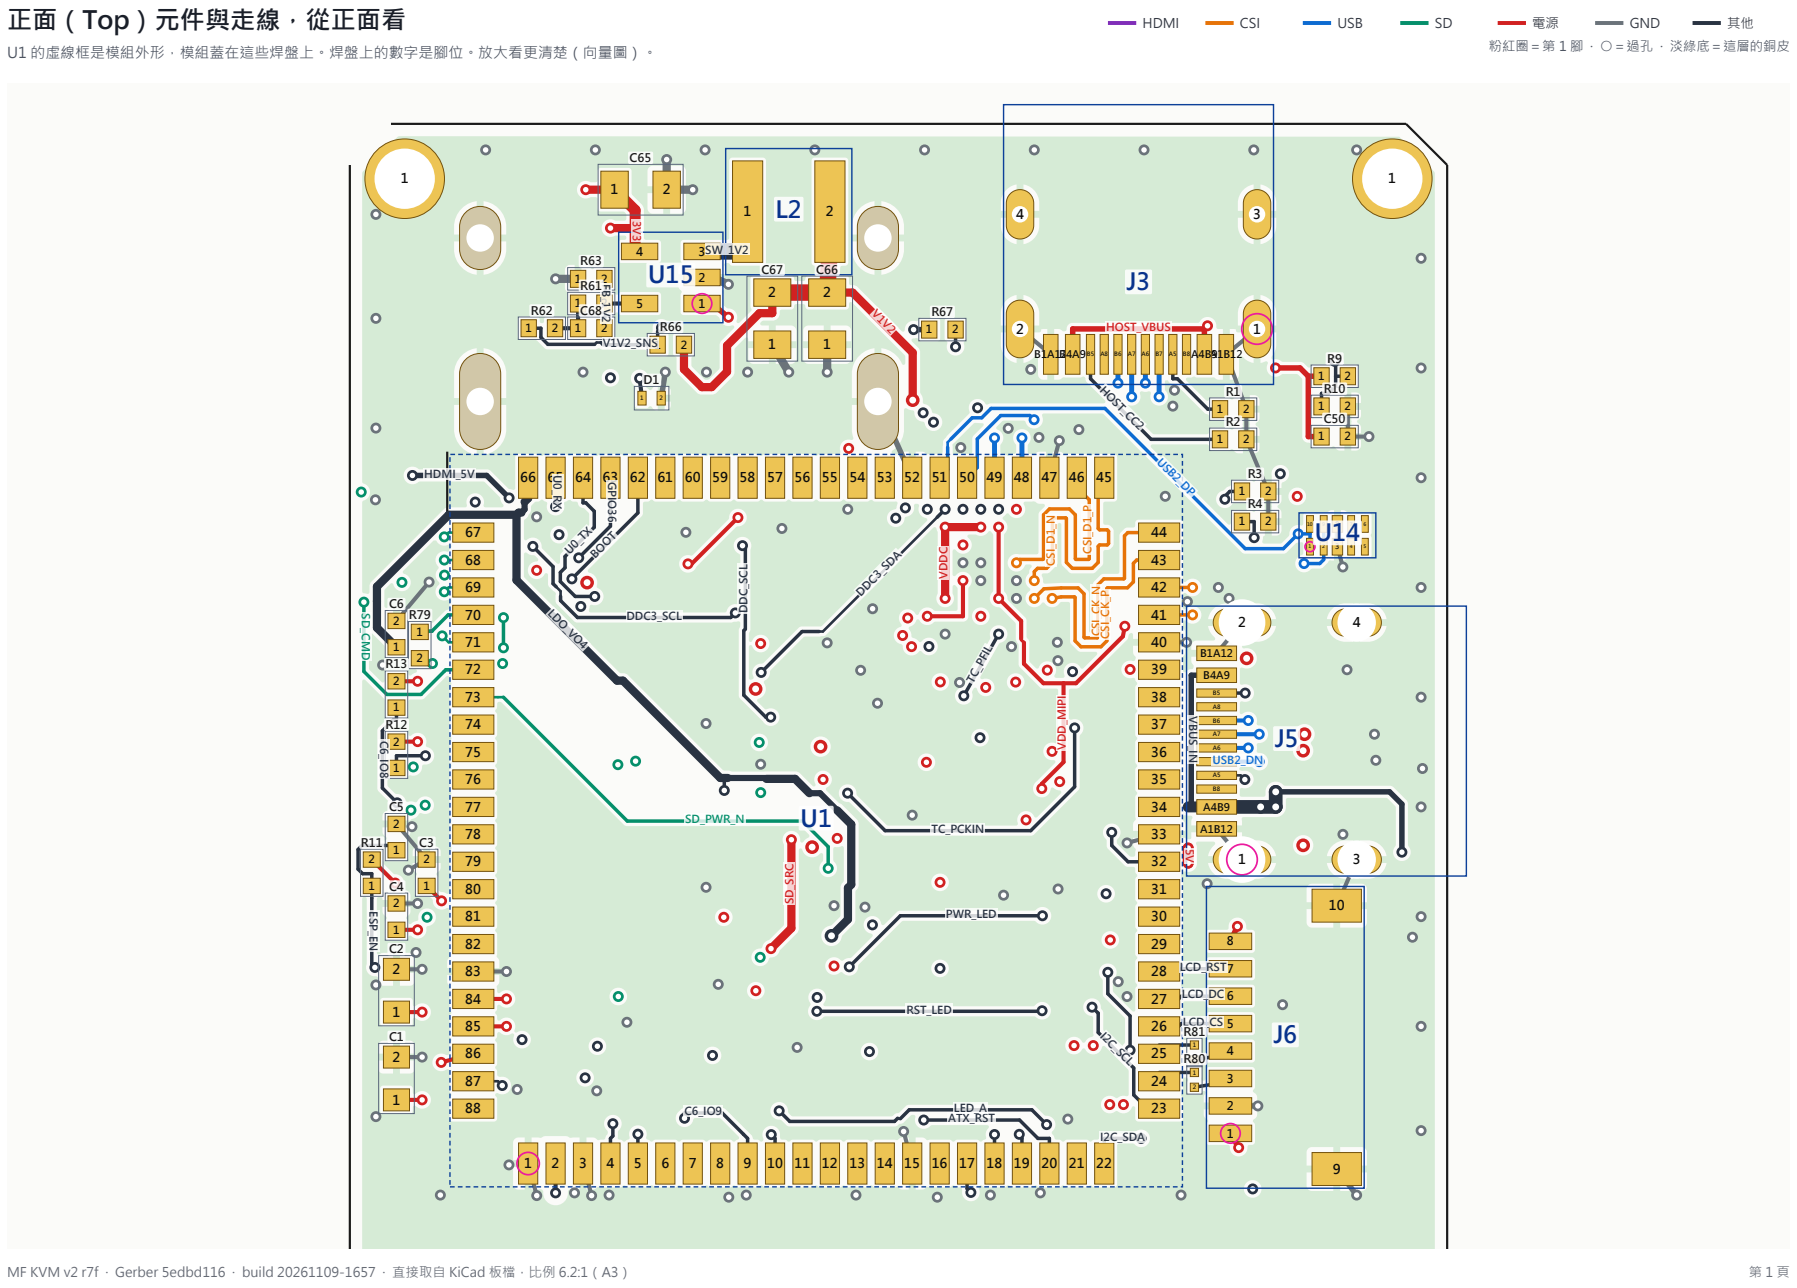
[picture p82: page 1]

U1 的虛線框是模組外形，模組蓋在這些焊盤上。焊盤上的數字是腳位。放大看更清楚（向量圖）。

粉紅圈＝第 1 腳 · ○＝過孔 · 淡綠底＝這層的銅皮

# 背面（Bottom）元件與走線，從背面看（左右鏡像，和 JLC 預覽同方向）

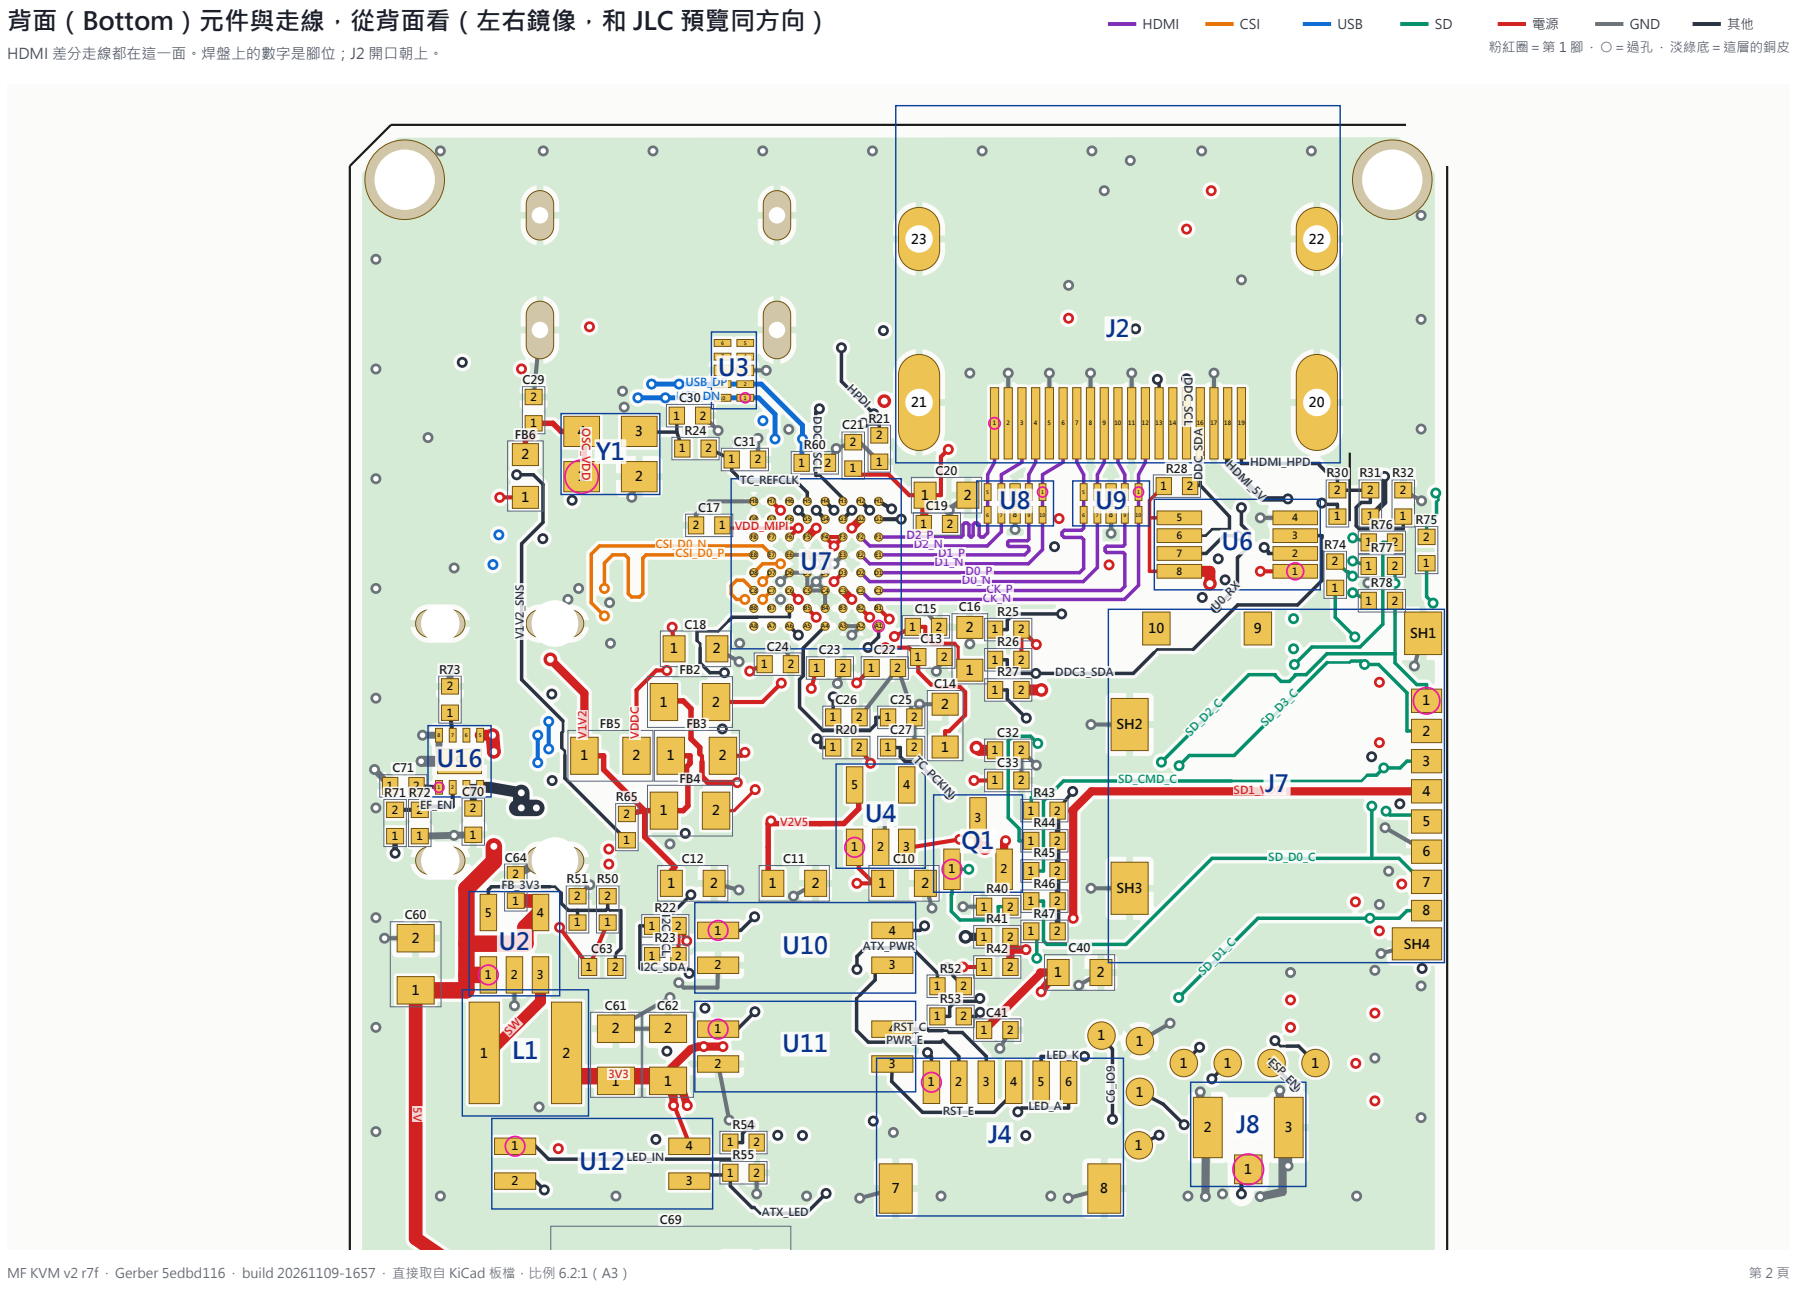
[picture p83: page 2]

HDMI 差分走線都在這一面。焊盤上的數字是腳位；J2 開口朝上。

# 內層 In2 走線，從正面看

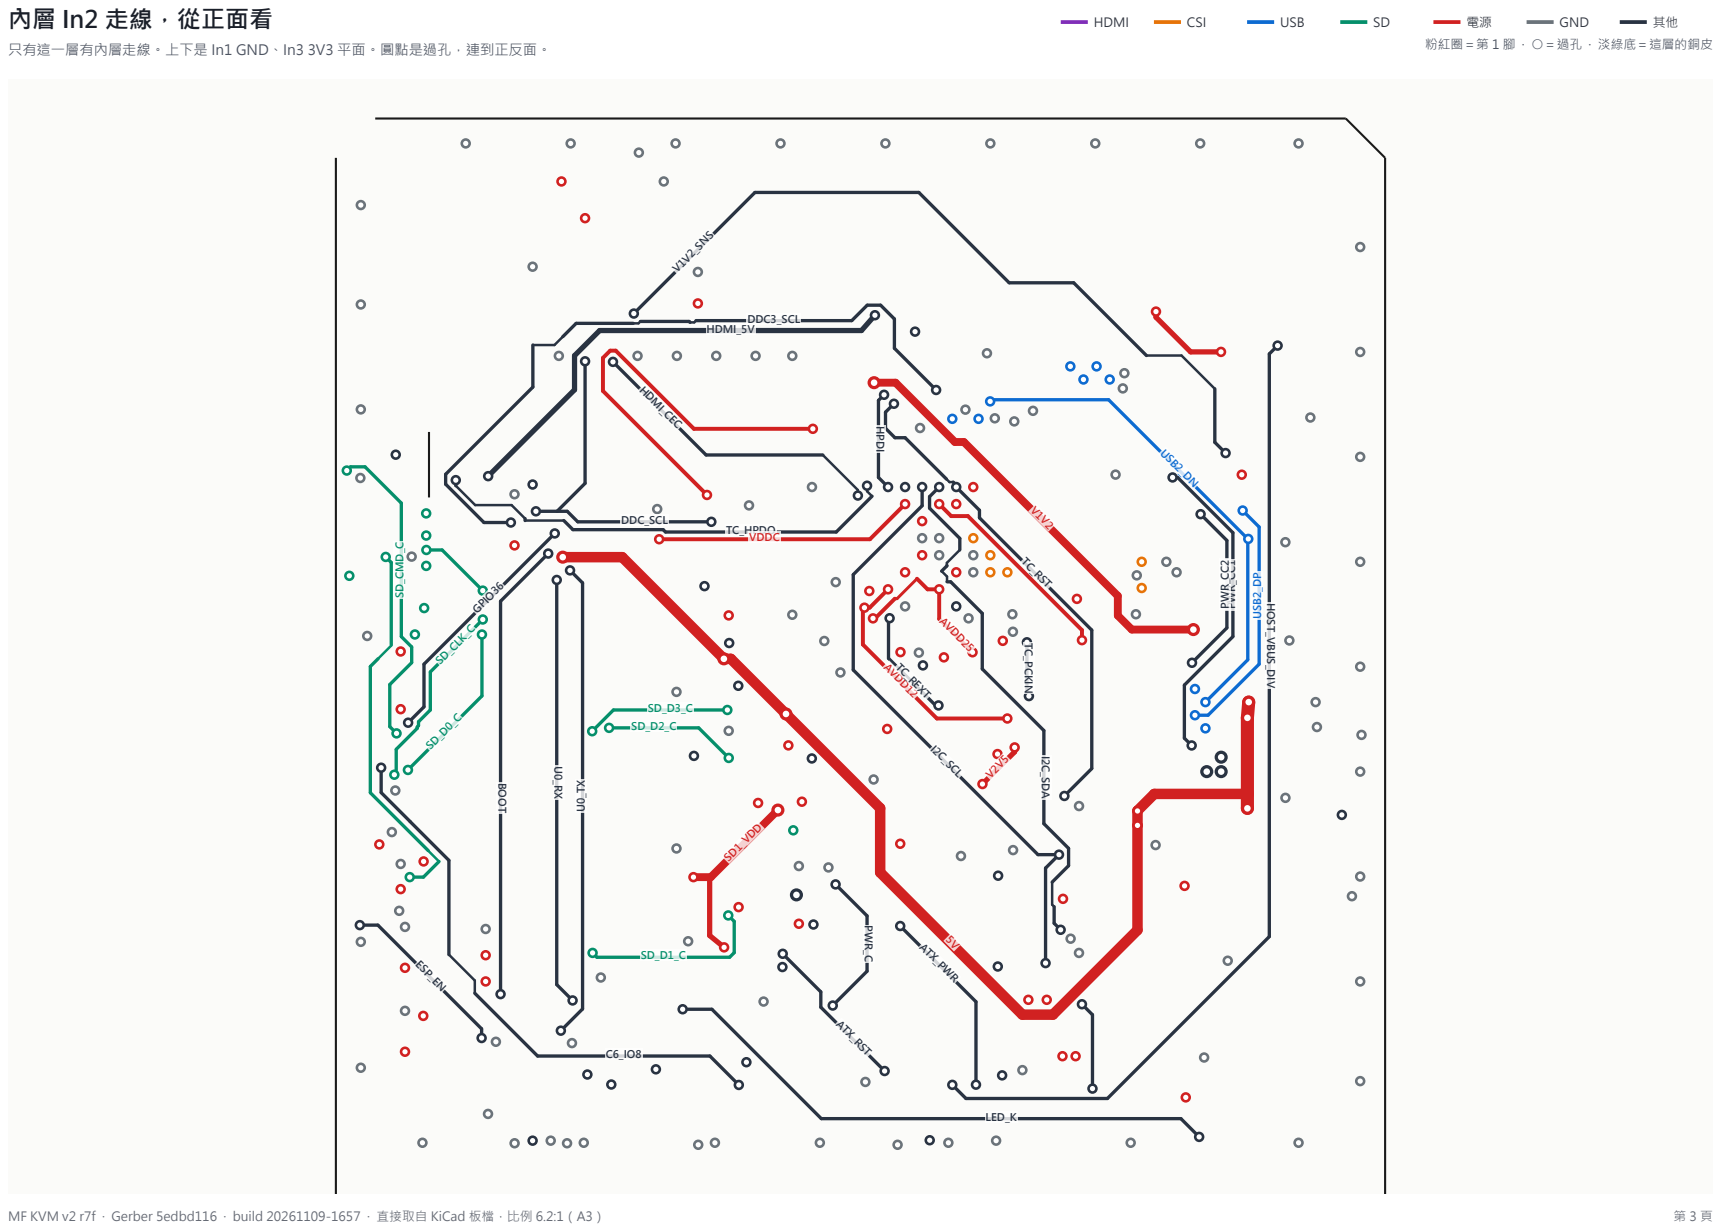
[picture p84: page 3]
MF KVM v2 r7f · Gerber 5edbd116 · build 20261109-1657 · 直接取自 KiCad 板檔，比例 6.2:1（A3）; 5V ATX_PWR; ATX_RST; AVDD12; AVDD25; BOOT; DDC3_SCL; DDC_SCL; ESP_EN; GPIO36; HDMI_5V; HDMI_CEC; HOST_VBUS_DIV; HPDI; I2C_SCL; I2C_SDA; LED_K; PWR_C; PWR_CC2 PWR_CC1; SD1_VDD; SD_CLK_C; SD_CMD_C; TC_HPDO; TC_PCKIN; TC_REXT; TC_RST; USB2_DN; USB2_DP; V1V2_SNS; VDDC

只有這一層有內層走線。上下是 In1 GND、In3 3V3 平面。圓點是過孔，連到正反面。

# 背面放大：HDMI 接頭 → ESD → U7（你圈的區域）

J2

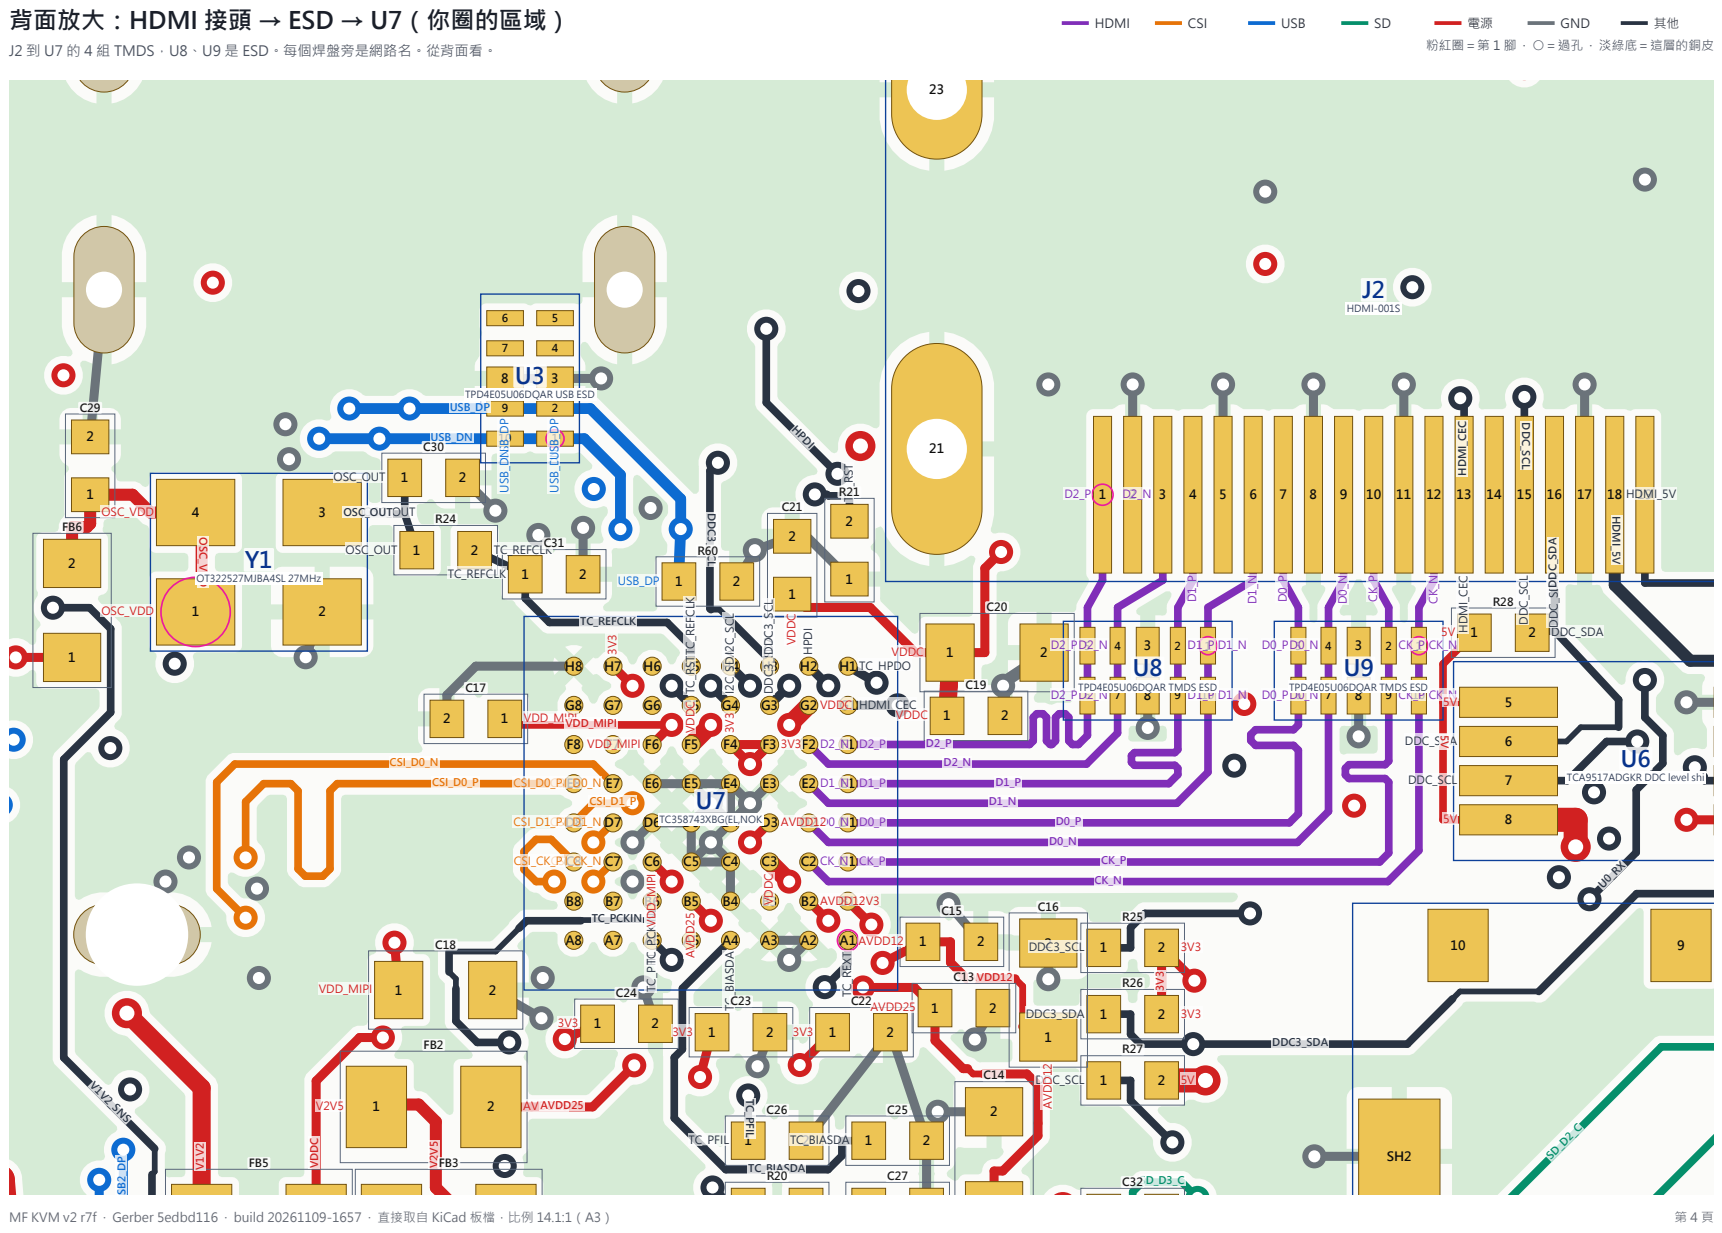
[picture p85: page 4]

J2 到 U7 的 4 組 TMDS，U8、U9 是 ESD。每個焊盤旁是網路名。從背面看。

# 背面放大：電源區 U16 eFuse、U2、L1、U4、Q1、光耦

U16

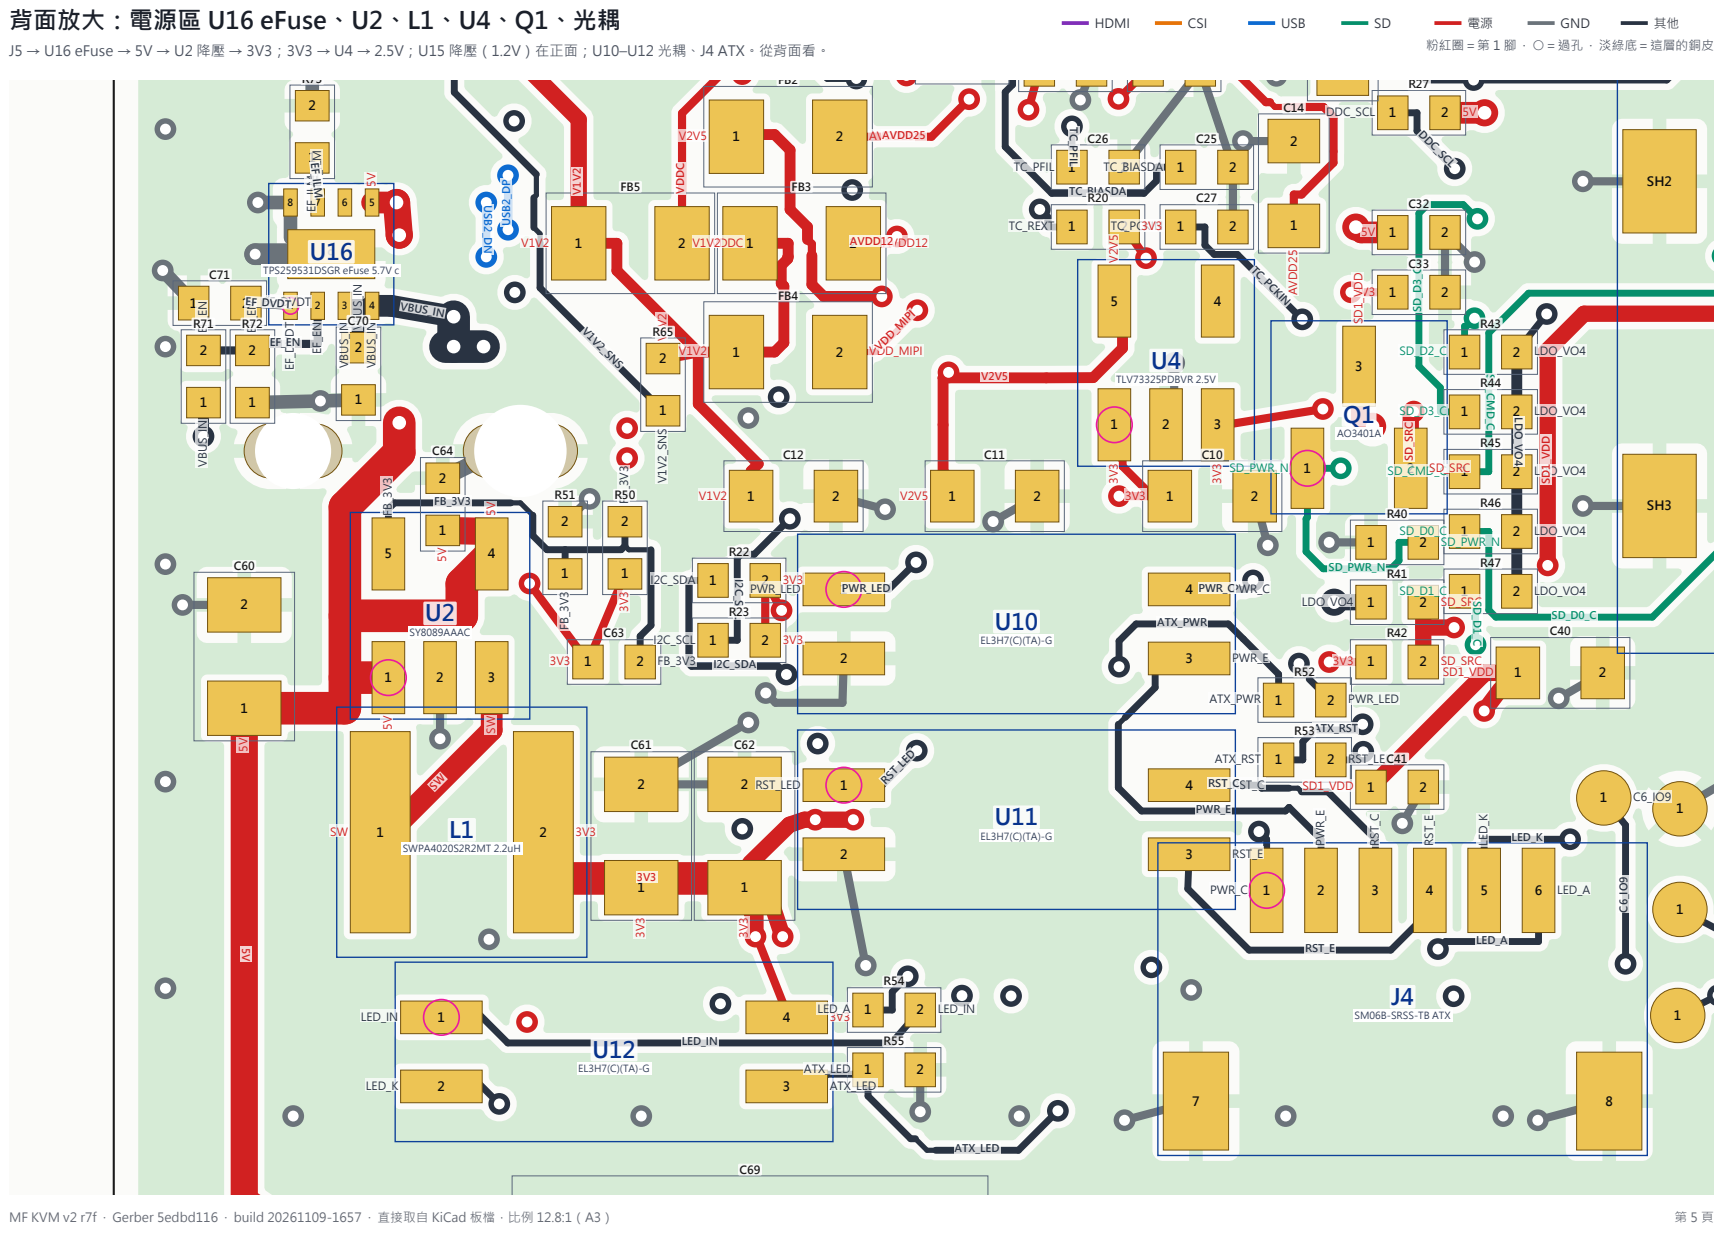
[picture p86: page 5]

J5 → U16 eFuse → 5V → U2 降壓 → 3V3；3V3 → U4 → 2.5V；U15 降壓（1.2V）在正面；U10–U12 光耦、J4 ATX。從背面看。

# 背面放大：microSD J7、U6

U9

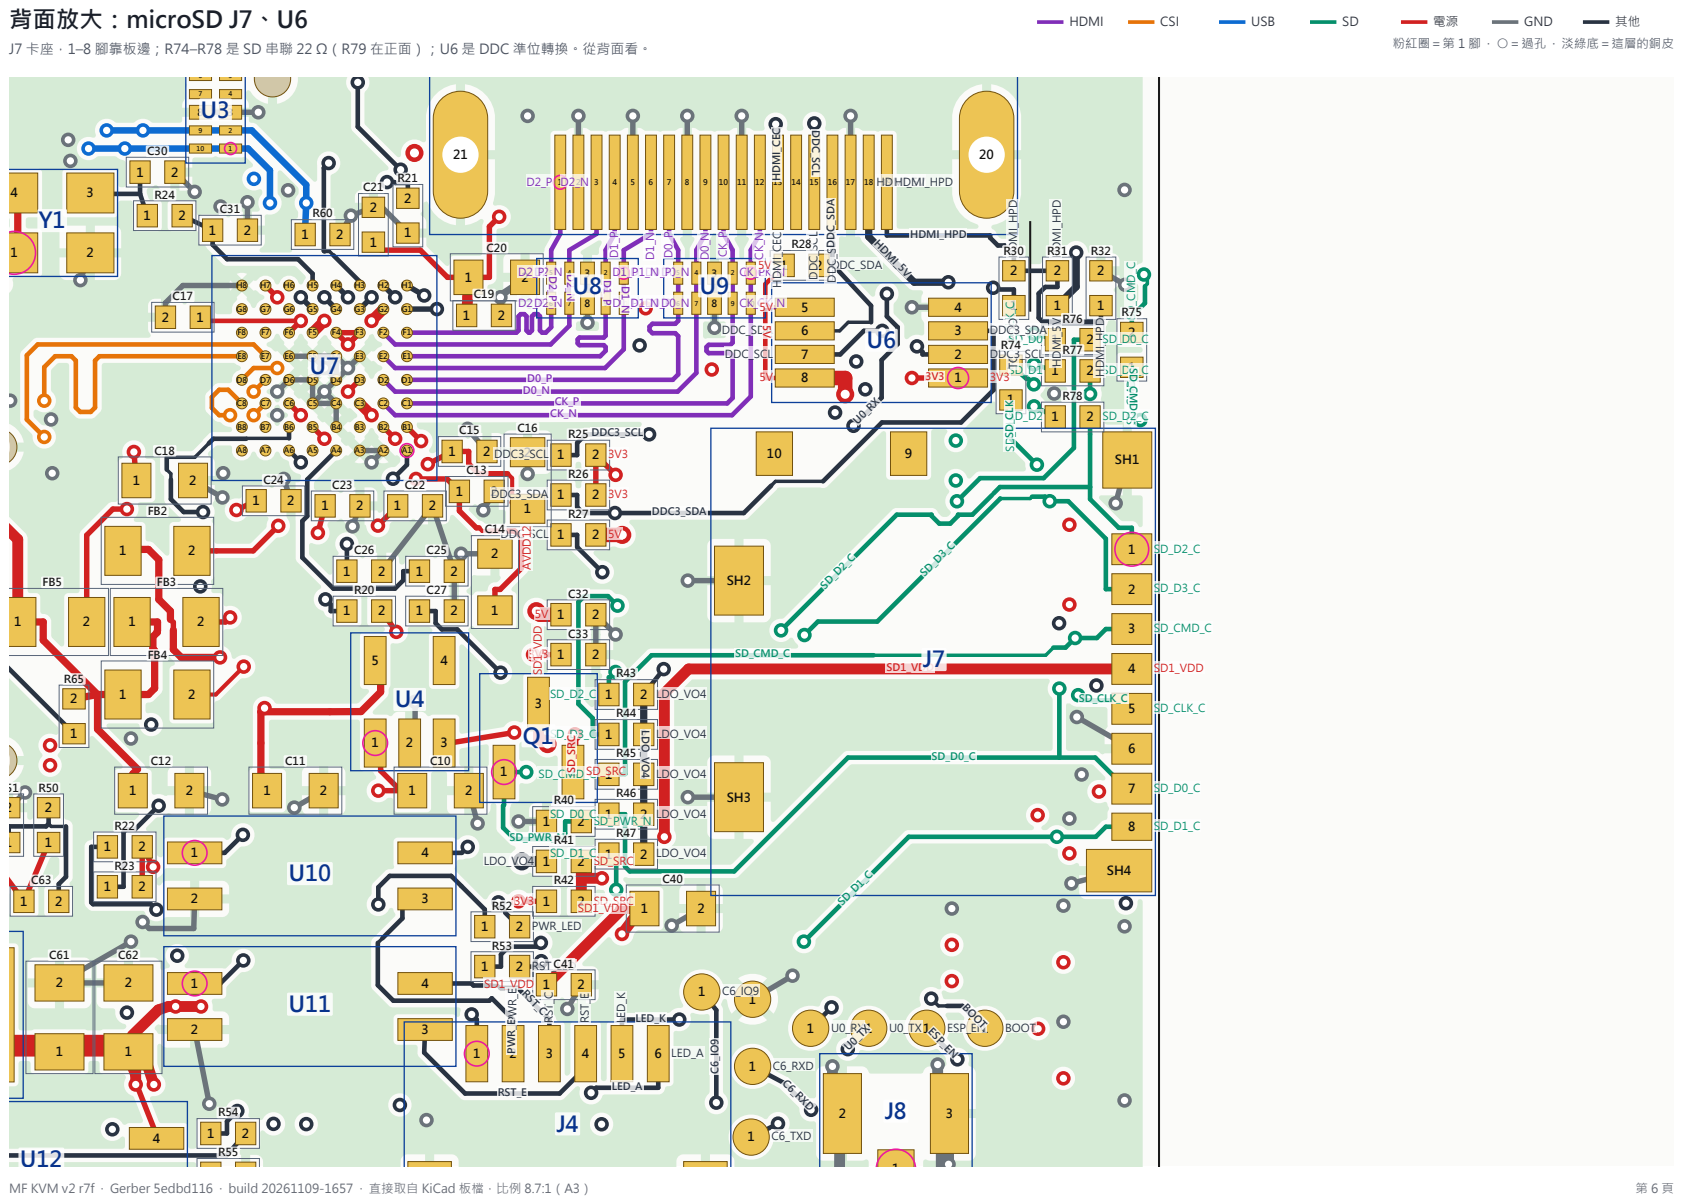
[picture p87: page 6]

J7 卡座，1–8 腳靠板邊；R74–R78 是 SD 串聯 22 Ω（R79 在正面）；U6 是 DDC 準位轉換。從背面看。

# 正面放大：J3、U14、CC 電阻

L2

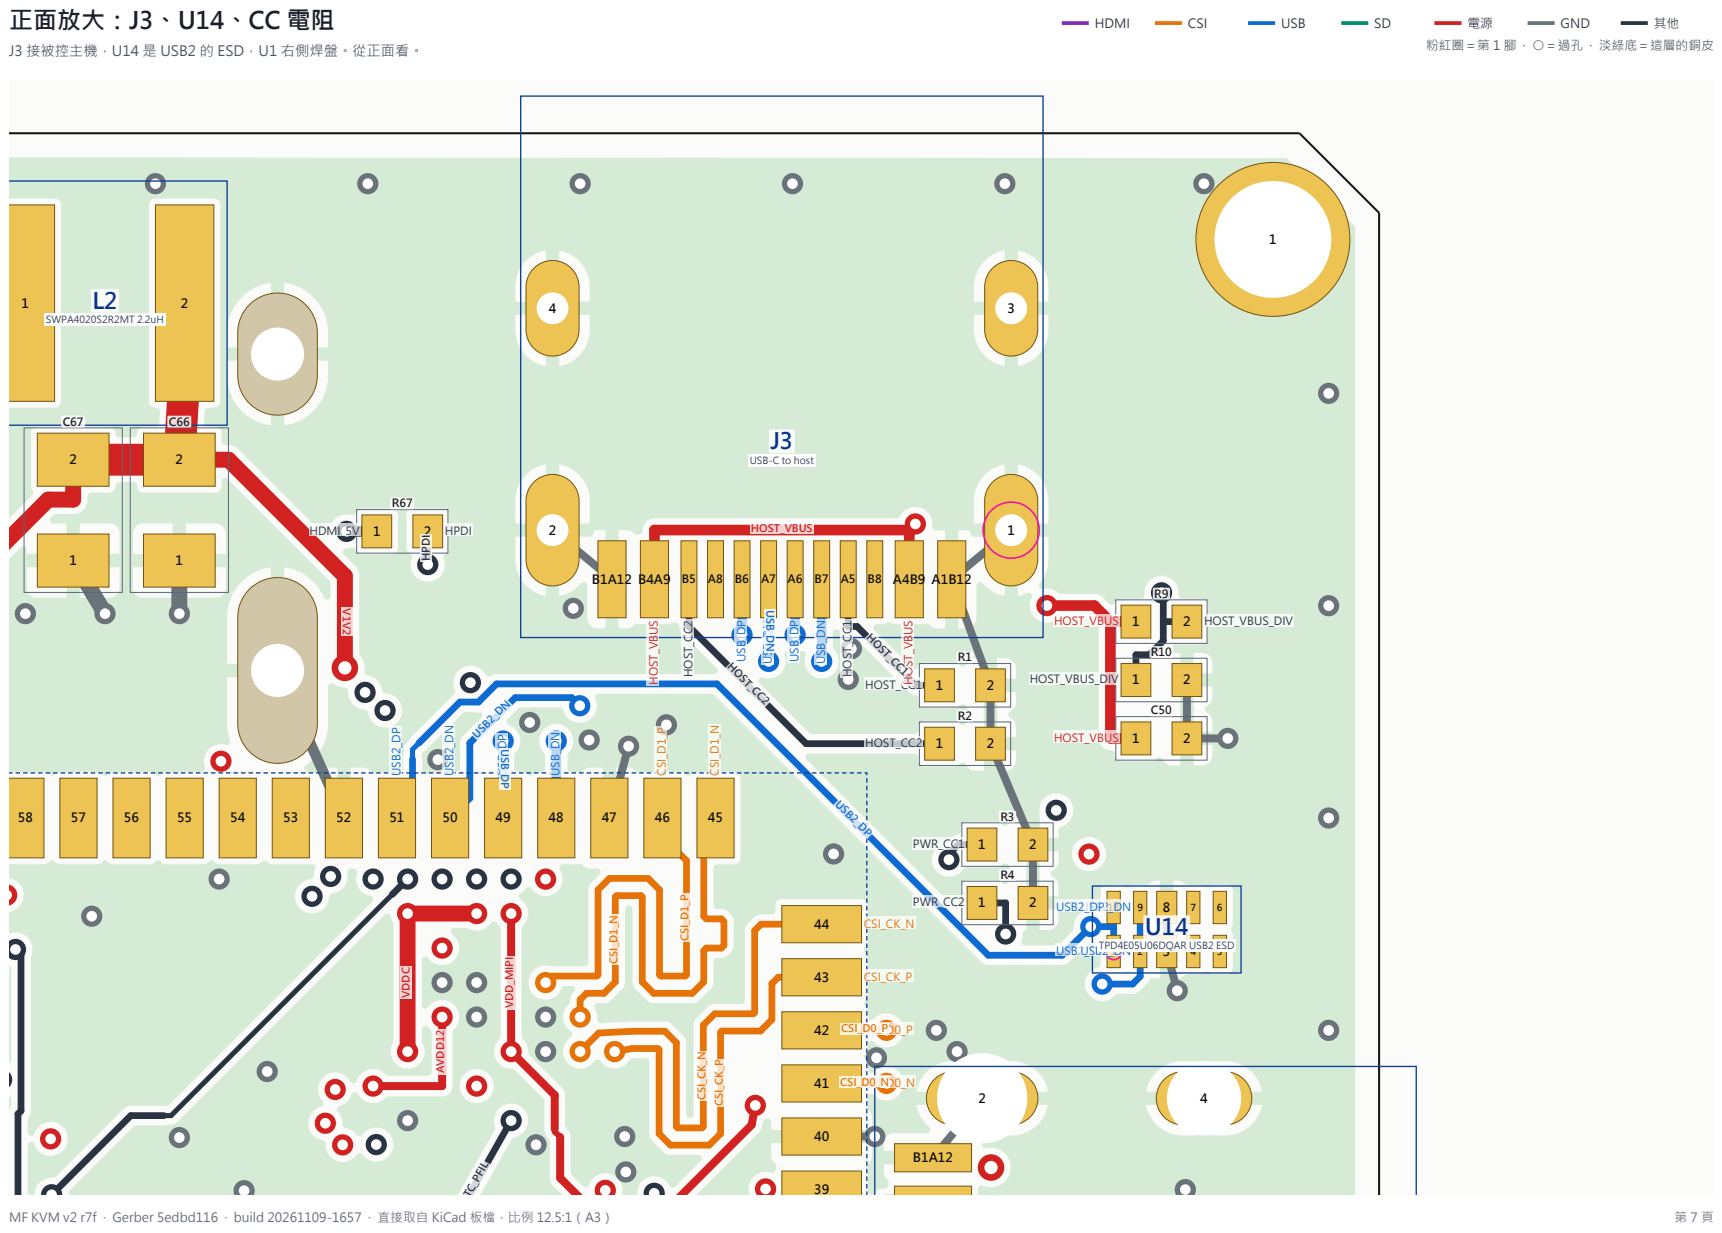
[picture p88: page 7]

J3 接被控主機，U14 是 USB2 的 ESD，U1 右側焊盤。從正面看。

# 正面放大：J5、J6

# ATX_RST AVDD¹²

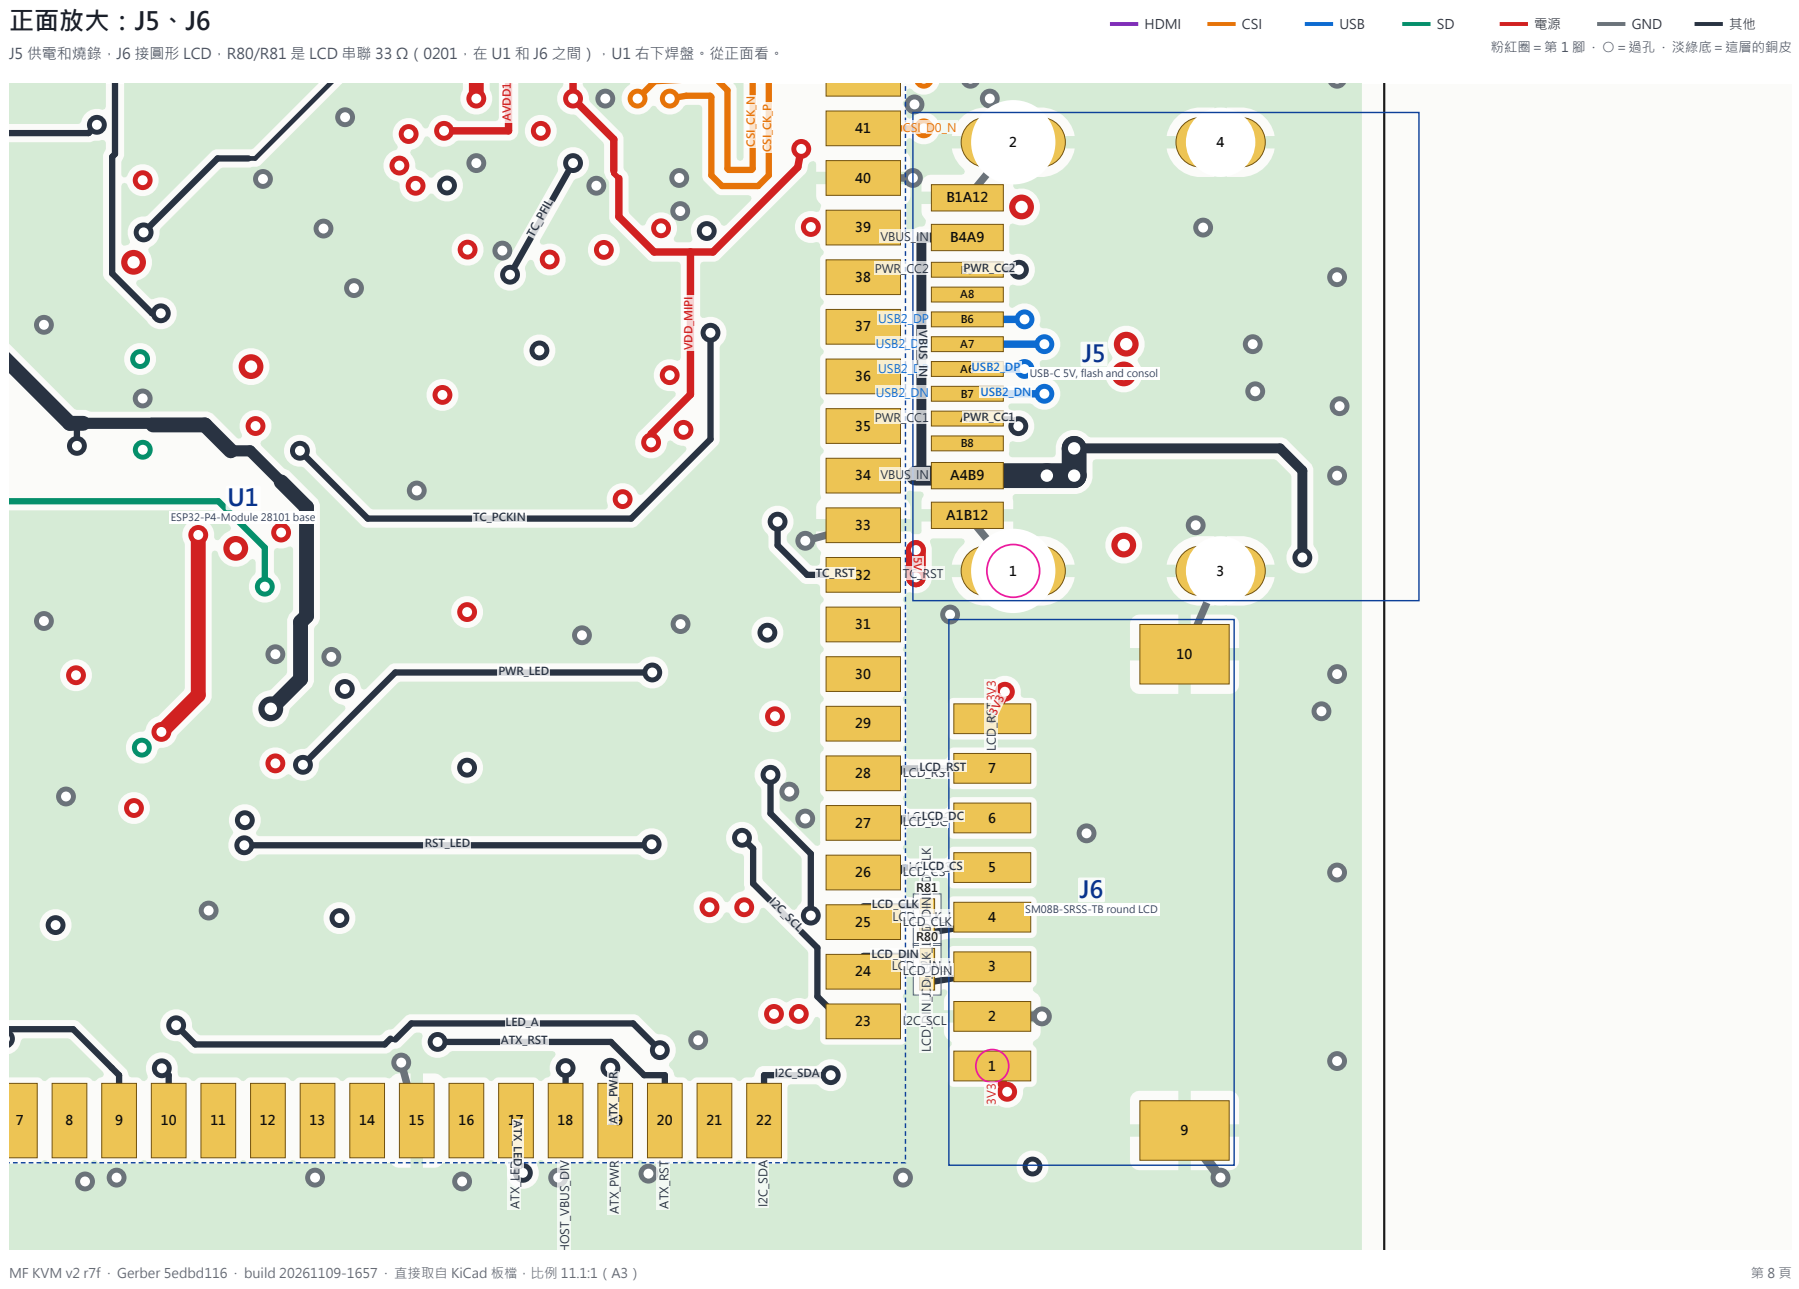
[picture p89: page 8]
MF KVM v2 r7f · Gerber 5edbd116 · build 20261109-1657 · 直接取自 KiCad 板檔，比例 11.1:1（A3）; VBUS_IN; PWR_CC1; USB2_DP; USB2_DN; PWR_CC2; LCD_DIN_J; LCD_CLK_J; LCD_CS; LCD_DC; LCD_RST3V3; LCD_CLK LCD_CLK_JLCD_DIN LCD_DIN_J; ATX_LED; HOST_VBUS_DIV; ATX_PWR; ATX_RST; I2C_SDA; I2C_SCL; LCD_DIN; LCD_CLK; LCD_RST; TC_RST; CSI_D0_N; CSI_CK_N; CSI_CK_P; LED_A; PWR_LED; RST_LED; TC_PCKIN; TC_PFIL; VDD_MIPI; TPD4E05U06DQAR USB2 ESD; ESP32-P4-Module 28101 base

J5 供電和燒錄，J6 接圓形 LCD，R80/R81 是 LCD 串聯 33 Ω（0201，在 U1 和 J6 之間），U1 右下焊盤。從正面看。

USB-C 5V, flash and consol

SM08B-SRSS-TB round LCD

# 正面放大：U1 左側與電容、電阻

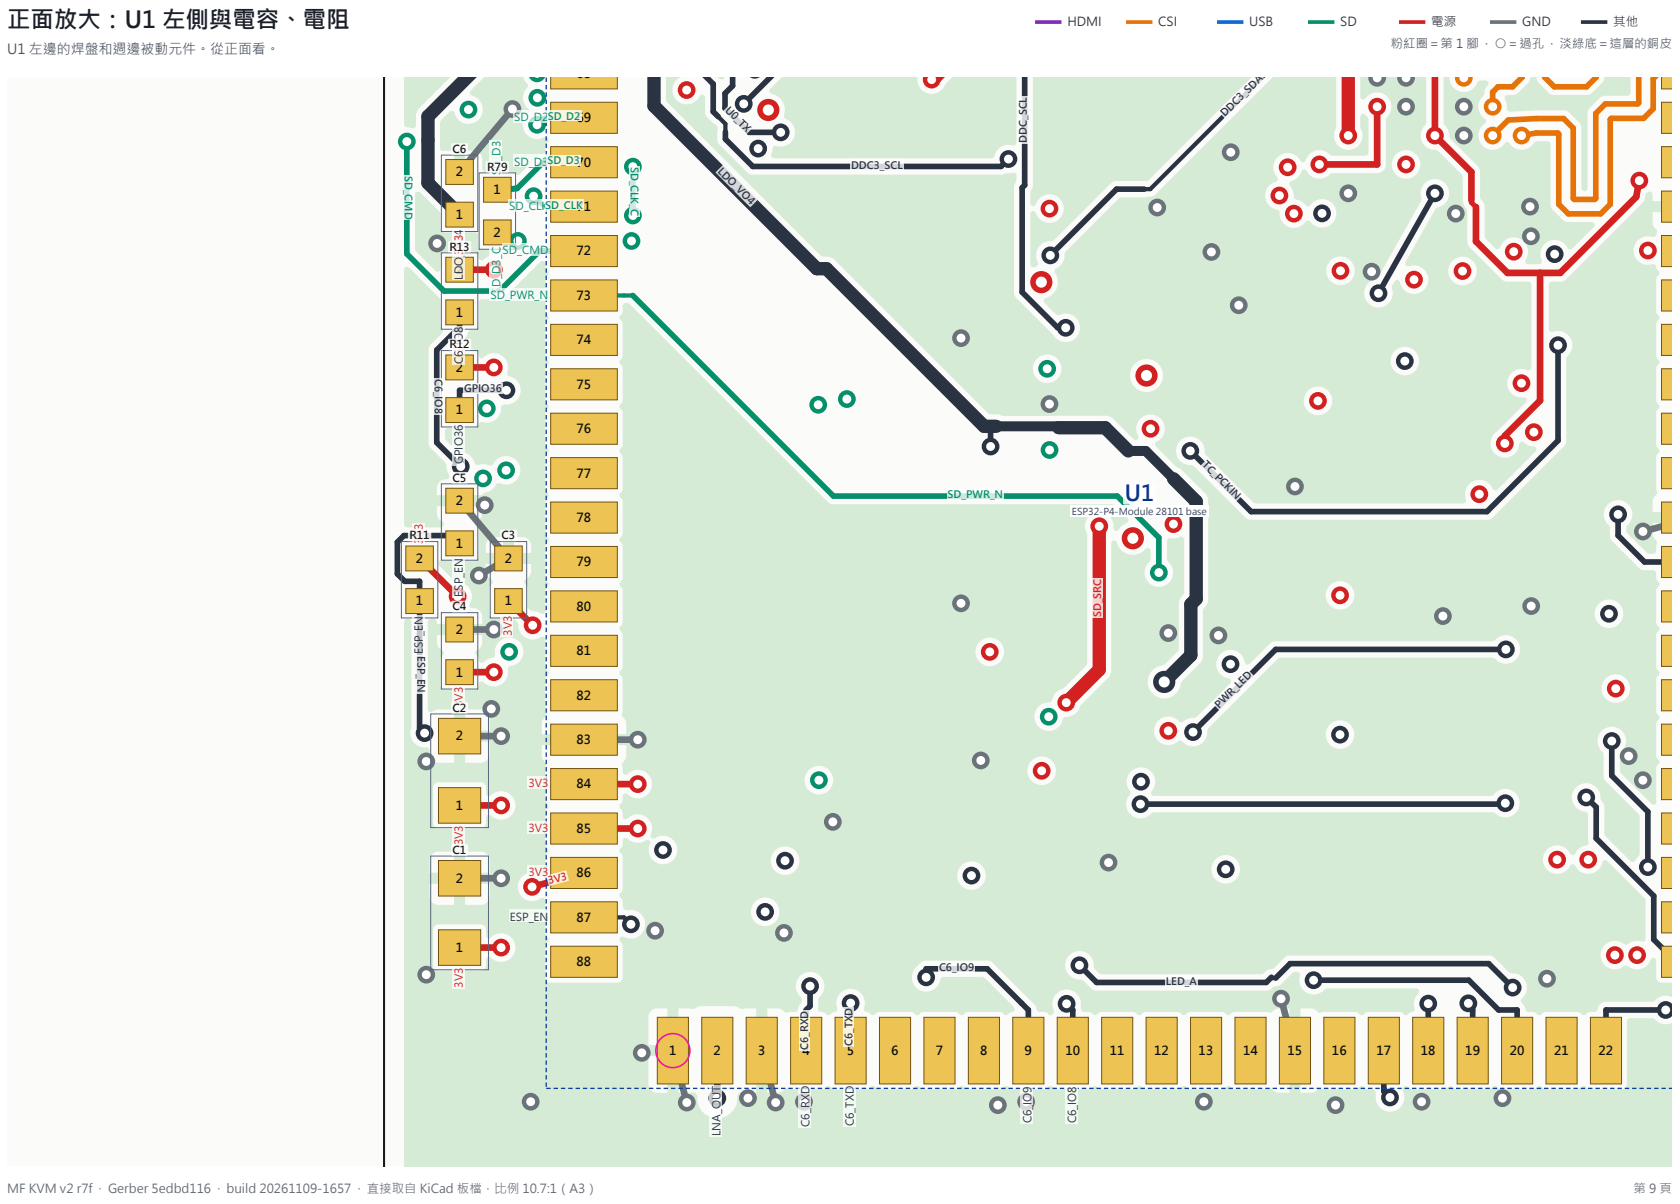
[picture p90: page 9]
