ooropuloo/MFKVM/lay-board/courtyard_review/tools/bot_plot.pdf

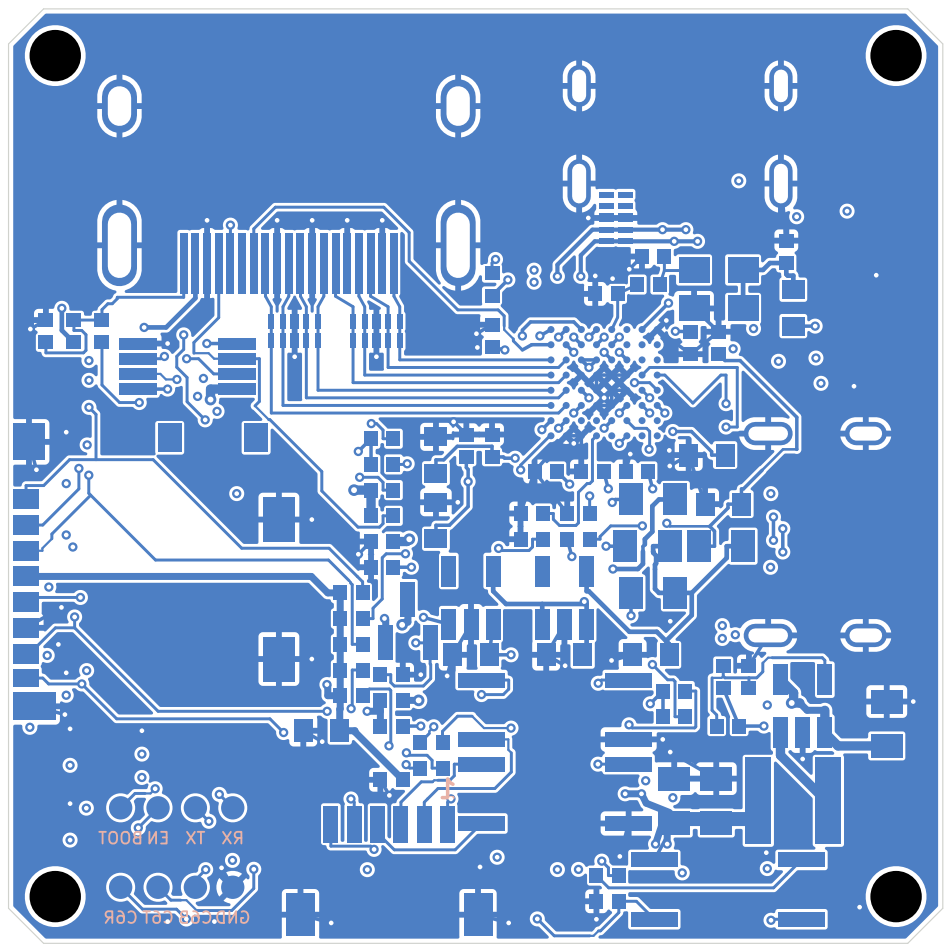
[picture p111: page 1]
