ooropuloo/MFKVM/(list of files, drawings)

Other design files:
lay-board/r7f/data/easyeda.json
lay-board/r7f/data/easyeda_r7c.json
