ooropuloo/MFKVM/lay-board/r7f/kicad/p4_kvm_mini.kicad_pcb

## KiCad design lay-board/r7f/kicad/p4_kvm_mini.kicad_pcb (2026-11-09)

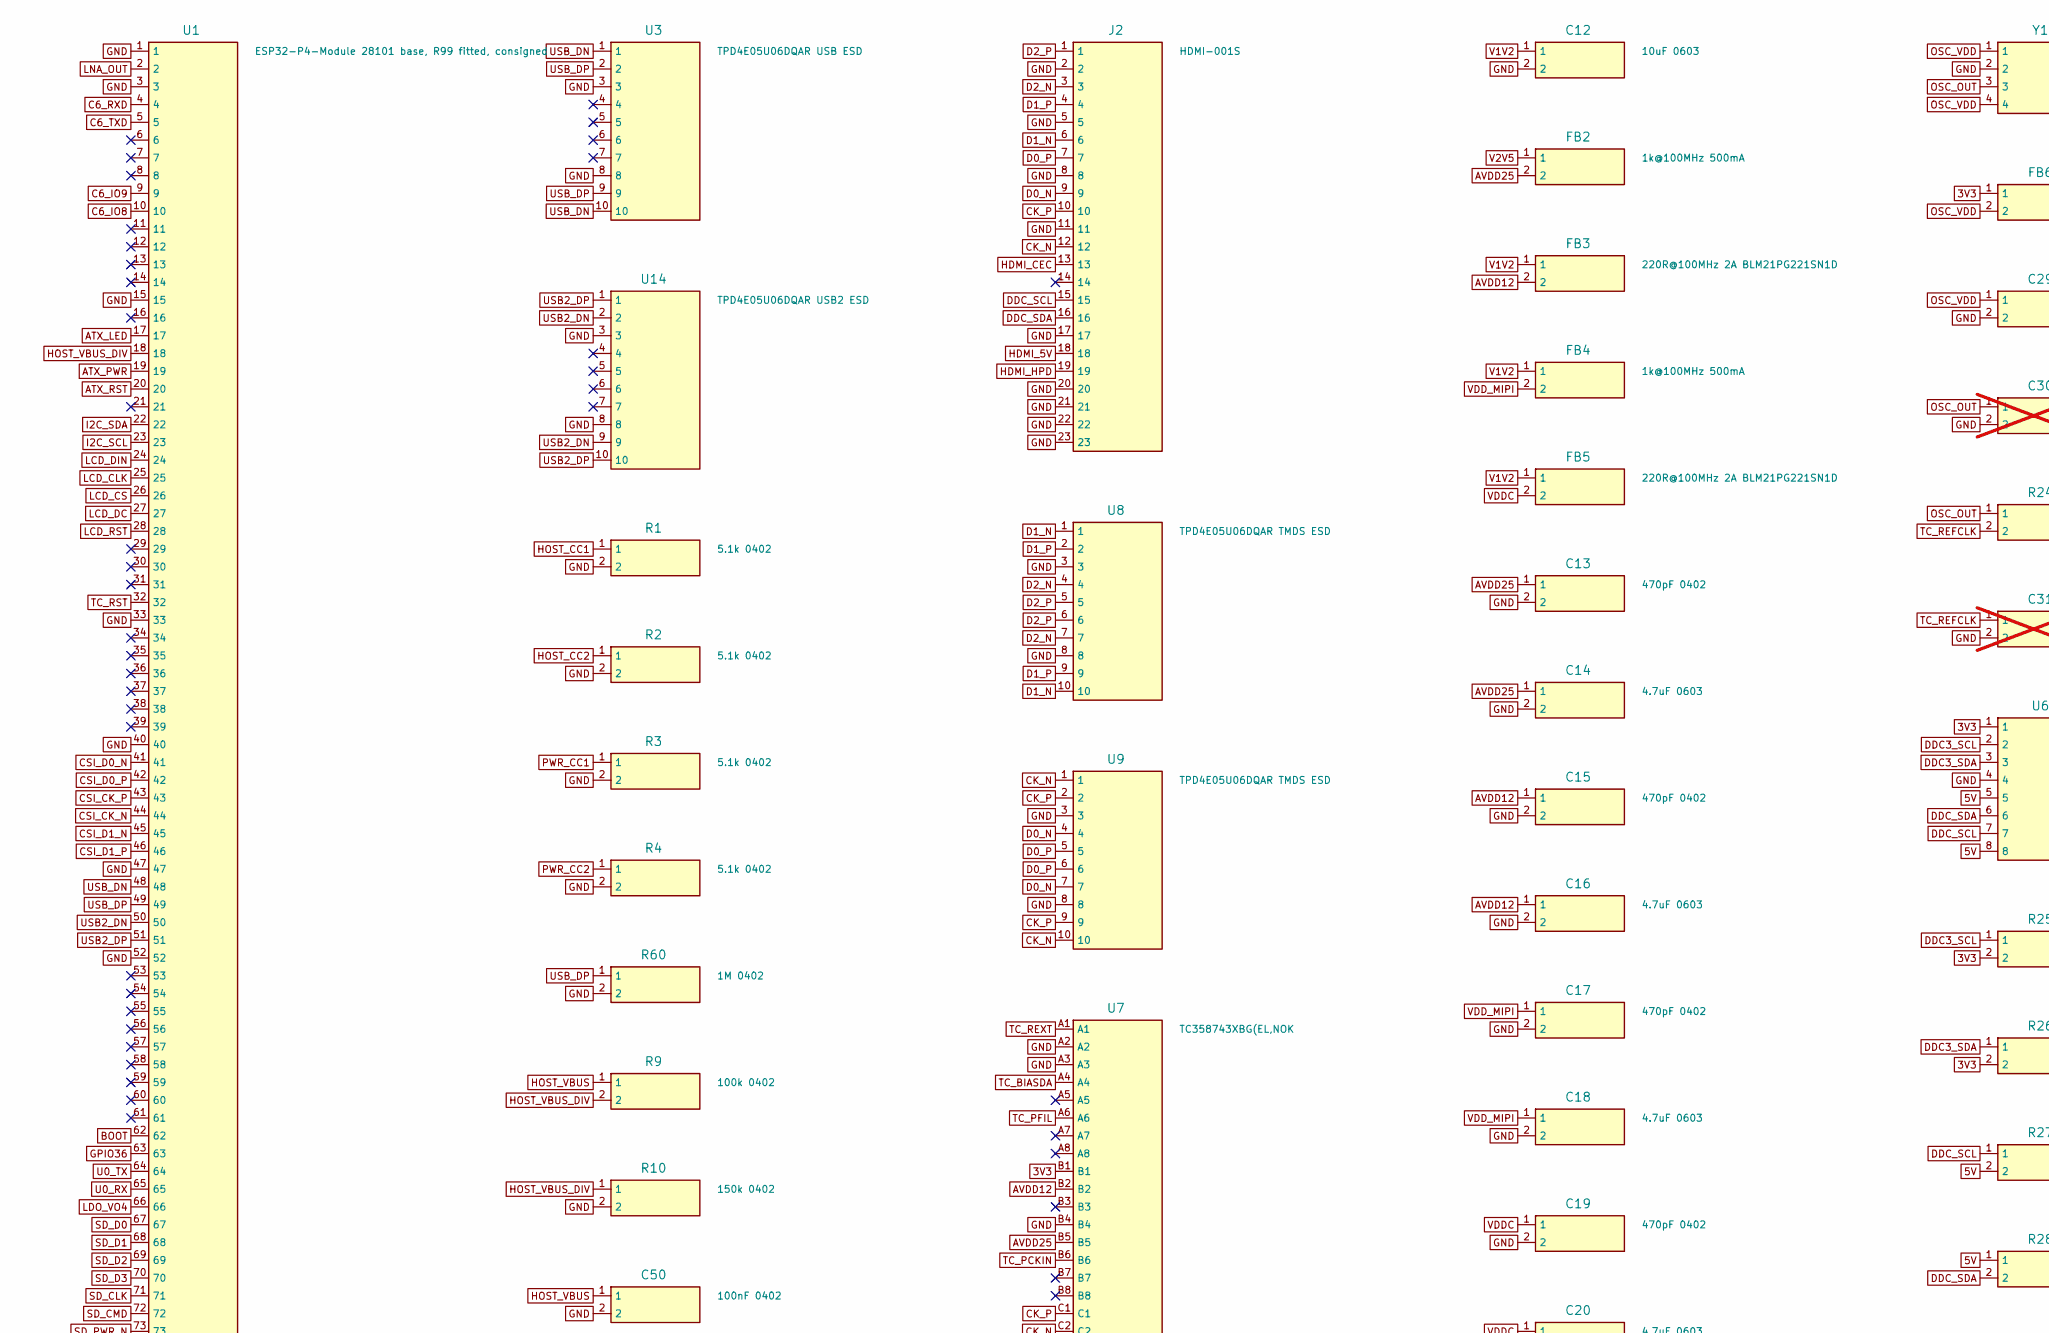
[picture p113: schematic p4_kvm_mini.kicad_sch, P4 KVM Mini, part in row 1, column 1]

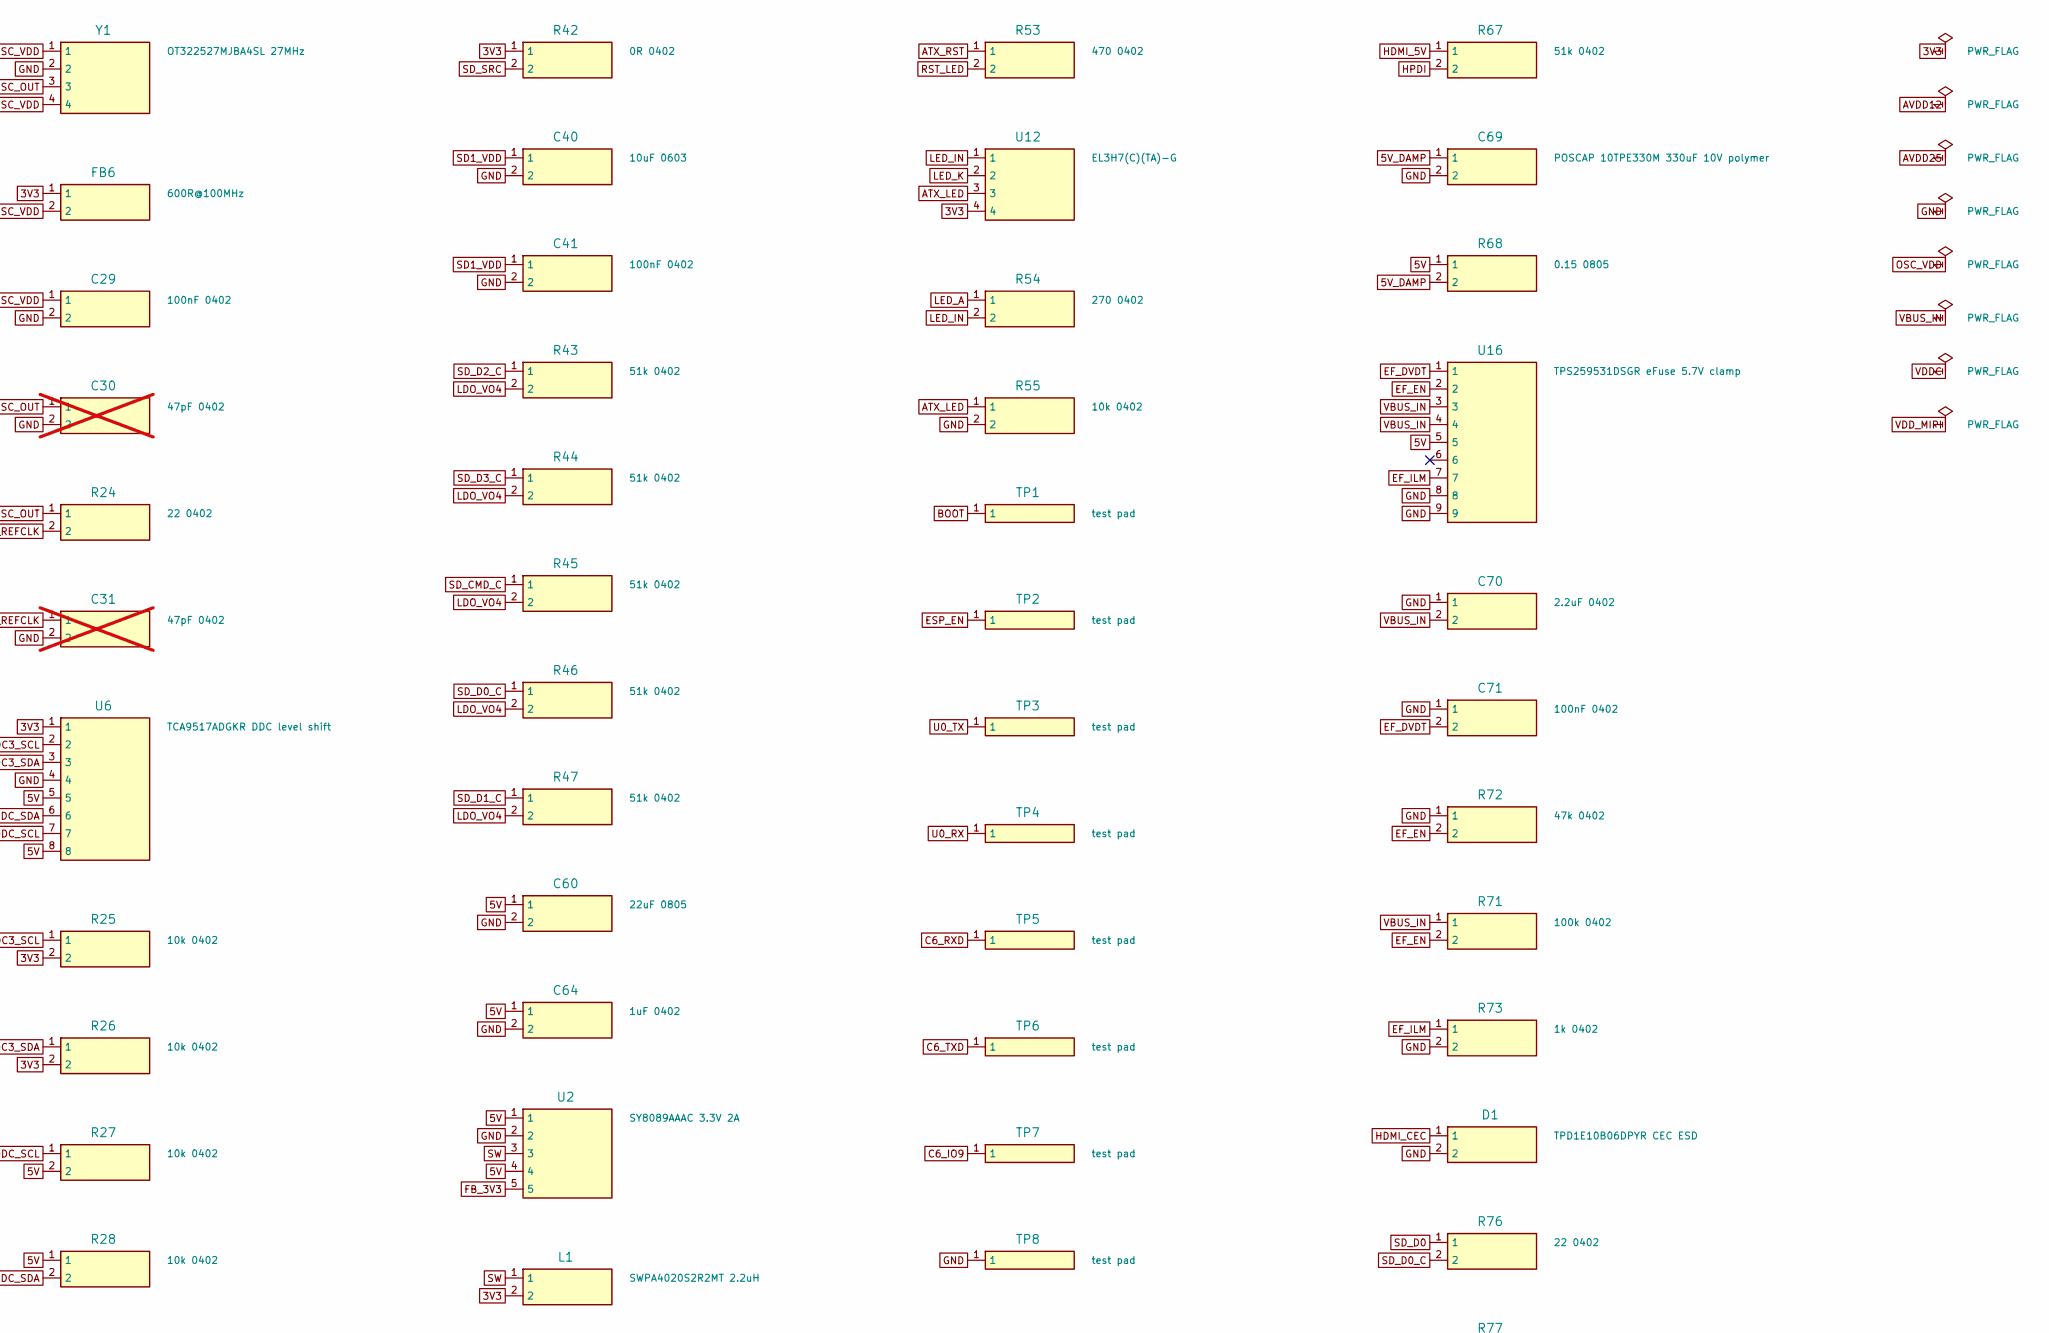
[picture p114: schematic p4_kvm_mini.kicad_sch, P4 KVM Mini, part in row 1, column 2]

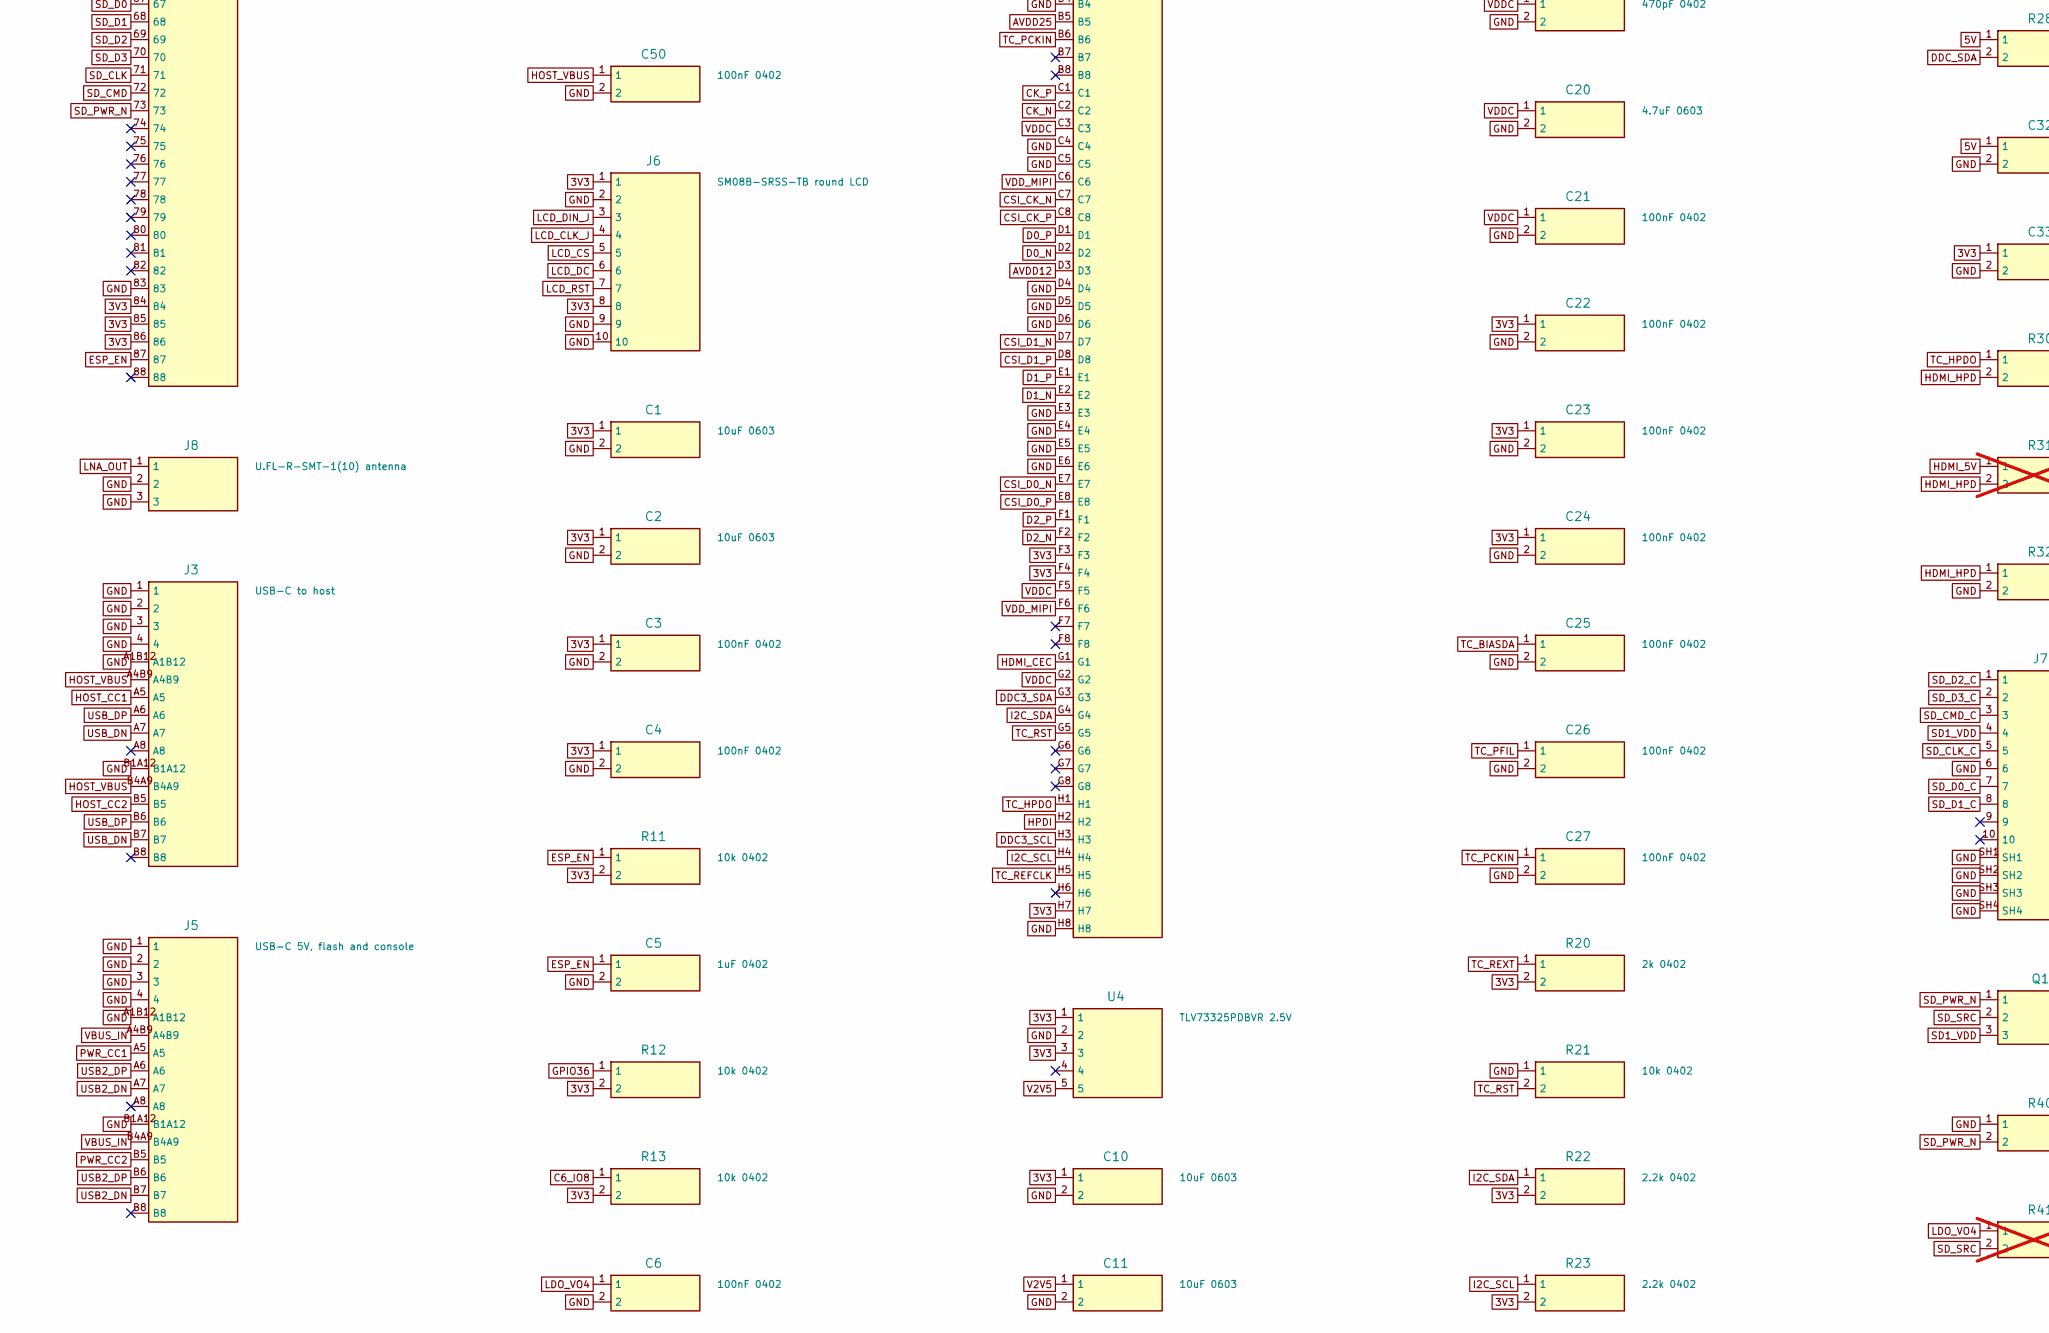
[picture p115: schematic p4_kvm_mini.kicad_sch, P4 KVM Mini, part in row 2, column 1]

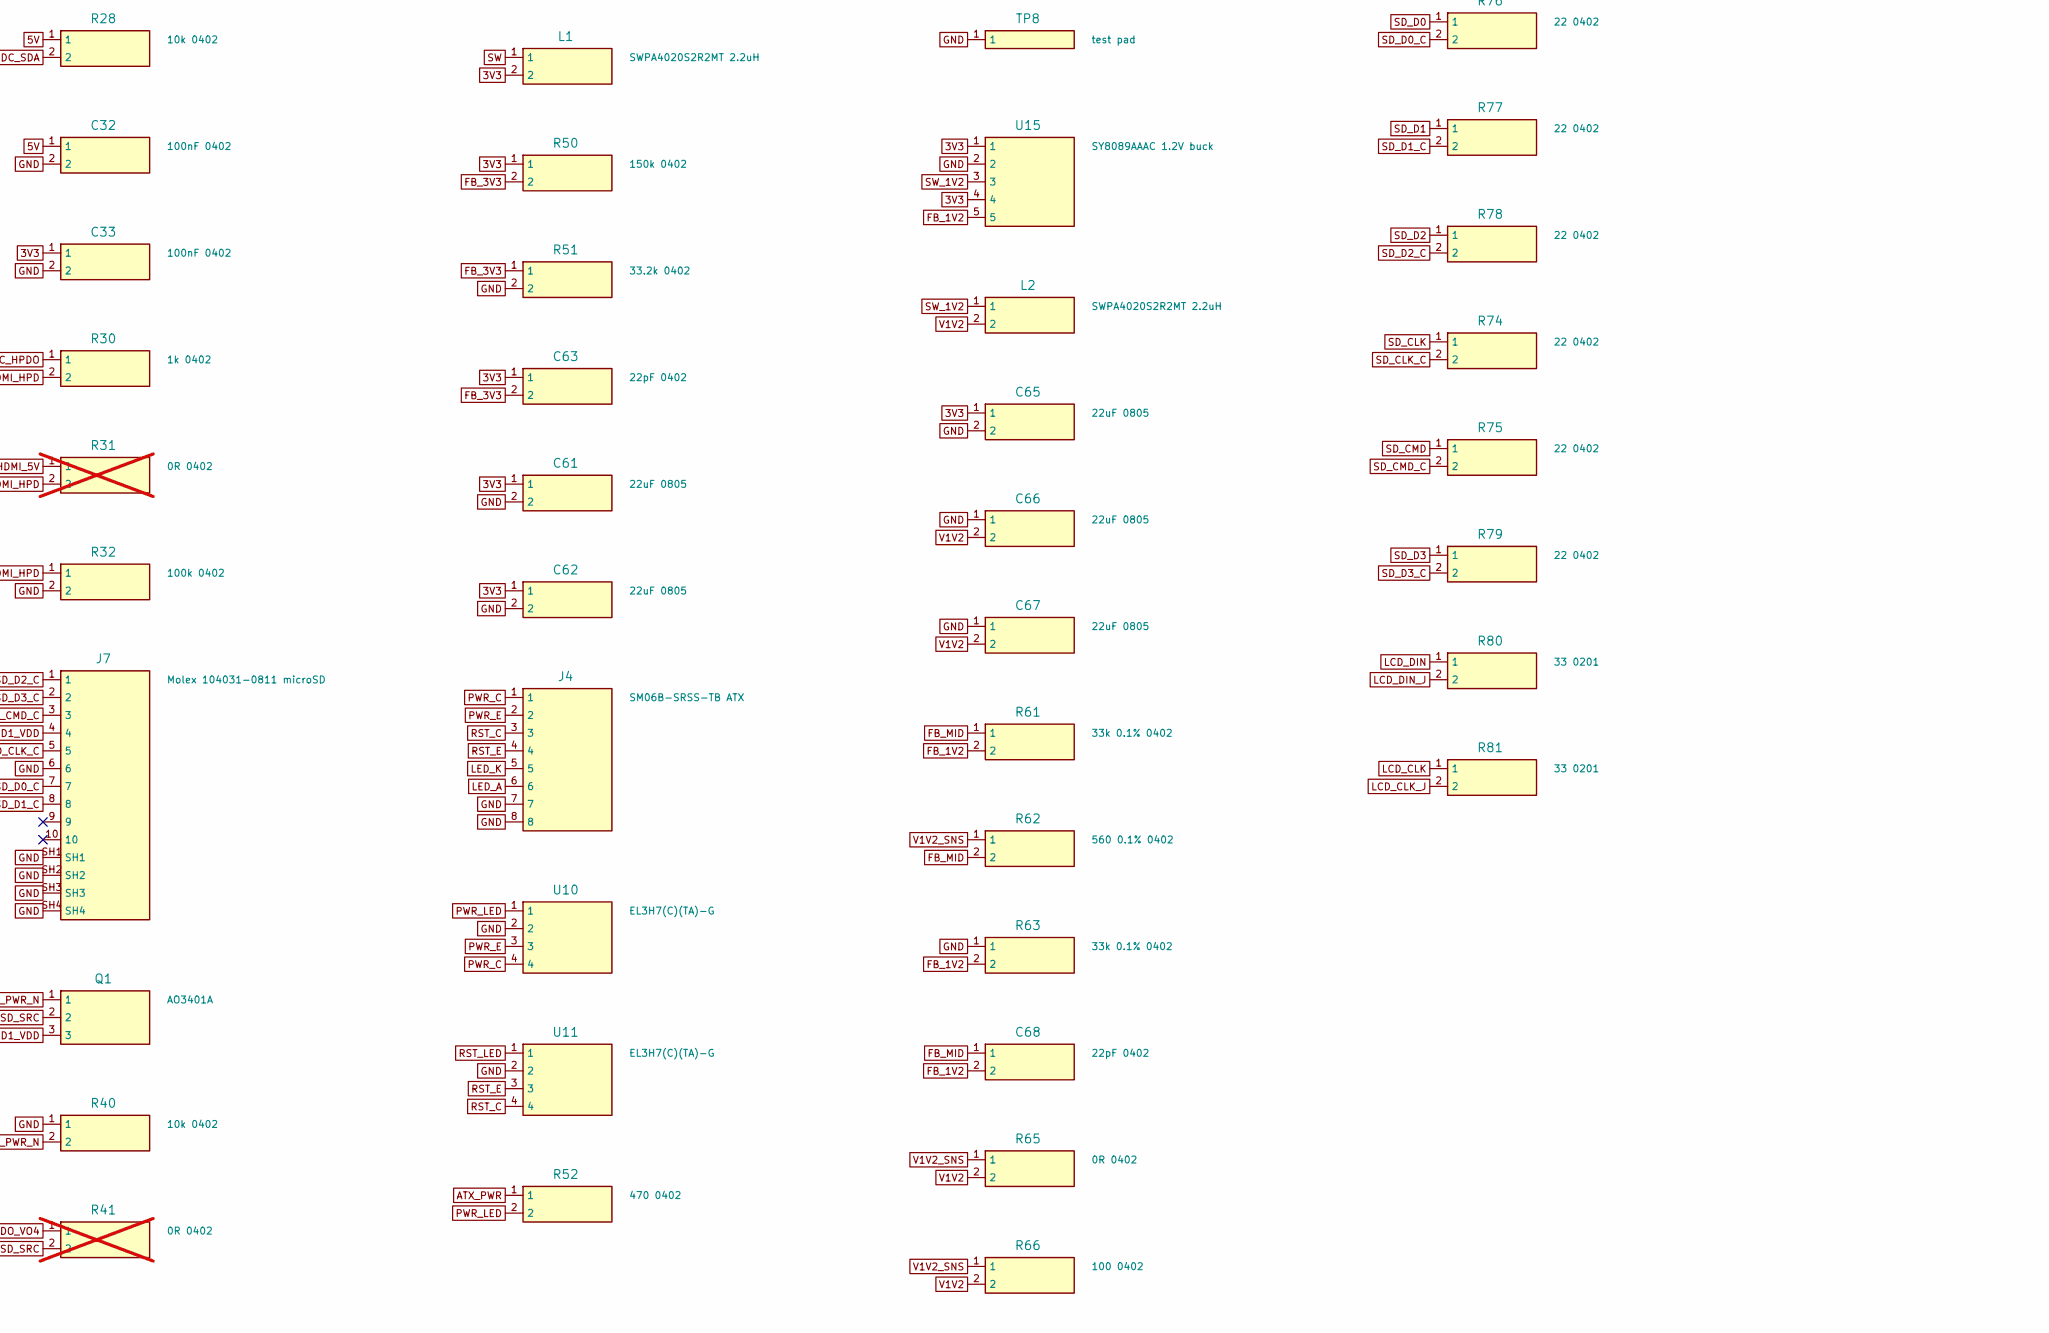
[picture p116: schematic p4_kvm_mini.kicad_sch, P4 KVM Mini, part in row 2, column 2]

Parts:
C1, C2, C10, C11, C12, C40: 10uF 0603; C0603; LCSC C19702
C3, C4, C6, C21, C22, C23, C24, C25, C26, C27, C29, C32, C33, C41, C50, C71: 100nF 0402; R0402; LCSC C1525
C5, C64: 1uF 0402; R0402; LCSC C52923
C13, C15, C17, C19: 470pF 0402; R0402; LCSC C1537
C14, C16, C18, C20: 4.7uF 0603; C0603; LCSC C19666
C30, C31: 47pF 0402; R0402; LCSC C1567; not fitted
C60, C61, C62, C65, C66, C67: 22uF 0805; C0805; LCSC C45783
C63, C68: 22pF 0402; R0402; LCSC C1555
C69: POSCAP 10TPE330M 330uF 10V polymer; CP_7343; LCSC C347552
C70: 2.2uF 0402; R0402; LCSC C385032
D1: TPD1E10B06DPYR CEC ESD; X1SON-2_0.6x1; LCSC C48260
FB2, FB4: 1k@100MHz 500mA; C0805; LCSC C98485
FB3, FB5: 220R@100MHz 2A BLM21PG221SN1D; C0805; LCSC C85840
FB6: 600R@100MHz; C0603; LCSC C19330
J2: HDMI-001S; LCSC C720616
J3: USB-C to host; USB-C_HX_16P; LCSC C41427493
J4: SM06B-SRSS-TB ATX; JST_SM06B; LCSC C160405
J5: USB-C 5V, flash and console; USB-C_HX_16P; LCSC C41427493
J6: SM08B-SRSS-TB round LCD; JST_SM08B; LCSC C160407
J7: Molex 104031-0811 microSD; microSD_Molex_104031-0811; LCSC C585350
J8: U.FL-R-SMT-1(10) antenna; U.FL-R-SMT-1; LCSC C88373
L1, L2: SWPA4020S2R2MT 2.2uH; IND4020; LCSC C83423
Q1: AO3401A; SOT-23; LCSC C15127
R1, R2, R3, R4: 5.1k 0402; R0402; LCSC C25905
R9, R32, R71: 100k 0402; R0402; LCSC C25741
R10, R50: 150k 0402; R0402; LCSC C25755
R11, R12, R13, R21, R25, R26, R27, R28, R40, R55: 10k 0402; R0402; LCSC C25744
R20: 2k 0402; R0402; LCSC C4109
R22, R23: 2.2k 0402; R0402; LCSC C25879
R24, R74, R75, R76, R77, R78, R79: 22 0402; R0402; LCSC C25092
R30, R73: 1k 0402; R0402; LCSC C11702
R31, R41: 0R 0402; R0402; LCSC C17168; not fitted
R42, R65: 0R 0402; R0402; LCSC C17168
R43, R44, R45, R46, R47, R67: 51k 0402; R0402; LCSC C25794
R51: 33.2k 0402; R0402; LCSC C122548
R52, R53: 470 0402; R0402; LCSC C25117
R54: 270 0402; R0402; LCSC C25099
R60: 1M 0402; R0402; LCSC C26083
R61, R63: 33k 0.1% 0402; R0402; LCSC C728559
R62: 560 0.1% 0402; R0402; LCSC C319512
R66: 100 0402; R0402; LCSC C25076
R68: 0.15 0805; C0805; LCSC C247444
R72: 47k 0402; R0402; LCSC C25792
R80, R81: 33 0201; R0201; LCSC C320843
TP1, TP2, TP3, TP4, TP5, TP6, TP7, TP8: test pad; TP_1.0
U1: ESP32-P4-Module 28101 base, R99 fitted, consigned; ESP32-P4-Module
U2: SY8089AAAC 3.3V 2A; SOT-23-5; LCSC C78988
U3: TPD4E05U06DQAR USB ESD; USON-10; LCSC C138714
U4: TLV73325PDBVR 2.5V; SOT-23-5; LCSC C882825
U6: TCA9517ADGKR DDC level shift; MSOP-8; LCSC C201698
U7: TC358743XBG(EL,NOK; BGA-64_6x6; LCSC C3008606
U8, U9: TPD4E05U06DQAR TMDS ESD; USON-10; LCSC C138714
U10, U11, U12: EL3H7(C)(TA)-G; SSOP-4_1.27; LCSC C92243
U14: TPD4E05U06DQAR USB2 ESD; USON-10; LCSC C138714
U15: SY8089AAAC 1.2V buck; SOT-23-5; LCSC C78988
U16: TPS259531DSGR eFuse 5.7V clamp; WSON-8_2x2_EP; LCSC C2155674
Y1: OT322527MJBA4SL 27MHz; OSC3225; LCSC C725995

Connections:
3V3: C1.1, C2.1, C3.1, C4.1, C10.1, C22.1, C23.1, C24.1, C33.1, C61.1, C62.1, C63.1, C65.1, FB6.1, J6.1, J6.8, L1.2, R11.2, R12.2, R13.2, R20.2, R22.2, R23.2, R25.2, R26.2, R42.1, R50.1, U1.84, U1.85, U1.86, U4.1, U4.3, U6.1, U7.B1, U7.F3, U7.F4, U7.H7, U12.4, U15.1, U15.4
5V: C32.1, C60.1, C64.1, R27.2, R28.1, R68.1, U2.1, U2.4, U6.5, U6.8, U16.5
5V_DAMP: C69.1, R68.2
ATX_LED: R55.1, U1.17, U12.3
ATX_PWR: R52.1, U1.19
ATX_RST: R53.1, U1.20
AVDD12: C15.1, C16.1, FB3.2, U7.B2, U7.D3
AVDD25: C13.1, C14.1, FB2.2, U7.B5
BOOT: TP1.1, U1.62
C6_IO8: R13.1, U1.10
C6_IO9: TP7.1, U1.9
C6_RXD: TP5.1, U1.4
C6_TXD: TP6.1, U1.5
CK_N: J2.12, U7.C2, U9.1, U9.10
CK_P: J2.10, U7.C1, U9.2, U9.9
CSI_CK_N: U1.44, U7.C7
CSI_CK_P: U1.43, U7.C8
CSI_D0_N: U1.41, U7.E7
CSI_D0_P: U1.42, U7.E8
CSI_D1_N: U1.45, U7.D7
CSI_D1_P: U1.46, U7.D8
D0_N: J2.9, U7.D2, U9.4, U9.7
D0_P: J2.7, U7.D1, U9.5, U9.6
D1_N: J2.6, U7.E2, U8.1, U8.10
D1_P: J2.4, U7.E1, U8.2, U8.9
D2_N: J2.3, U7.F2, U8.4, U8.7
D2_P: J2.1, U7.F1, U8.5, U8.6
DDC3_SCL: R25.1, U6.2, U7.H3
DDC3_SDA: R26.1, U6.3, U7.G3
DDC_SCL: J2.15, R27.1, U6.7
DDC_SDA: J2.16, R28.2, U6.6
EF_DVDT: C71.2, U16.1
EF_EN: R71.2, R72.2, U16.2
EF_ILM: R73.1, U16.7
ESP_EN: C5.1, R11.1, TP2.1, U1.87
FB_1V2: C68.2, R61.2, R63.2, U15.5
FB_3V3: C63.2, R50.2, R51.1, U2.5
FB_MID: C68.1, R61.1, R62.2
GND: C1.2, C2.2, C3.2, C4.2, C5.2, C6.2, C10.2, C11.2, C12.2, C13.2, C14.2, C15.2, C16.2, C17.2, C18.2, C19.2, C20.2, C21.2, C22.2, C23.2, C24.2, C25.2, C26.2, C27.2, C29.2, C30.2, C31.2, C32.2, C33.2, C40.2, C41.2, C50.2, C60.2, C61.2, C62.2, C64.2, C65.2, C66.1, C67.1, C69.2, C70.1, C71.1, D1.2, J2.2, J2.5, J2.8, J2.11, J2.17, J2.20, J2.21, J2.22, J2.23, J3.1, J3.2, J3.3, J3.4, J3.A1B12, J3.B1A12, J4.7, J4.8, J5.1, J5.2, J5.3, J5.4, J5.A1B12, J5.B1A12, J6.2, J6.9, J6.10, J7.6, J7.SH1, J7.SH2, J7.SH3, J7.SH4, J8.2, J8.3, R1.2, R2.2, R3.2, R4.2, R10.2, R21.1, R32.2, R40.1, R51.2, R55.2, R60.2, R63.1, R72.1, R73.2, TP8.1, U1.1, U1.3, U1.15, U1.33, U1.40, U1.47, U1.52, U1.83, U2.2, U3.3, U3.8, U4.2, U6.4, U7.A2, U7.A3, U7.B4, U7.C4, U7.C5, U7.D4, U7.D5, U7.D6, U7.E3, U7.E4, U7.E5, U7.E6, U7.H8, U8.3, U8.8, U9.3, U9.8, U10.2, U11.2, U14.3, U14.8, U15.2, U16.8, U16.9, Y1.2; also elsewhere on the board
GPIO36: R12.1, U1.63
HDMI_5V: J2.18, R31.1, R67.1
HDMI_CEC: D1.1, J2.13, U7.G1
HDMI_HPD: J2.19, R30.2, R31.2, R32.1
HOST_CC1: J3.A5, R1.1
HOST_CC2: J3.B5, R2.1
HOST_VBUS: C50.1, J3.A4B9, J3.B4A9, R9.1
HOST_VBUS_DIV: R9.2, R10.1, U1.18
HPDI: R67.2, U7.H2
I2C_SCL: R23.1, U1.23, U7.H4
I2C_SDA: R22.1, U1.22, U7.G4
LCD_CLK: R81.1, U1.25
LCD_CLK_J: J6.4, R81.2
LCD_CS: J6.5, U1.26
LCD_DC: J6.6, U1.27
LCD_DIN: R80.1, U1.24
LCD_DIN_J: J6.3, R80.2
LCD_RST: J6.7, U1.28
LDO_VO4: C6.1, R41.1, R43.2, R44.2, R45.2, R46.2, R47.2, U1.66
LED_A: J4.6, R54.1
LED_IN: R54.2, U12.1
LED_K: J4.5, U12.2
LNA_OUT: J8.1, U1.2
OSC_OUT: C30.1, R24.1, Y1.3
OSC_VDD: C29.1, FB6.2, Y1.1, Y1.4
PWR_C: J4.1, U10.4
PWR_CC1: J5.A5, R3.1
PWR_CC2: J5.B5, R4.1
PWR_E: J4.2, U10.3
PWR_LED: R52.2, U10.1
RST_C: J4.3, U11.4
RST_E: J4.4, U11.3
RST_LED: R53.2, U11.1
SD1_VDD: C40.1, C41.1, J7.4, Q1.3
SD_CLK: R74.1, U1.71
SD_CLK_C: J7.5, R74.2
SD_CMD: R75.1, U1.72
SD_CMD_C: J7.3, R45.1, R75.2
SD_D0: R76.1, U1.67
SD_D0_C: J7.7, R46.1, R76.2
SD_D1: R77.1, U1.68
SD_D1_C: J7.8, R47.1, R77.2
SD_D2: R78.1, U1.69
SD_D2_C: J7.1, R43.1, R78.2
SD_D3: R79.1, U1.70
SD_D3_C: J7.2, R44.1, R79.2
SD_PWR_N: Q1.1, R40.2, U1.73
SD_SRC: Q1.2, R41.2, R42.2
SW: L1.1, U2.3
SW_1V2: L2.1, U15.3
TC_BIASDA: C25.1, U7.A4
TC_HPDO: R30.1, U7.H1
TC_PCKIN: C27.1, U7.B6
TC_PFIL: C26.1, U7.A6
TC_REFCLK: C31.1, R24.2, U7.H5
TC_REXT: R20.1, U7.A1
TC_RST: R21.2, U1.32, U7.G5
U0_RX: TP4.1, U1.65
U0_TX: TP3.1, U1.64
USB2_DN: J5.A7, J5.B7, U1.50, U14.2, U14.9
USB2_DP: J5.A6, J5.B6, U1.51, U14.1, U14.10
USB_DN: J3.A7, J3.B7, U1.48, U3.1, U3.10
USB_DP: J3.A6, J3.B6, R60.1, U1.49, U3.2, U3.9
V1V2: C12.1, C66.2, C67.2, FB3.1, FB4.1, FB5.1, L2.2, R65.2, R66.2
V1V2_SNS: R62.1, R65.1, R66.1
V2V5: C11.1, FB2.1, U4.5
VBUS_IN: C70.2, J5.A4B9, J5.B4A9, R71.1, U16.3, U16.4
VDDC: C19.1, C20.1, C21.1, FB5.2, U7.C3, U7.F5, U7.G2
VDD_MIPI: C17.1, C18.1, FB4.2, U7.C6, U7.F6

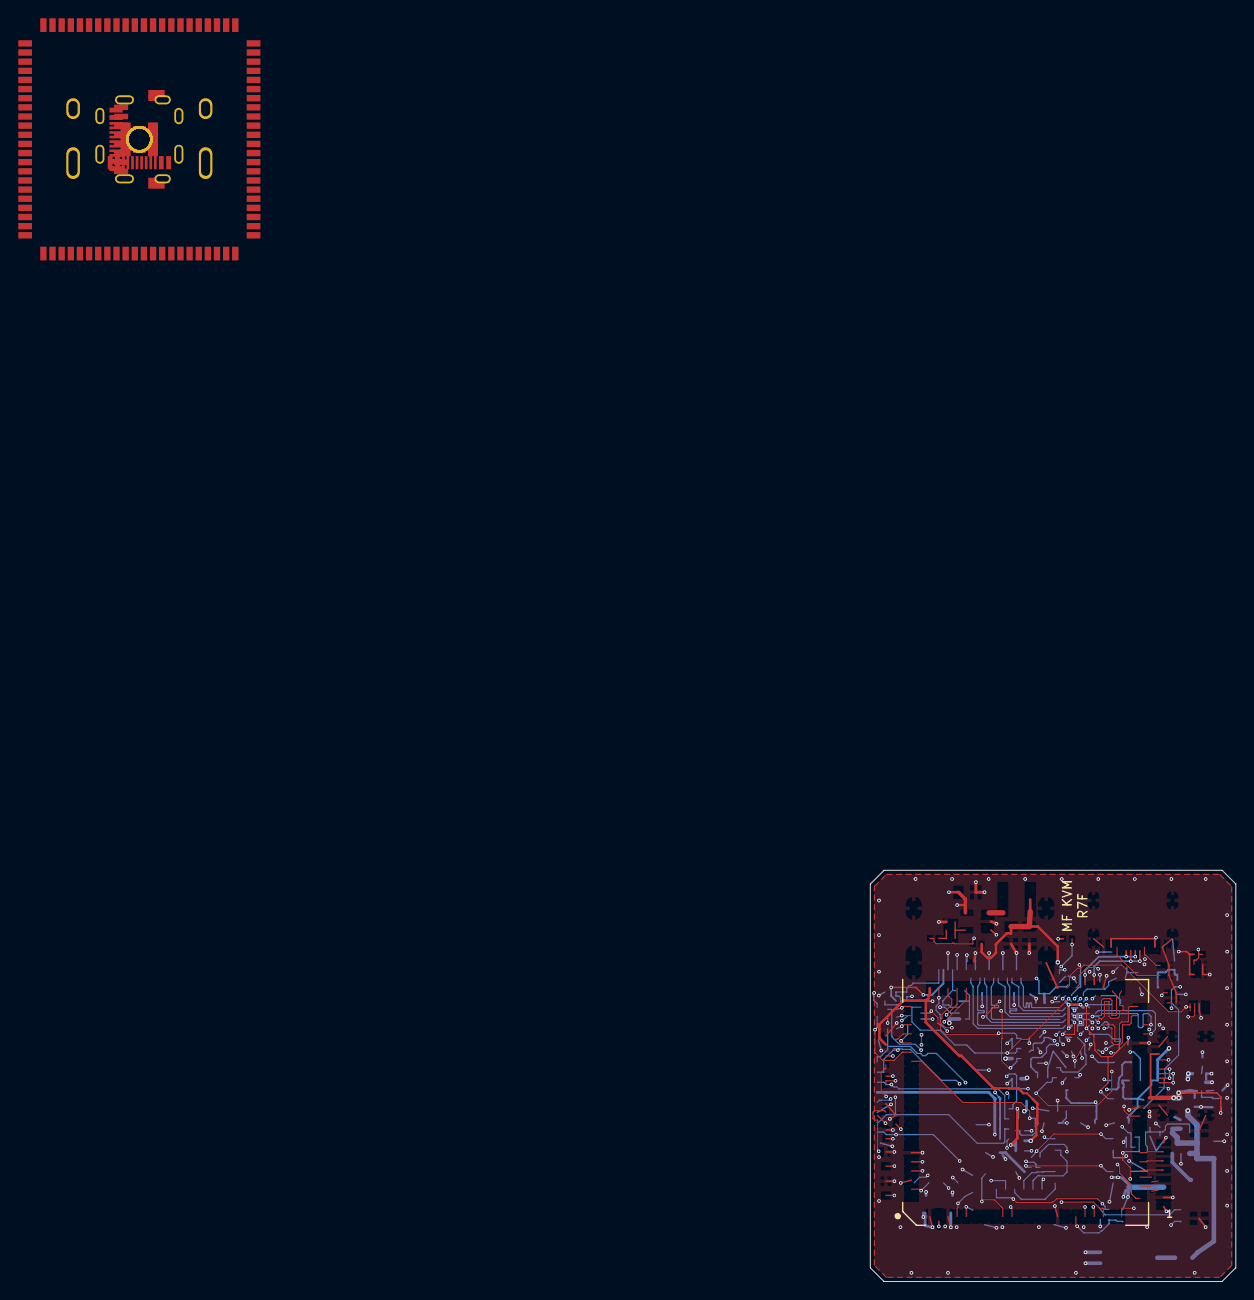
[picture p117: board p4_kvm_mini.kicad_pcb from above]

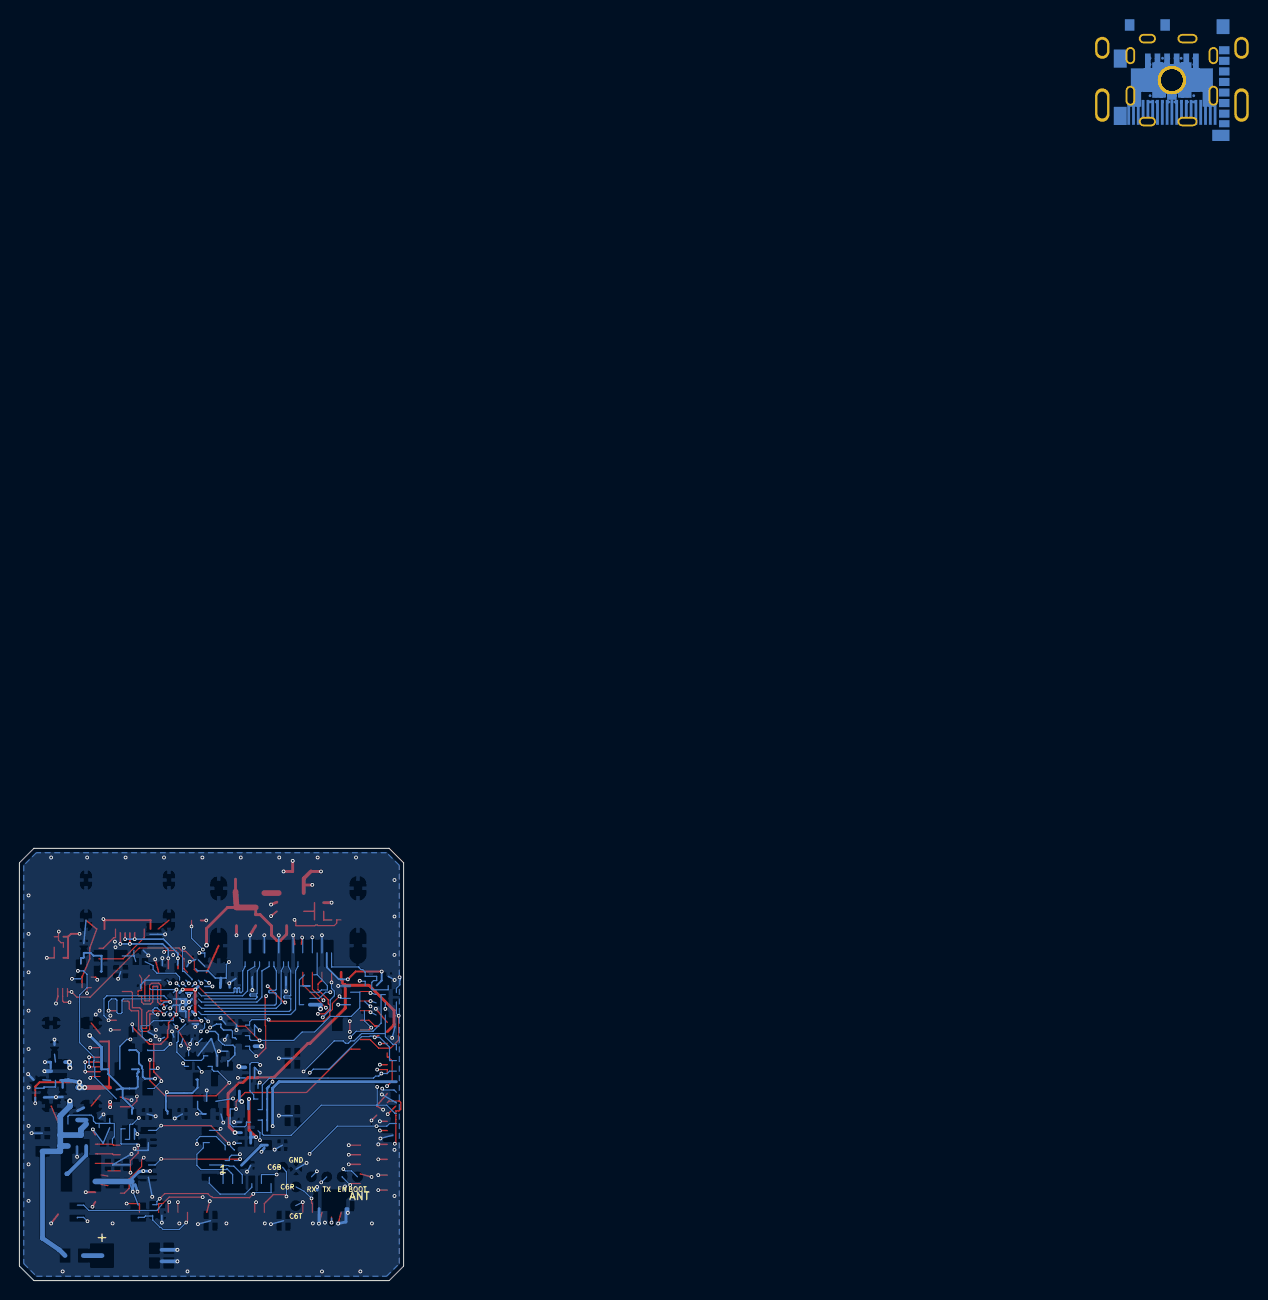
[picture p118: board p4_kvm_mini.kicad_pcb from below]

Board: 6 copper layers, 40.0 x 45.0 mm, 141 parts (101 on the bottom side), 108 nets.

Other parts of the board:
H1, H2, H3, H4: MH plated GND; MH_2.2_PTH_GND

Their connections:
GND: H1.1, H2.1, H3.1, H4.1; also elsewhere on the board
