ooropuloo/MFKVM/lay-board/r7f/tools/layout_pdf.py

# -*- coding: utf-8 -*-
# Board drawings a person can read: real traces, real placement, and the pin number on every pad.
# Everything is drawn from the .kicad_pcb, nothing by hand. Vector output, so it can be zoomed.
# Usage: python tools/layout_pdf.py kicad/p4_kvm_mini.kicad_pcb fab_r6/p4_kvm_mini_gerber.zip out/design.json out.pdf
import datetime, hashlib, json, math, re, sys

from reportlab.lib.pagesizes import A3, landscape
from reportlab.pdfbase import pdfmetrics
from reportlab.pdfbase.ttfonts import TTFont
from reportlab.pdfgen import canvas

PCB, GERBER, DESIGN, OUT = sys.argv[1:5]
pdfmetrics.registerFont(TTFont("JH", "C:/Windows/Fonts/msjh.ttc", subfontIndex=0))
pdfmetrics.registerFont(TTFont("JHB", "C:/Windows/Fonts/msjhbd.ttc", subfontIndex=0))
s = open(PCB, encoding="utf-8").read()
GHASH = hashlib.sha256(open(GERBER, "rb").read()).hexdigest()[:8]
# the Gerber the drawing belongs to: GERBER_SHA8 (first 8 hex of its sha256) must match when given; r6 pinned 525fb981 here
import os
assert GHASH == os.environ.get("GERBER_SHA8", GHASH), GHASH
REV = os.environ.get("BOARD_REV", "r6")
BBOX = {p["ref"]: p["bbox"] for p in json.load(open(DESIGN, encoding="utf-8"))["parts"]}
VALUE = {p["ref"]: p["value"] for p in json.load(open(DESIGN, encoding="utf-8"))["parts"]}
BUILD = datetime.datetime.now().strftime("%Y%m%d-%H%M")


def block(text, start):
    depth, i, q = 0, start, False
    while i < len(text):
        ch = text[i]
        if ch == '"' and text[i - 1] != "\\":
            q = not q
        elif not q:
            if ch == "(":
                depth += 1
            elif ch == ")":
                depth -= 1
                if depth == 0:
                    return text[start:i + 1]
        i += 1
    return text[start:]


SEGS = [(float(a), float(b), float(c_), float(d), float(w), l, n) for a, b, c_, d, w, l, n in re.findall(
    r'\(segment\s+\(start ([-\d.]+) ([-\d.]+)\)\s+\(end ([-\d.]+) ([-\d.]+)\)\s+\(width ([-\d.]+)\)\s+\(layer "([^"]+)"\)\s+\(net "([^"]*)"\)', s)]
VIAS = [(float(x), float(y), float(z), float(dr), n) for x, y, z, dr, n in re.findall(
    r'\(via\s+\(at ([-\d.]+) ([-\d.]+)\)\s+\(size ([\d.]+)\)\s+\(drill ([\d.]+)\).*?\(net "([^"]*)"\)', s, flags=re.S)]
EDGE = [(float(a), float(b), float(c_), float(d)) for a, b, c_, d in re.findall(
    r'\(gr_line\s+\(start ([-\d.]+) ([-\d.]+)\)\s+\(end ([-\d.]+) ([-\d.]+)\)\s+\(stroke.*?\)\s*\)\s+\(layer "Edge.Cuts"\)', s, flags=re.S)]
# r6 pinned its own counts (1249 segments, 283 vias); since r7d the drawing must have read every segment and via the board text holds
assert len(SEGS) == len(re.findall(r'\(segment\b', s)) and len(VIAS) == len(re.findall(r'\(via\b', s)) and len(EDGE) >= 8, (len(SEGS), len(VIAS), len(EDGE))
assert {q[5] for q in SEGS} <= {"F.Cu", "B.Cu", "In2.Cu"}, {q[5] for q in SEGS}
POURS = []
for m in re.finditer(r"\(zone\s", s):
    z = block(s, m.start())
    if "(keepout" in z:  # the J8 rule area has no net and no fill
        continue
    net = re.search(r'\(net "([^"]*)"\)', z).group(1)
    for f in re.finditer(r'\(filled_polygon\s+\(layer "([^"]+)"\)\s+\(pts(.*?)\)\s*\)', z, flags=re.S):
        pts = [(float(a), float(b)) for a, b in re.findall(r"\(xy ([-\d.]+) ([-\d.]+)\)", f.group(2))]
        POURS.append((f.group(1), net, pts))
FPS = []
idx = [m.start() for m in re.finditer(r"\(footprint\s", s)]
for st in idx:
    b = block(s, st)
    ref = re.search(r'\(property "Reference" "([^"]+)"', b)
    if not ref:
        continue
    t = re.search(r"translate ([-\d.]+) ([-\d.]+)", b)
    ox, oy = float(t.group(1)), float(t.group(2))
    side = re.search(r'\(layer "([FB])\.Cu"\)', b).group(1)
    pads = []
    for pm in re.finditer(r'\(pad "([^"]*)" (\w+) (\w+)\s+\(at ([-\d.]+) ([-\d.]+)(?: ([-\d.]+))?\)\s+\(size ([\d.]+) ([\d.]+)\)', b):
        pb = block(b, pm.start())
        n = re.search(r'\(net "([^"]*)"\)', pb)
        pads.append(dict(n=pm.group(1), kind=pm.group(2), shape=pm.group(3), x=ox + float(pm.group(4)), y=oy + float(pm.group(5)),
                         r=float(pm.group(6) or 0), w=float(pm.group(7)), h=float(pm.group(8)), net=n.group(1) if n else "",
                         drill=re.search(r"\(drill (?:oval )?([\d.]+)", pb).group(1) if "(drill" in pb else None))
    FPS.append(dict(ref=ref.group(1), x=ox, y=oy, side=side, pads=pads))
assert sum(len(f["pads"]) for f in FPS) > 450

W, H = landscape(A3)
c = canvas.Canvas(OUT, pagesize=(W, H))
c.setTitle(f"MF KVM v2 {REV} PCB 佈局與腳位")
PAGE = [0]
HDMI = re.compile(r"^(D\d|CK)_[PN]$")


def color(net):
    if net == "GND":
        return (0.42, 0.45, 0.48)
    if net in ("3V3", "5V", "V1V2", "V2V5", "AVDD25", "AVDD12", "VDD_MIPI", "VDDC", "SD1_VDD", "OSC_VDD", "HOST_VBUS", "SD_SRC", "SW"):
        return (0.82, 0.13, 0.13)
    if HDMI.match(net):
        return (0.50, 0.18, 0.72)
    if net.startswith("CSI"):
        return (0.90, 0.45, 0.03)
    if net.startswith("USB"):
        return (0.05, 0.42, 0.82)
    if net.startswith("SD_"):
        return (0.02, 0.56, 0.42)
    return (0.16, 0.20, 0.26)
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
