ooropuloo/MFKVM/lay-board/r7f/tools/r7c_csi_plan.py

# -*- coding: utf-8 -*-
"""r7c CSI re-plan: check a proposed routing of all three CSI pairs (data/r7c_csi.json) against the routed board, before it is built.

The proposal replaces every CSI segment and via on the board. Checked, against every other object on F.Cu and B.Cu of the current
board (tracks, vias, all pads including BGA balls and module pads; inner layers only see the new vias):
  clearance 0.1 mm to other nets; 2W = 0.254 mm edge to edge between different CSI pairs (Espressif p28);
  3W = 0.381 mm between non-adjacent segments of the same line (meander legs);
  via: hole to hole >= 0.2 mm, pad to pad >= 0.1 mm, holes not in a pad;
  corners: every bend 45 degrees or less (no right angles);
  length = sum of segments per net; within a pair <= 0.15 mm; across pairs <= 0.762 mm (Espressif 30 mil).
usage: r7c_csi_plan.py <out_dir> <plan.json> [png]
"""
import json
import math
import re
import sys

from shapely.geometry import LineString, Point, box
from shapely.ops import unary_union
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
