ooropuloo/MFKVM/(commit log)

2026-11-06 Add MF KVM designs: off-the-shelf and lay-board
    Two designs side by side. off-the-shelf builds from purchased boards plus
    a small ATX board. lay-board is a custom 6-layer single board (r5).
    Each README lists what is still missing. Nothing has been built or
    verified on hardware; firmware is compile-only.
    Copied from the working tree. Paths in scripts now derive from the script
    location, tool locations are overridable by environment variable, and
    order numbers, local paths and the LAN name in test fixtures are removed.
    Gerbers, STLs and KiCad boards are byte-identical to the source.
    Claude-Session: https://claude.ai/code/session_01Y2gaf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
    [BOM_JLC.csv, CONSIGNED_AND_NOT_FITTED.csv, atx.stl, c790.stl, core_board.stl, core_parts.stl, easyeda.json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]
2026-11-06 lay-board README: point to BUILD_v2.md for the ATX default
    The default is being changed, so the README no longer states a value.
    Claude-Session: https://claude.ai/code/session_01Y2gafkZviHqY45NzkXoZ7C
2026-11-06 lay-board: sync firmware state with ATX off by default
    Overlay CONFIG_KVM_ATX_ENABLE_DEFAULT=0, build record and sdkconfig
    evidence moved from v2r6 to v2r7. Patches 0001 and 0002 are unchanged.
    Gerbers, KiCad files and STLs are not touched. Compile-only, not run on
    hardware.
    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
2026-11-07 lay-board: fix CPL rotations for JLC's part library
    JLC's preview placed seven bottom-side parts wrong when given the KiCad
    angles: U2, U4, Q1, U10, U11 and U12 were off by 90 degrees and J7 by 180,
    so their leads missed the pads. U12 also hung over the board edge.
    Set U2, U4, Q1, U10, U11, U12 to 270 and J7 to 90. fab_pack.py now applies
    these through JLC_ROT, so regenerating the pack keeps them. The KiCad board
    and the Gerbers are unchanged.
    Checked by comparing pin 1 in JLC's preview with pin 1 in the KiCad board,
    after reloading the page. Manual rotation in the preview does not persist,
    so the fix has to live in the CPL. JLC's preview is for reference only and
    nothing has been built.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
    [CPL_JLC.csv]
2026-11-09 lay-board: add r7f (eFuse, ESD, series resistors, metal lid, fan duct)
    Sent to JLC for review, not paid, not built. Nothing here has been
    verified on hardware.
    Changes since r5 are in lay-board/r7f/R7F_REPORT.md. Gerber zip sha256
    5edbd11614de56c81819c0f49b667f6346e41d8fef006e6f3f2256d9243e99f7.
    All release gates pass, 126 mutations caught, case checks 99/99.
    Datasheets are left out; their copyright belongs to the vendors.
    Claude-Session: https://claude.ai/code/session_01Y2gafjdqayWJn5GVab6KCy
    [BOM_JLC.csv, CONSIGNED_AND_NOT_FITTED.csv, easyeda.json, easyeda_r7c.json, mf_kvm_fanduct.step, mf_kvm_fanduct.stl, mf_kvm_gapfill.step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]
2026-11-09 lay-board r7f: add board, case and size images to the README
    Renders, not photos. The board file has no 3D models, so parts are boxes
    drawn from their body outlines and heights; the fan is a placeholder.
    Also corrects the board size in the README to 40 x 45 mm.
    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
2026-11-09 README: lead with r7f and add an English version
    The home page now opens with the current revision: images, specs, what
    changed from r7e, and what has and has not been verified. The older
    designs stay below, marked as archive. README.en.md is the English
    version.
    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
2026-11-09 README: add a collapsible part reference table for the board images
    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
2026-11-09 lay-board r7f: remove local machine paths
    Tools now take KICAD_CLI, KICAD_TOOL_HOME, FREEROUTING_JAR, CASE_PY and
    MFKVM_SI_SCRIPTS from the environment, or work from the script's own
    location. Reports and PDFs drop the local path prefixes.
    Gerber, BOM and CPL are unchanged. The tools were only syntax-checked
    after this change, not run end to end from this repo.
    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
2026-11-11 lay-board r7f: show the round LCD in the case renders
    The renders left the LCD out, so the assembled view showed the aluminium
    plate through the empty window. Both views now include the 39 mm round
    LCD module from gen_case.py (LCD_D, LCD_T, seated under the lid top).
    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
2026-11-11 Add licences and take out third-party content
    Hardware is CERN-OHL-P-2.0, software Apache-2.0 and documentation
    CC-BY-4.0 (LICENSE, LICENSES/). The ExoAnchor MIT text is added.
    Vendor photos are replaced with own drawings, datasheet excerpts and the
    images made from the vendor STEP are removed, and the meshes converted
    from the DFRobot STEP are replaced with block envelopes, in the repo and
    in the built pages. THIRD_PARTY.md says how to regenerate them locally.
    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
    [core_board.stl, core_parts.stl]
2026-11-11 lay-board r7f: show an imagined status screen on the LCD renders
    The round LCD in both case renders now shows a mock KVM status screen.
    The subtitles say it is an illustration, not real firmware.
    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
